inacio-dev/tcc/monografia/2-textuais/3-metodologia.tex

\chapter{Metodologia}
\label{chap:metodologia}

Este trabalho é uma pesquisa aplicada de natureza experimental, com objetivo semelhante ao de \citeonline{shaik2025design}, conforme apresentado na fundamentação teórica. A seleção de tecnologias foi exploratória: diferentes controladores e protocolos de comunicação foram testados até encontrar a combinação com menor latência. Já a caracterização do sistema final é descritiva, com medição de latência, taxa de quadros, consumo de energia e resposta háptica comparados à literatura. O procedimento de desenvolvimento segue a prototipagem evolutiva --- cada subsistema é construído, testado individualmente e integrado antes de avançar ao próximo.

O sistema de \gls{teleoperacao} possui três camadas (\autoref{fig:arquitetura-projeto}): o veículo teleoperado com Raspberry Pi 4 embarcado, o cliente PC que exibe telemetria e encaminha comandos, e o simulador Logitech G923 conectado ao cliente via \gls{USB}. Veículo e cliente se comunicam por \gls{UDP}, seguindo a abordagem de integração de múltiplos sensores de \citeonline{bobrovsky2023development}. O desenvolvimento começou pela montagem do chassi, passou pela integração dos sensores e atuadores com o Raspberry Pi, depois pela comunicação \gls{UDP} com o cliente e integração do G923, até chegar à validação do sistema completo em ambiente controlado e em campo, cujo protocolo é detalhado na \autoref{sec:protocolo-experimental}.

\begin{figure}[!h]
	\captionsetup{width=16cm}
	\Caption{\label{fig:arquitetura-projeto} Arquitetura do sistema de teleoperação com feedback háptico}
	\UFCfig{}{
		
	}{
		\Fonte{elaborado pelo autor.}
	}
\end{figure}

\section{Protocolo de Comunicação UDP}
\label{sec:protocolo-udp}

O \gls{UDP} foi adotado como protocolo de comunicação entre o veículo e o cliente pelas razões discutidas na \autoref{sec:protocolos-comunicacao}: menor \gls{latencia} que o \gls{TCP}, sem estabelecimento de conexão nem retransmissão de pacotes perdidos. Para o controle em tempo real do veículo teleoperado, qualquer atraso entre o comando do operador e a resposta do veículo torna a condução imprecisa, e o \gls{UDP} minimiza esse atraso.

\subsection{Evolução das Decisões de Arquitetura de Comunicação}
\label{subsec:evolucao-decisoes-comunicacao}

O objetivo inicial era controlar múltiplos veículos por meio de um servidor central que redirecionaria mensagens entre clientes e veículos. Na prática, as limitações de latência e a complexidade de transmitir vídeo por rádio levaram a uma arquitetura diferente.

\subsubsection{Testes com Diferentes Controladores e Tecnologias de Comunicação}

A primeira tentativa de comunicação usou um Arduino Mega com módulo ESP8266 no veículo, conectado via WiFi a um Raspberry Pi 4 (servidor) e um notebook (cliente). A latência média ficou em 60ms. O ESP8266 era o gargalo: ele precisa alternar entre modos de leitura e escrita a cada mensagem, e com o Raspberry Pi enviando pacotes a cada 1ms, o módulo simplesmente não acompanhava. O ESP32 DevKit V1 foi testado justamente pelo processador dual-core, que permite dedicar um núcleo à recepção de comandos e outro ao envio de respostas, sem a alternância que travava o ESP8266. A latência caiu para 40ms (melhoria de 33\%), mas ainda longe da meta de 10ms. Com módulos de rádio NRF24L01 com antena externa a latência chegou a 2ms, com alcance de até 800 metros. Para comandos de controle (pacotes de dezenas de bytes) o NRF24L01 funciona bem, mas para vídeo a conta não fecha: frames \gls{MJPEG} de 10 a 50~KB precisariam ser fragmentados em pacotes de 32 bytes a 2~Mbps, e escalar para mais veículos exigiria montar uma rede mesh sobre rádio --- algo que tomaria tempo demais para o cronograma disponível. A \autoref{fig:comparativo-latencia} resume as latências medidas.

\begin{figure}[!ht]
	\captionsetup{width=16cm}
	\Caption{\label{fig:comparativo-latencia} Latência média por configuração de hardware testada}
	\UFCfig{}{
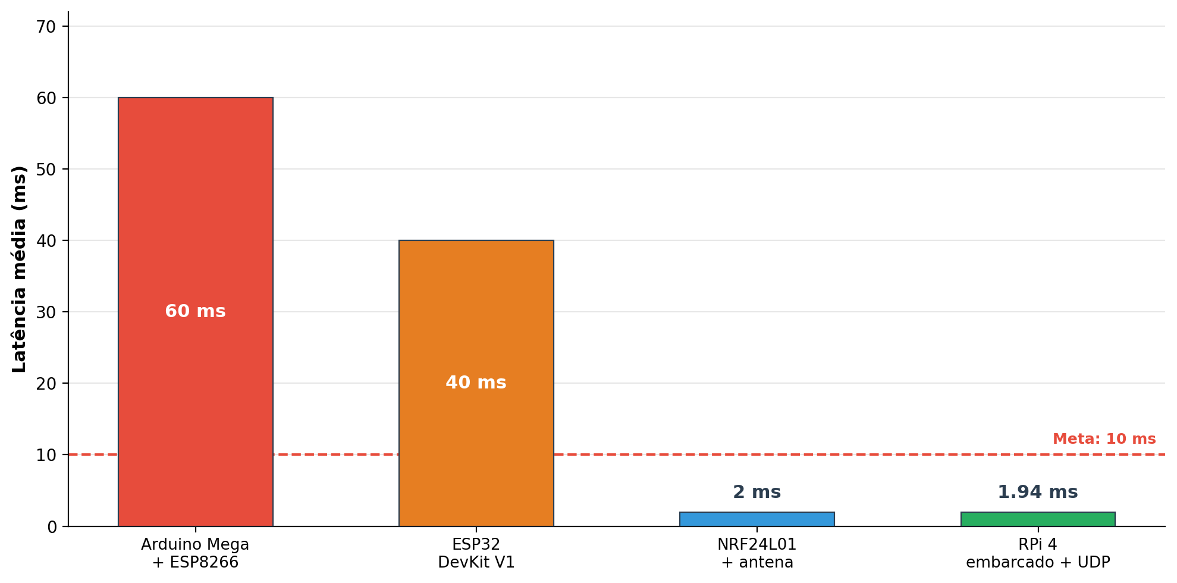
[picture p1: monografia/figuras/comparativo_latencia_comunicacao.png]
		
	}{
		\Fonte{elaborado pelo autor.}
	}
\end{figure}

Nos testes com rede mesh NRF24L01, cada salto entre antenas acrescentava cerca de 2ms e introduzia erros na resposta de status do veículo. Foi tentado usar o payload de \gls{ACK} (a confirmação automática que o NRF24L01 envia ao transmissor) para retornar dados dos sensores, mas o esforço de desenvolvimento necessário era incompatível com o cronograma do projeto. O ESP-NOW, que faz mesh entre ESP32, foi descartado pelo alcance de apenas 50 metros e custo mais alto por unidade.

\subsubsection{Decisão Final: Arquitetura UDP com Raspberry Pi e Logitech G923}

A análise comparativa dos testes (\autoref{tab:comparativo-comunicacao}) definiu a arquitetura final: protocolo \gls{UDP}, Raspberry Pi 4 embarcado no veículo e simulador Logitech G923.

\begin{table}[!h]
\captionsetup{width=16cm}
\Caption{\label{tab:comparativo-comunicacao} Comparativo de latência entre tecnologias de comunicação testadas}
\IBGEtab{}{%
	\begin{tabular}{p{5cm}p{3cm}p{3cm}p{4cm}}
		\toprule
		Configuração & Latência Média & Alcance & Observações \\
		\midrule \midrule
		Arduino Mega + ESP8266 & 60ms & WiFi local & Gargalo no ESP8266 \\
		\midrule
		ESP32 DevKit V1 & 40ms & WiFi local & Melhoria de 33\% \\
		\midrule
		NRF24L01 + antena & 2ms & 800m & Comunicação ponto-a-ponto \\
		\midrule
		NRF24L01 mesh & 2ms + 2ms/salto & Extensível & Complexidade elevada \\
		\midrule
		ESP-NOW (ESP32) & Similar ao WiFi & 50m & Custo elevado, alcance limitado \\
		\midrule
		\textbf{RPi 4 embarcado + UDP} & \textbf{1,94ms} & \textbf{WiFi local} & \textbf{Solução adotada} \\
		\bottomrule
	\end{tabular}%
}{%
\Fonte{elaborado pelo autor.}%
\Nota{Os valores de latência do Arduino Mega + ESP8266, ESP32, NRF24L01 e ESP-NOW foram obtidos em testes experimentais do autor durante a fase de prototipagem. O valor de 1,94ms do Raspberry Pi 4 corresponde à latência média UDP medida durante os testes de validação do sistema final.}%
}
\end{table}

A \autoref{tab:comparativo-latencia-literatura} (ver \autoref{sec:protocolos-comunicacao}) reúne latências \gls{UDP} reportadas na literatura, que vão de 2~ms em simulação a quase 1 segundo em topologias de simulação complexas. O valor de 1,94~ms medido neste projeto é compatível com \gls{UDP} sobre WiFi 802.11ac em rede local sem saltos intermediários.

Com o Raspberry Pi 4 embarcado no próprio veículo, captura de vídeo, codificação \gls{MJPEG} e transmissão \gls{UDP} acontecem no mesmo dispositivo, sem a necessidade de traduzir entre protocolos de rádio e rede \gls{IP} que o NRF24L01 exigiria. O Raspberry Pi acumula as funções de controlador do veículo e servidor \gls{UDP}, processando vídeo da câmera OV5647, dados do sensor BMI160 e comandos de controle. A descoberta de dispositivos na rede local usa o protocolo \gls{mDNS}: o veículo é acessível como \texttt{f1car.local} e o cliente como \texttt{f1client.local}, sem configuração manual de endereços \gls{IP}.

Durante os testes, o vídeo e os sensores cortavam simultaneamente por cerca de 5 segundos a cada 20--60 segundos de operação. A instrumentação de tempo em cada thread do Raspberry Pi revelou que o bloqueio ocorria exclusivamente nas chamadas \texttt{sendto()}, enquanto locks, \gls{I2C} e serialização \gls{JSON} operavam normalmente. A causa era dupla. Originalmente, cada chamada \texttt{sendto()} recebia o \textit{hostname} \texttt{f1client.local} como destino, o que disparava resolução \gls{mDNS} pelo Avahi --- o serviço do sistema operacional que roda em segundo plano (\textit{daemon}) e traduz nomes \texttt{.local} para endereços IP na rede. Com 160 pacotes por segundo (100Hz de sensores e 60Hz de vídeo), qualquer expiração do \textit{cache} \gls{mDNS} bloqueava ambos os \textit{sockets} por exatamente 5 segundos, que é o \textit{timeout} padrão do Avahi. A correção foi resolver o \textit{hostname} uma única vez na inicialização via \texttt{socket.gethostbyname()} e armazenar o \gls{IP} numérico, re-resolvendo apenas quando o veículo envia um comando \texttt{CONNECT} (para atualizar o \gls{IP} caso o \gls{DHCP} tenha atribuído outro endereço). O segundo fator era o gerenciamento de energia WiFi: o \textit{driver} \texttt{brcmfmac} do Raspberry Pi 4 desliga periodicamente a antena WiFi para economizar energia, e enquanto a antena está desligada, qualquer \texttt{sendto()} fica bloqueado esperando a reativação. A desativação permanente via NetworkManager (\texttt{wifi.powersave = 2}) eliminou esses bloqueios. O \autoref{alg:resolucao-mdns} descreve o procedimento de resolução e cache de IP adotado em ambos os lados da comunicação (veículo e cliente).

\begin{algorithm}[h!]
	\SetSpacedAlgorithm
	\caption{\label{alg:resolucao-mdns}Resolução \gls{mDNS} com cache de \gls{IP}}
	\Entrada{hostname\_destino (ex: ``f1client.local'')}
	\Saida{ip\_numerico utilizado em todas as chamadas sendto()}
	\Inicio{
		// Fase 1: Resolução única na inicialização\;
		\Se{hostname\_destino contém ``.local''}{
			ip\_numerico $\leftarrow$ resolver\_dns(hostname\_destino)\;
			\Se{resolução falhou}{
				ip\_numerico $\leftarrow$ hostname\_destino\;
				// Usa hostname direto como fallback\;
			}
		}
		\Senao{
			ip\_numerico $\leftarrow$ hostname\_destino\;
		}
		registrar\_cliente(ip\_numerico, porta)\;
		// Fase 2: Todas as transmissões usam IP numérico\;
		\Para{cada pacote a enviar}{
			sendto(dados, ip\_numerico, porta)\;
			// Sem resolução DNS --- envio direto\;
		}
		// Fase 3: Re-resolução sob demanda (comando CONNECT)\;
		\Se{comando CONNECT é enviado}{
			novo\_ip $\leftarrow$ resolver\_dns(hostname\_destino)\;
			\Se{novo\_ip $\neq$ ip\_numerico}{
				ip\_numerico $\leftarrow$ novo\_ip\;
				atualizar\_cliente(ip\_numerico, porta)\;
			}
		}
	}
\end{algorithm}

A comunicação utiliza três portas \gls{UDP} separadas (\autoref{tab:arquitetura-portas-udp}). A separação existe porque pacotes de vídeo de 50 KB bloqueariam pacotes de sensores de 200 bytes se compartilhassem a mesma porta, e o sistema de \gls{forcefeedback} precisa de taxa consistente de 100Hz com latência inferior a 10ms para que a resposta tátil no volante seja perceptível.

\begin{table}[!h]
\captionsetup{width=16cm}
\Caption{\label{tab:arquitetura-portas-udp} Arquitetura de comunicação UDP com três portas separadas}
\IBGEtab{}{%
	\begin{tabular}{ccp{5cm}ccc}
		\toprule
		Porta & Direção & Conteúdo & Taxa & Pacote & Buffer \\
		\midrule \midrule
		9999 & RPi $\rightarrow$ PC & Vídeo \gls{MJPEG} + energia + temperatura & 60Hz & 10--50 KB & 64 KB \\
		\midrule
		9997 & RPi $\rightarrow$ PC & Sensores BMI160 (aceleração e giroscópio) & 100Hz & 200 B & 32 KB \\
		\midrule
		9998 & Bidirecional & Comandos de controle (direção, acelerador e freio a 100Hz; troca de marcha sob demanda) & 100Hz + on-demand & 50 B & 128 KB \\
		\bottomrule
	\end{tabular}%
}{%
\Fonte{elaborado pelo autor.}%
}
\end{table}

O simulador Logitech G923, detalhado na \autoref{sec:arquitetura-simulador}, conecta-se ao cliente PC via \gls{USB} e é acessado pelo sistema operacional como dispositivo \gls{HID} padrão, sem necessidade de drivers proprietários. A arquitetura final tem dois saltos de comunicação: Veículo $\leftrightarrow$ Cliente $\leftrightarrow$ Simulador.

\subsection{Justificativa para UDP Simples}
\label{subsec:justificativa-udp}

O UDP simples foi escolhido em vez de variantes como UDP-RT \cite{lu2023udprt} ou UDP com ACK \cite{bekele2024performance}, cujos trade-offs foram discutidos na \autoref{sec:protocolos-comunicacao}. Em rede local WiFi 802.11ac, a perda de pacotes já é desprezível, e o custo extra de CPU que o ACK introduz (28 a 33\% segundo \citeonline{bekele2024performance}) não se justifica.

A razão principal para o \gls{UDP} neste projeto é o comportamento diante de perda de pacotes. Com \gls{UDP}, quando um frame de vídeo é perdido, o próximo é exibido normalmente --- o operador percebe no máximo uma queda pontual de \textit{frame rate}. Com TCP, a perda de um pacote trava a entrega de todos os seguintes até a retransmissão ser concluída (\textit{head-of-line blocking}). Em uma transmissão a 60~Hz, essa retransmissão acumula dezenas de frames no buffer: o vídeo congela e depois descarta os frames acumulados de uma vez. Para sensores a 100~Hz, o problema é pior: o \textit{force feedback} depende de dados atualizados, e receber um pacote de sensor com 50~ms de atraso por retransmissão TCP produz uma resposta tátil que não corresponde mais ao estado do veículo. Em operação de tempo real, perder um dado antigo é melhor do que atrasar um dado novo.

Os \textit{buffers} de \textit{socket} foram dimensionados de acordo com cada tipo de tráfego: 64~KB para a porta de vídeo (porta 9999), onde frames de até 50~KB precisam caber inteiros; 32~KB para a porta de sensores (porta 9997), onde o pacote é pequeno mas a latência precisa ser baixa para o \textit{force feedback}; e 128~KB para a recepção de comandos no Raspberry Pi (porta 9998), para absorver picos de comandos simultâneos. \textit{Buffers} maiores absorvem picos de tráfego, mas os dados ficam mais tempo na fila antes de serem consumidos; \textit{buffers} menores descartam pacotes quando o consumidor não acompanha a taxa de produção, mas garantem que o dado lido é sempre recente.

As latências de \texttt{sendto()} medidas no sistema final após essas correções são apresentadas no \autoref{chap:resultados}, juntamente com as demais métricas de validação da comunicação \gls{UDP}.

\subsection{Limitações de Alcance e Considerações de Escala}
\label{subsec:limitacoes-alcance}

O alcance do WiFi limita o tamanho da pista em que o veículo pode operar. Na escala 1:5, circuitos de Fórmula 1 reais teriam entre 600 m (Mônaco, 3,337 km real) e 1.400 m (Spa-Francorchamps, 7,004 km real) de comprimento.

A \autoref{tab:alcance-wifi-pistas} mostra a viabilidade de cobertura WiFi para pistas nessa escala, com soluções de infraestrutura para cada faixa de distância.

\begin{table}[!h]
\captionsetup{width=16cm}
\Caption{\label{tab:alcance-wifi-pistas} Análise de cobertura WiFi para pistas de F1 em escala 1:5}
\IBGEtab{}{%
	\begin{tabular}{p{4cm}p{2.5cm}p{2.5cm}p{5.5cm}}
		\toprule
		Circuito Real & Extensão Real & Escala 1:5 & Solução de Cobertura \\
		\midrule \midrule
		Mônaco & 3,337 km & 667 m & Roteador central + 1 repetidor \\
		\midrule
		Interlagos & 4,309 km & 862 m & 2 access points mesh \\
		\midrule
		Silverstone & 5,891 km & 1.178 m & 3 access points mesh \\
		\midrule
		Spa-Francorchamps & 7,004 km & 1.401 m & 4 access points mesh ou 5G \\
		\bottomrule
	\end{tabular}%
}{%
\Fonte{elaborado pelo autor.}%
}
\end{table}

Para pistas de até 600 m (circuitos compactos como Mônaco), um sistema mesh WiFi como o TP-Link Deco M4 (AC1200, até 350~m² com 2 unidades, potência $<$20~dBm em 2,4~GHz e $<$23~dBm em 5~GHz) com unidades conectadas por cabo Ethernet oferece cobertura adequada em ambiente aberto. Pistas maiores precisam de unidades adicionais do sistema mesh, acrescentando cerca de 2 ms de latência por salto. Redes 5G são outra opção, com cobertura mais ampla e latência menor, mas dependem de operadoras e custam mais.

% ============================================================================
% ARQUITETURA DO VEÍCULO (RASPBERRY PI 4)
% ============================================================================
\section{Arquitetura do Veículo (Raspberry Pi 4)}
\label{sec:arquitetura-veiculo}

O processador embarcado no veículo é um Raspberry Pi 4 Model B com 8GB de \gls{RAM}. O hardware foi escolhido porque consegue codificar vídeo \gls{MJPEG} em tempo real, comunicar via \gls{UDP} nativo e controlar múltiplos periféricos \gls{I2C} simultaneamente, conforme validado nos testes descritos na \autoref{subsec:evolucao-decisoes-comunicacao}. O diagrama elétrico completo está no \autoref{apendice:diagrama-rpi}.

O software embarcado foi escrito em Python 3.11.2 no Visual Studio Code. A \autoref{tab:bibliotecas-rpi} lista as bibliotecas utilizadas e a \autoref{tab:componentes-veiculo} lista os componentes embarcados no veículo.

\begin{table}[!h]
\captionsetup{width=16cm}
\Caption{\label{tab:bibliotecas-rpi} Bibliotecas Python utilizadas no Raspberry Pi}
\IBGEtab{}{
\begin{tabular}{p{4.5cm}p{10cm}}
\toprule
\textbf{Biblioteca} & \textbf{Função} \\
\midrule
picamera2 & Captura de vídeo via interface \gls{CSI} com codificação \gls{MJPEG} por hardware \\
smbus2 & Comunicação \gls{I2C} direta com sensores BMI160 e INA219 \\
pyserial & Comunicação serial \gls{USB} com Arduino Pro Micro para monitoramento de energia \\
adafruit-circuitpython-pca9685 & Controle do driver \gls{PWM} PCA9685 para acionamento de servos \\
adafruit-circuitpython-motor & Controle de servomotores via classe \texttt{Servo} do módulo \texttt{adafruit\_motor} \\
adafruit-blinka & Camada de compatibilidade CircuitPython para Raspberry Pi (módulos \texttt{board} e \texttt{busio}) \\
RPi.GPIO & Controle de pinos \gls{GPIO} para \gls{ponteh} BTS7960 do motor DC \\
numpy & Processamento numérico de dados de sensores e cálculos de telemetria \\
\bottomrule
\end{tabular}
}{
\Fonte{elaborado pelo autor.}
}
\end{table}

\begin{table}[!h]
\captionsetup{width=16cm}
\Caption{\label{tab:componentes-veiculo} Especificações dos componentes do veículo teleoperado}
\IBGEtab{}{%
	\begin{tabular}{p{3.5cm}p{6cm}p{6cm}}
		\toprule
		Componente & Especificação & Função no Sistema \\
		\midrule \midrule
		Raspberry Pi 4 Model B & Broadcom BCM2711, Quad core Cortex-A72 64-bit @ 1.8GHz, 8GB RAM & Núcleo de controle e comunicação do veículo, servidor \gls{UDP}, processamento de vídeo e controle de sensores \\
		\midrule
		Câmera OV5647 & 5MP, 2592×1944 pixels, vídeo até 1080p/30fps, interface CSI & Captura de vídeo em 640×480/60fps para transmissão via \gls{UDP} \\
		\midrule
		Sensor BMI160 \cite{bosch2015bmi160} & \gls{IMU} 6 eixos, ±2g/±250°/s, 16 bits, \gls{I2C}, 100Hz sampling & Detecção de \glspl{forcag}, aceleração e velocidade angular para force feedback \\
		\midrule
		Motor DC 775 & 24V, 12.000 RPM, com transmissão manual de 5 marchas & Propulsão principal do veículo com zonas de eficiência F1 \\
		\midrule
		Ponte H BTS7960 \cite{infineon2013btn7960} & 5.5--27Vdc, corrente contínua 40A, proteção térmica integrada & Controle bidirecional de velocidade do motor de propulsão \\
		\midrule
		Servo MG996R (3x) & 4.8--7.2V, torque 11kg.cm, rotação 180°, velocidade 0.14s/60° & Controle de direção e sistema de freio dianteiro/traseiro \\
		\midrule
		PCA9685 PWM Driver \cite{nxp2015pca9685} & 16 canais, 12 bits, \gls{I2C}, endereço \texttt{0x41} (A0 soldado) & Controle de servos (freio dianteiro, traseiro e direção) \\
		\midrule
		Arduino Pro Micro & ATmega32U4, 16MHz, ADC 10 bits, USB nativo & Leitura de sensores ACS758 e tensão da bateria via USB serial \\
		\midrule
		INA219 \cite{ti2015ina219} & Sensor corrente/tensão, \gls{I2C}, endereço \texttt{0x40} & Monitoramento de energia do Raspberry Pi \\
		\midrule
		Sensor DS18B20 \cite{maxim2019ds18b20} & Digital 1-Wire, $-55$°C a $+125$°C, precisão $\pm0{,}5$°C & Monitoramento de temperatura do motor e eletrônica \\
		\midrule
		ACS758 100A \cite{allegro2018acs758} & Sensor Hall, sensibilidade 20mV/A, largura de banda 120kHz & Medição de corrente do motor DC 775 via Arduino Pro Micro \\
		\midrule
		ACS758 50A \cite{allegro2018acs758} & Sensor Hall, sensibilidade 40mV/A, largura de banda 120kHz & Medição de corrente dos servos via Arduino Pro Micro \\
		\midrule
		Regulador XL4015 \cite{xlsemi2017xl4015} & Step-down 8--36V para 1.25--32V, 5A, eficiência 96\% & Alimentação 5V do Raspberry Pi a partir da bateria \\
		\midrule
		UBEC 15A & 6--12S entrada, 5.25V saída, 15A contínuo, 30A pico & Alimentação dos servos MG996R \\
		\midrule
		Bateria \gls{LiPo} 3S & Turnigy Graphene 6000mAh, 11.1V, 75C descarga & Fonte de energia principal do veículo \\
		\midrule
		Caixa Diferencial HSP 1:10 & Modelo 94111/94123, relação 02051 & Transmissão diferencial para rodas traseiras \\
		\midrule
		Rolamento Unidirecional CSK8PP & $8\times22\times9$mm, uma direção de rotação & Proteção contra torque reverso no eixo do motor de propulsão \\
		\midrule
		Amortecedores RC 1:10 & Compatível Axial SCX10/TRX4, óleo ajustável & Suspensão do veículo com amortecimento ajustável \\
		\midrule
		Chassi FV01 & Escala 1:5 (modificada), impressão 3D em \gls{PLA}, pneus de borracha & Estrutura do veículo com suspensão push rod e aerodinâmica funcional \\
		\bottomrule
	\end{tabular}%
}{%
\Fonte{elaborado pelo autor.}%
}
\end{table}

\subsection{Chassi e Estrutura}
\label{subsec:chassi-estrutura-veiculo}

O veículo utiliza o chassi FV01, um modelo de carro de Fórmula 1 projetado para impressão 3D por \citeonline{velocityprojects2024fv01}. O modelo original possui escala 1:7, porém foi modificado para escala 1:5 neste projeto para acomodar o Raspberry Pi 4, sensores, drivers e demais componentes eletrônicos. O chassi foi impresso em PLA com pneus de borracha para melhor aderência.

A suspensão push rod independente transmite as forças de curva e frenagem ao chassi, onde o sensor BMI160 as detecta como variações de força G. O diferencial gera comportamento diferenciado entre rodas internas e externas em curvas.

As peças foram impressas em uma Creality Ender 3 S1 com fatiamento no Ultimaker Cura 5.11 \cite{ultimaker2024cura}. Os parâmetros de impressão estão no \autoref{apendice:specs-equipamentos}. A \autoref{fig:chassi-fv01} mostra o modelo original do chassi FV01.

\begin{figure}[!ht]
	\captionsetup{width=16cm}
	\Caption{\label{fig:chassi-fv01} Modelo do chassi FV01 projetado para impressão 3D}
	\UFCfig{}{
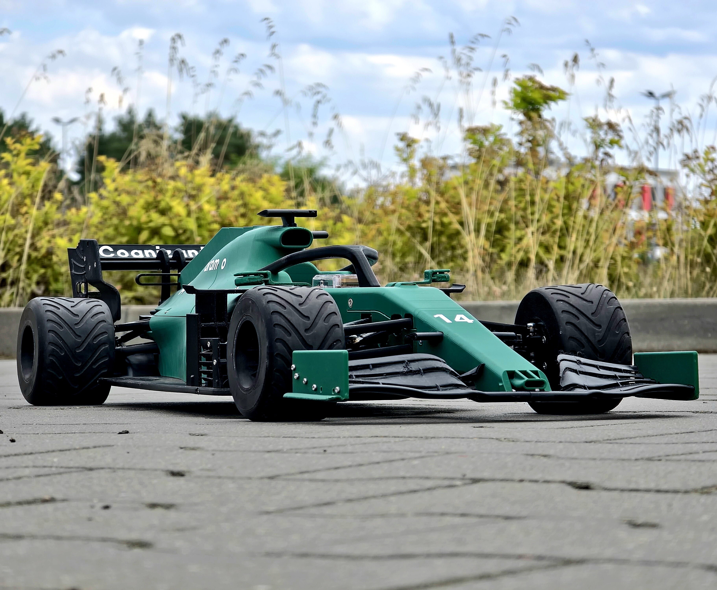
[picture p2: monografia/figuras/FV01-1.jpg]
		
	}{
		\Fonte{\citeonline{velocityprojects2024fv01}.}
	}
\end{figure}

As modificações de escala e a disposição interna dos componentes foram planejadas no Tinkercad \cite{autodesk2024tinkercad}. Na \autoref{fig:tinkercad-layout}, a bateria LiPo 3S (em vermelho) ocupa a região central inferior e o motor DC 775 com a transmissão (em laranja) fica na parte traseira. A simulação confirmou que a escala 1:5 deixa espaço suficiente para os componentes eletrônicos.

\begin{figure}[!ht]
	\captionsetup{width=16cm}
	\Caption{\label{fig:tinkercad-layout} Simulação no Tinkercad da organização interna dos componentes no chassi FV01 modificado}
	\UFCfig{}{
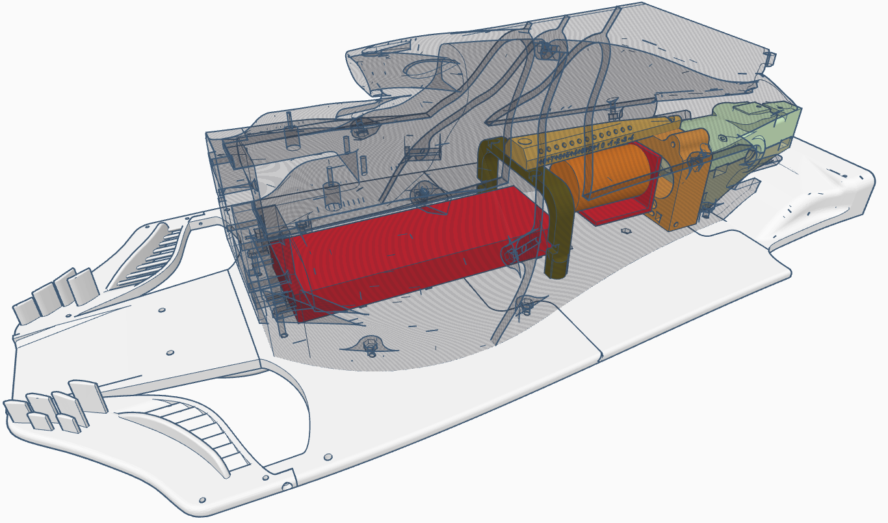
[picture p3: monografia/figuras/thinckercad.png]
		
	}{
		\Fonte{elaborado pelo autor.}
	}
\end{figure}

\subsection{Sistema de Sensoriamento}
\label{subsec:sensoriamento-veiculo}

Os sensores do veículo capturam dados em tempo real e os transmitem ao cliente via \gls{UDP}, onde são processados para telemetria e cálculo de \textit{force feedback}.

\subsubsection{Câmera OV5647}

A câmera OV5647, conectada via interface \gls{CSI}, opera em duas resoluções selecionáveis: 480p (640$\times$480) e 720p (1280$\times$720). A resolução padrão é 480p a 30 \gls{FPS}, por consumir menos banda na transmissão \gls{UDP}. O operador pode alternar entre 480p e 720p pela interface do cliente, que envia o comando ao Raspberry Pi via \gls{UDP}. O stream de vídeo é codificado em \gls{MJPEG} (Motion JPEG), onde cada frame é comprimido independentemente como imagem JPEG. Essa escolha foi motivada pela robustez contra perda de pacotes \gls{UDP}: enquanto codecs como H.264 utilizam P-frames que dependem de frames anteriores (causando distorção em cascata quando há perda de pacotes), o \gls{MJPEG} transmite frames independentes, limitando o impacto de perdas a um único frame. O trade-off é maior uso de banda (aproximadamente 4x mais que H.264), compensado pela qualidade de imagem consistente e simplicidade de decodificação via OpenCV.

\subsubsection{Sensor IMU BMI160}

O sensor inercial BMI160 conectado via barramento \gls{I2C} (endereço \texttt{0x68}) fornece dados de aceleração (3 eixos) e velocidade angular (3 eixos) a 100Hz. A configuração utiliza faixa de $\pm$2g para acelerômetro e $\pm$250°/s para giroscópio, que oferecem maior resolução (61~$\mu$g/LSB e 7,6~m°/s/LSB) para captura de forças G em manobras típicas de veículos RC. Os dados são transmitidos ao cliente em formato \gls{JSON} via \gls{UDP}, onde são processados para cálculo de force feedback e estimativa de velocidade.

O BMI160 é suscetível a \textit{brown-out} elétrico durante picos de corrente do motor DC 775, que causam quedas momentâneas de tensão no barramento 3,3V do Raspberry Pi. Quando isso ocorre, o sensor realiza um \textit{power-on reset} interno e entra em modo \textit{suspend}, onde os registradores de dados retornam zero indefinidamente apesar de o barramento \gls{I2C} continuar funcionando. Para mitigar esse problema, o software implementa um \textit{watchdog} que monitora leituras consecutivas zeradas. Após 3 leituras zeradas consecutivas (30ms a 100Hz), o sistema executa uma rotina de recuperação que reativa a unidade de gerenciamento de energia (PMU) do sensor, reconfigura os parâmetros de faixa e taxa de amostragem, e verifica o sucesso da recuperação. Os tempos de recuperação seguem as especificações do \textit{datasheet} BST-BMI160-DS000-09: 3,8ms para ativação do acelerômetro e 80ms para o giroscópio. Caso a reativação da PMU falhe, o sistema executa um \textit{soft reset} completo do sensor como segunda tentativa de recuperação.

\subsubsection{Monitoramento de Temperatura}

O sensor digital DS18B20 \cite{maxim2019ds18b20} conectado via protocolo 1-Wire (GPIO4) monitora a temperatura do motor e da eletrônica embarcada a 1Hz. O sensor possui faixa de $-55$°C a $+125$°C com precisão de $\pm0{,}5$°C e validação de dados por CRC. O software implementa alertas térmicos em três níveis: aviso a 65°C, crítico a 80°C e desligamento automático a 85°C. Os dados de temperatura são incluídos nos pacotes \gls{UDP} da porta 9999 e exibidos na interface do cliente.

\subsubsection{Monitoramento de Energia}

O sistema de monitoramento de energia utiliza uma arquitetura híbrida com dois subsistemas complementares: um Arduino Pro Micro (ATmega32U4) dedicado à leitura dos sensores de corrente ACS758 e tensão da bateria, e um sensor INA219 (endereço \gls{I2C} \texttt{0x40}) para monitoramento de corrente e tensão do Raspberry Pi.

Inicialmente, o projeto utilizava um ADC externo ADS1115 (16 bits, \gls{I2C}) conectado diretamente ao Raspberry Pi para leitura dos sensores ACS758. Essa abordagem foi abandonada por incompatibilidade de referência de tensão: os ACS758 possuem saída ratiométrica (ponto zero em VCC/2), porém o ADS1115 opera com referência interna própria (PGA configurável), incapaz de acompanhar variações na alimentação dos sensores. Na prática, uma queda de 5,00V para 4,90V no VCC dos ACS758 deslocava o offset zero em 50mV, introduzindo erro de 2,5A no sensor de 100A (sensibilidade de 20mV/A). Além disso, cada ciclo de leitura do ADS1115 (três canais multiplexados) ocupava aproximadamente 25ms do barramento \gls{I2C}, já compartilhado com BMI160 (100Hz), PCA9685 e INA219. O ADS1115 também não dispunha de canal livre para medição da tensão da bateria.

A migração para o Arduino Pro Micro eliminou esses problemas através de medição ratiométrica: como o Pro Micro e os ACS758 compartilham a mesma alimentação de 5V, qualquer variação de tensão afeta o ADC e os sensores igualmente, cancelando automaticamente o erro. O Pro Micro realiza oversampling de 50 amostras por leitura em cada canal analógico, reduzindo o ruído por um fator de $\sqrt{50} \approx 7$. Os dados são transmitidos ao Raspberry Pi via USB serial dedicado a 115200 baud no formato \texttt{PWR:<v\_bat>,<i\_servos>,<i\_motor>} a 10Hz, liberando completamente o barramento \gls{I2C} para os demais sensores. A tensão da bateria LiPo 3S é medida através de um divisor resistivo (20k$\Omega$/10k$\Omega$) no pino A0, com razão de 1:3 que mantém a tensão no ADC dentro da faixa segura de 0--5V. Os valores de calibração (offset zero de cada ACS758) são armazenados na EEPROM do ATmega32U4, persistindo entre reinicializações.

O sensor INA219 permanece no barramento \gls{I2C} para monitoramento do Raspberry Pi, pois opera na faixa de corrente de 0--3,2A com resolução de 0,8mA, muito superior à precisão dos ACS758 nessa faixa. Cada saída dos sensores ACS758 possui um filtro RC de hardware (1k$\Omega$ + 100nF, frequência de corte de 1,6kHz) para remoção de ruído eletromagnético do motor e chaveamento da ponte H antes da amostragem pelo ADC.

\subsection{Controle de Propulsão e Direção}
\label{subsec:propulsao-direcao-veiculo}

O sistema de propulsão utiliza motor DC 775 de 24V controlado por ponte H BTS7960, enquanto direção e freios são acionados por servos MG996R através do driver PWM PCA9685 (endereço \gls{I2C} \texttt{0x41}, com pino A0 soldado para evitar conflito com o INA219 no endereço padrão \texttt{0x40}).

\subsubsection{Motor de Propulsão}

O motor DC 775 opera com transmissão manual de 5 marchas, simulando comportamento de veículo real. O controle de velocidade é realizado via PWM através do driver BTS7960. A dinâmica de aceleração é modelada como um sistema de 1ª ordem conforme descrito por \citeonline{franklin2013sistemas} (ver \autoref{subsec:sistemas-primeira-ordem}), cuja função de transferência no domínio de Laplace é:

\begin{equation}
\label{eq:funcao-transferencia}
G(s) = \frac{Y(s)}{U(s)} = \frac{K}{\tau_{eff} \cdot s + 1}
\end{equation}

\noindent onde $Y(s)$ é o PWM do motor (saída), $U(s)$ é a entrada degrau unitário, $K$ é o ganho estático (igual ao PWM alvo da marcha, ou seja, o limitador) e $\tau_{eff}$ é a constante de tempo efetiva. A equação diferencial ordinária correspondente no domínio do tempo é:

\begin{equation}
\label{eq:ode-motor}
\tau_{eff} \cdot \frac{dy}{dt} + y(t) = K \cdot u(t)
\end{equation}

\noindent cuja solução para entrada degrau é a resposta exponencial:

\begin{equation}
\label{eq:resposta-degrau}
y(t) = K \cdot \left(1 - e^{-t/\tau_{eff}}\right)
\end{equation}

Nessa formulação, conforme as propriedades dos sistemas de primeira ordem \cite{franklin2013sistemas}, o PWM atinge 63,2\% do valor final em $t = \tau_{eff}$ e 95\% em $t = 3\tau_{eff}$, com convergência monotônica e sem \textit{overshoot}. A solução analítica da \autoref{eq:resposta-degrau} assume $\tau$ constante durante toda a resposta, mas neste sistema o $\tau_{eff}$ muda toda vez que o PWM cruza de uma zona de eficiência para outra. Para lidar com essa variação, a implementação utiliza o método de Euler \cite{ruggiero1996calculo}, que recalcula $\tau_{eff}$ a cada iteração.

Isolando a derivada na \autoref{eq:ode-motor}:

\begin{equation}
\label{eq:derivada-isolada}
\frac{dy}{dt} = \frac{K \cdot u(t) - y(t)}{\tau_{eff}}
\end{equation}

\noindent O método de Euler (ver \autoref{eq:metodo-euler}) aproxima a derivada por uma diferença finita, $\frac{dy}{dt} \approx \frac{\Delta y}{\Delta t}$. Substituindo na \autoref{eq:derivada-isolada} e multiplicando ambos os lados por $\Delta t$:

\begin{equation}
\label{eq:euler-motor}
\Delta y = \frac{K - y}{\tau_{eff}} \cdot \Delta t
\end{equation}

\noindent A cada iteração do software embarcado ($\Delta t = 0{,}01$~s, 100~Hz), o incremento $\Delta y$ é calculado e somado ao PWM atual. Quando o PWM está longe do target, o erro $(K - y)$ é grande e o passo é grande; conforme se aproxima, o passo diminui, produzindo a curva exponencial. Como o $\tau_{eff}$ é recalculado a cada iteração, o sistema responde corretamente mesmo quando o PWM cruza de uma zona de eficiência para outra durante a resposta.

A constante de tempo efetiva combina dois fatores --- a marcha e a zona de eficiência:

\begin{equation}
\label{eq:tau-efetivo}
\tau_{eff}(g, zona) = \tau_{base}(g) \times M_{zona}
\end{equation}

\noindent onde $\tau_{base}(g)$ cresce com a marcha (2~s na 1ª até 10~s na 5ª, refletindo maior inércia em marchas altas) e $M_{zona}$ é o multiplicador da zona de eficiência: $M_{IDEAL} = 1{,}0$, $M_{SUB} = 10{,}0$ e $M_{POOR} = 25{,}0$. Esses valores foram ajustados durante a prototipagem evolutiva: cada conjunto era implementado, testado em condução real e corrigido até que a penalização por operar na marcha errada fosse perceptível ao operador sem tornar o veículo inoperável nas zonas desfavoráveis. Na zona IDEAL, o sistema responde com $\tau_{base}$; na zona SUBOPTIMAL, a resposta é 10 vezes mais lenta; na zona POOR, 25 vezes mais lenta. A zona é classificada pelo PWM atual do motor (não pelo target), de modo que a penalização ocorre em tempo real conforme o motor sai da faixa ideal. Isso força o operador a utilizar a marcha adequada para a faixa em que o motor está operando. O efeito reproduz o comportamento de uma transmissão real, onde manter uma marcha alta em baixa rotação resulta em resposta lenta.

A \autoref{tab:gear-params} resume os parâmetros por marcha, calibrados em testes de bancada e em campo. Os limitadores definem o ganho $K$ (PWM máximo quando o acelerador está em 100\%) conforme a faixa de rotação útil do motor DC 775 em cada relação de transmissão. As faixas ideal\_low e ideal\_high delimitam a zona IDEAL e foram ajustadas para que a aceleração fosse progressiva dentro de cada marcha. As zonas ideais de marchas adjacentes se sobrepõem (por exemplo, a 2ª cobre 6--15\% e a 1ª cobre 0--7\%), garantindo que no ponto de troca o PWM já esteja na zona IDEAL da próxima marcha. O teto absoluto de PWM foi fixado em 50\% para proteger o diferencial mecânico, que apresentou falhas nos primeiros testes de bancada com o motor em rotação plena.

\begin{table}[!ht]
	\centering
	\Caption{\label{tab:gear-params} Parâmetros por marcha do sistema de transmissão}
	\UFCtab{}{
		\begin{tabular}{ccccccc}
			\toprule
			Marcha & $K$ (limitador) & Zona IDEAL & $\tau_{base}$ & $\tau_{IDEAL}$ & $\tau_{SUB}$ & $\tau_{POOR}$ \\
			\midrule
			1ª & 10\% & 0--7\% & 2,0~s & 2~s & 20~s & 50~s \\
			2ª & 20\% & 6--15\% & 4,0~s & 4~s & 40~s & 100~s \\
			3ª & 30\% & 12--25\% & 6,0~s & 6~s & 60~s & 150~s \\
			4ª & 40\% & 22--35\% & 8,0~s & 8~s & 80~s & 200~s \\
			5ª & 50\% & 32--48\% & 10,0~s & 10~s & 100~s & 250~s \\
			\bottomrule
		\end{tabular}
	}{
		\Fonte{elaborado pelo autor.}
	}
\end{table}

A \autoref{fig:zonas-eficiencia-marchas} ilustra as zonas de eficiência por marcha. Na zona IDEAL (verde), $\tau_{eff} = \tau_{base}$; na SUBOPTIMAL (laranja), $\tau_{eff} = 10 \times \tau_{base}$; na POOR (vermelho), $\tau_{eff} = 25 \times \tau_{base}$. A margem da zona SUBOPTIMAL corresponde a 25\% da largura da zona IDEAL em cada borda, com mínimo de 2\%. A 1ª marcha inicia em 0\% de PWM, de modo que a modelagem cobre continuamente a faixa operacional limitada (0--50\%) sem descontinuidades.

\begin{figure}[!ht]
	\captionsetup{width=16cm}
	\Caption{\label{fig:zonas-eficiencia-marchas} Zonas de eficiência por marcha com constantes de tempo $\tau_{base}$}
	\UFCfig{}{
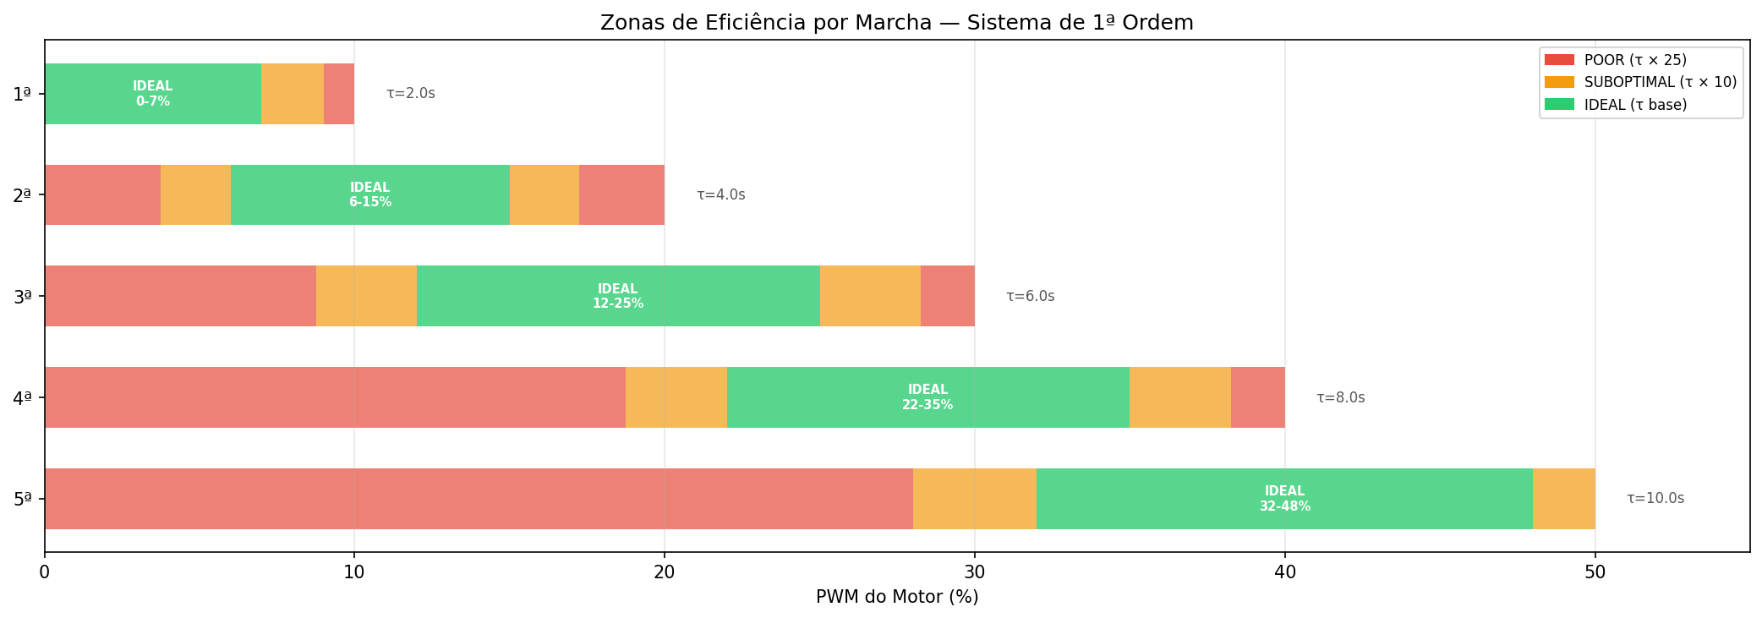
[picture p4: monografia/figuras/zonas_eficiencia_marchas.png]
		
	}{
		\Fonte{elaborado pelo autor.}
	}
\end{figure}

A \autoref{fig:tau-detalhado} detalha o cálculo de $\tau_{eff}$ para cada marcha, mostrando como a constante de tempo varia em função do PWM e da zona de eficiência. Os degraus entre zonas refletem os multiplicadores discretos $M_{zona}$, e o painel resumo apresenta a função de transferência, a resposta ao degrau e a tabela completa de $\tau_{eff}$.

\begin{figure}[!ht]
	\captionsetup{width=16cm}
	\Caption{\label{fig:tau-detalhado} Constante de tempo $\tau_{eff}$ por marcha --- detalhamento dos cálculos com $G(s) = K/(\tau s + 1)$}
	\UFCfig{}{
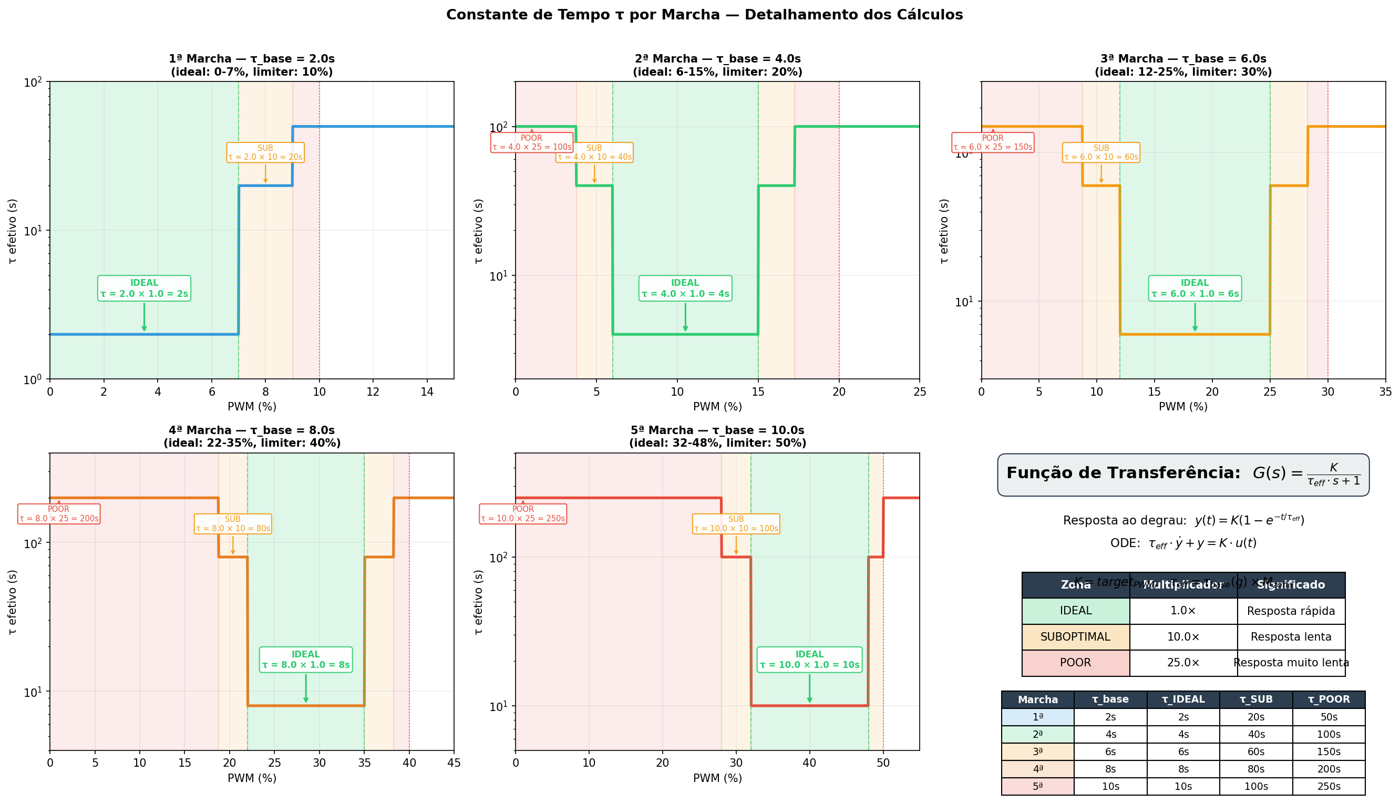
[picture p5: monografia/figuras/tau_detalhado_calculos.png]
		
	}{
		\Fonte{elaborado pelo autor.}
	}
\end{figure}

A \autoref{fig:resposta-degrau} apresenta a resposta ao degrau $y(t) = K(1 - e^{-t/\tau_{eff}})$ para cada marcha com acelerador em 100\%. Na zona IDEAL (verde), o PWM sobe rapidamente até o limitador. Ao ultrapassar a zona IDEAL e entrar na zona SUBOPTIMAL (laranja) ou POOR (vermelho), $\tau_{eff}$ aumenta e a curva desacelera, evidenciando a penalização por operar na marcha errada.

\begin{figure}[!ht]
	\captionsetup{width=16cm}
	\Caption{\label{fig:resposta-degrau} Resposta ao degrau por marcha --- $y(t) = K(1 - e^{-t/\tau_{eff}})$}
	\UFCfig{}{
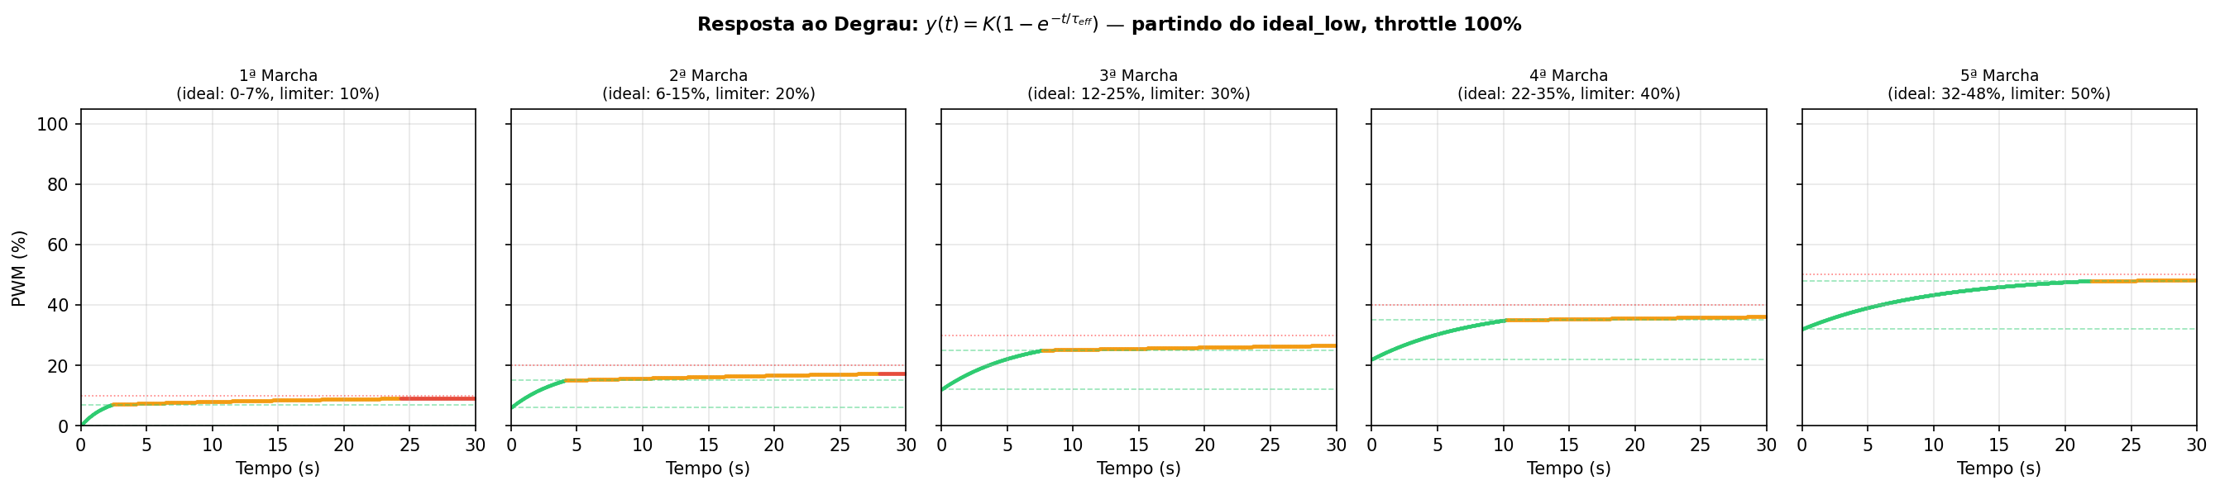
[picture p6: monografia/figuras/resposta_degrau_marchas.png]
		
	}{
		\Fonte{elaborado pelo autor.}
	}
\end{figure}

A \autoref{fig:ode-decomposicao} decompõe a equação diferencial durante uma simulação de aceleração da 1ª à 5ª marcha. O painel superior mostra o PWM $y(t)$ perseguindo o alvo $K$; o segundo mostra o erro $e(t) = K - y(t)$; o terceiro mostra $\tau_{eff}$, que salta a cada troca de marcha e entre zonas; o inferior mostra a taxa de variação $\dot{y} = (K - y)/\tau_{eff}$.

\begin{figure}[!ht]
	\captionsetup{width=16cm}
	\Caption{\label{fig:ode-decomposicao} Decomposição da equação diferencial durante aceleração completa 1ª--5ª marcha}
	\UFCfig{}{
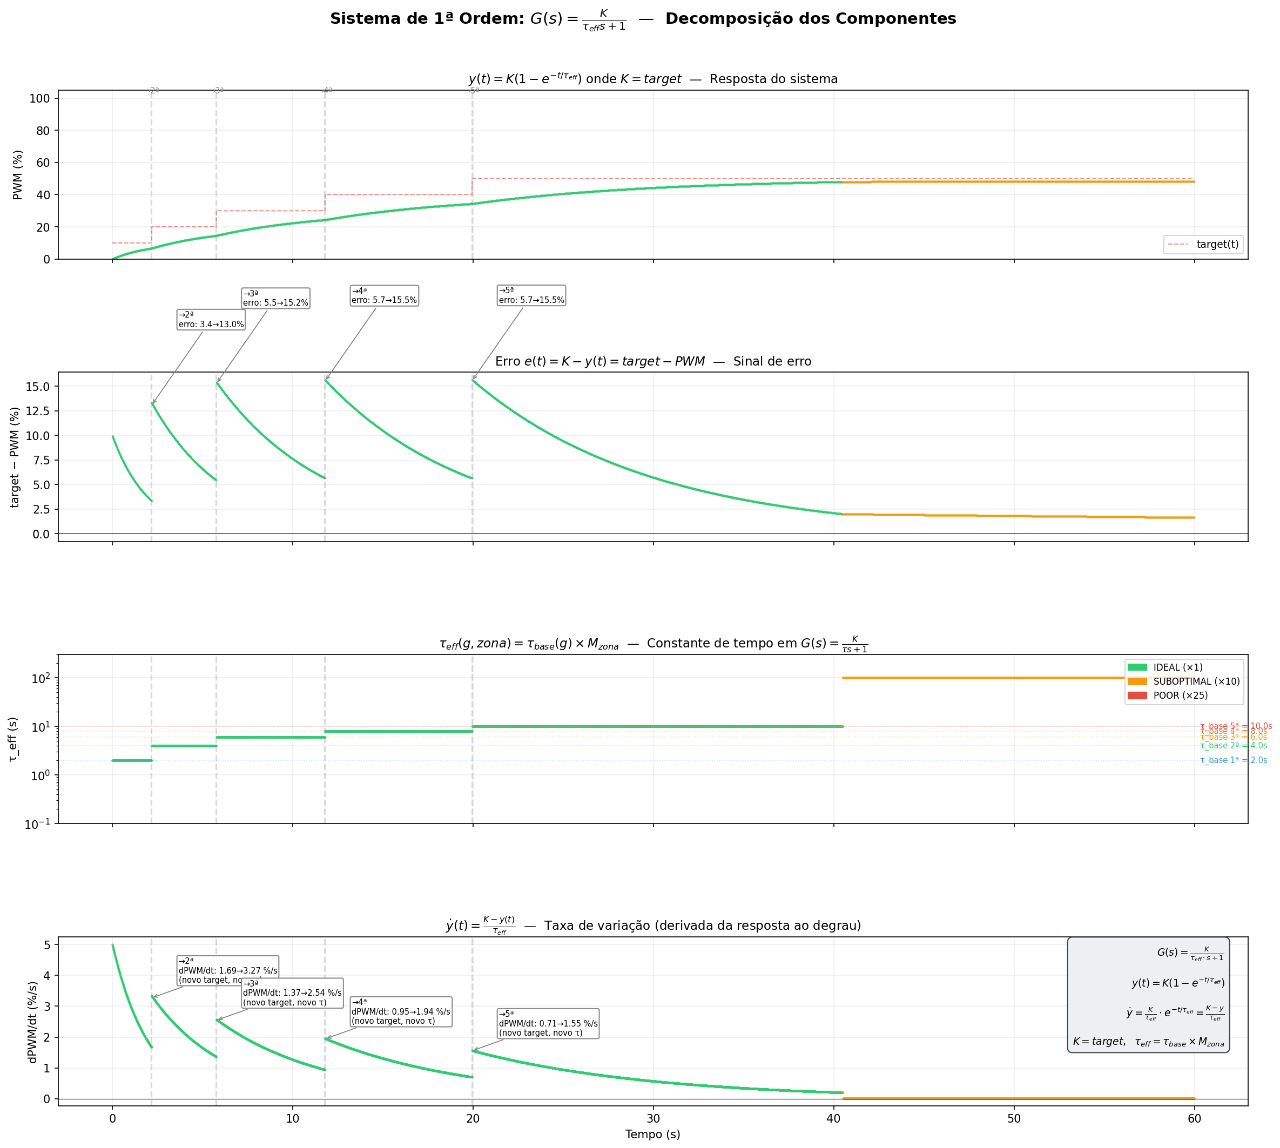
[picture p7: monografia/figuras/ode_equacao_diferencial.png]
		
	}{
		\Fonte{elaborado pelo autor.}
	}
\end{figure}

O \autoref{apendice:exemplo-transmissao} apresenta um exemplo numérico completo com todos os cálculos para a 1ª marcha com acelerador a 60\%, incluindo a integração de Euler iteração por iteração e a comparação entre zonas IDEAL e POOR\@.

Para a desaceleração, o sistema utiliza a mesma formulação de 1ª ordem com $\tau$ reduzido: $\tau_{decel} = \tau_{eff} / 3$, tornando a resposta 3 vezes mais rápida ao soltar o acelerador. Quando o freio é acionado, um fator multiplicativo adicional é aplicado: $\tau_{decel} = \tau_{eff} / (3 \times boost_{freio})$, onde $boost_{freio} = 1 + 9 \times (freio/100)$, resultando em desaceleração até 30 vezes mais rápida com frenagem máxima.

Quando as rodas giram livremente com o motor desligado, o motor atua como gerador e produz uma tensão conhecida como \gls{backemf}. O driver BTS7960 possui proteções integradas contra esse fenômeno: conforme o datasheet do fabricante \citeonline{infineon2013btn7960}, o BTN7960 incorpora \textit{active freewheeling} com frequência PWM de até 25 kHz, sobrecorrente, sobretemperatura e curto-circuito. No eixo de transmissão, um rolamento unidirecional permite que as rodas girem sem transmitir rotação reversa ao motor. Com essas proteções, não foi necessário adicionar diodos flyback ou capacitores de supressão externos.

\subsubsection{Sistema de Direção e Freios}

A direção usa um servo MG996R no canal 0 do PCA9685. O servo gira de 0° a 180° com centro mecânico em 90°, e o software mapeia a entrada do operador ($-100\%$ a $+100\%$) linearmente para essa faixa: $-100\%$ vai para 0° (esquerda máxima), $0\%$ para 90° (centro) e $+100\%$ para 180° (direita máxima). Os pulsos \gls{PWM} vão de 1,0ms a 2,0ms a 50Hz.

O freio usa dois servos MG996R separados: um para o freio dianteiro (canal 3) e outro para o traseiro (canal 7). O balanceamento padrão é 40\% dianteiro e 60\% traseiro (\texttt{brake\_balance = 60}, onde o valor é a porcentagem traseira). O operador pode ajustar esse balanceamento pelo cliente.

\subsection{Arquitetura Multi-Thread}
\label{subsec:multithread-veiculo}

O software embarcado no Raspberry Pi foi refatorado de uma arquitetura sequencial para multi-thread. Na versão sequencial, o loop principal executava captura de frame, leitura de sensores e transmissão em sequência, e o componente mais lento travava todos os outros. Com threads separadas, cada subsistema opera na sua própria taxa de amostragem.

São sete threads no total. Do lado da aquisição, quatro threads coletam dados em paralelo: câmera a 60Hz (frames da OV5647), sensores a 100Hz (BMI160), energia a 10Hz (Arduino Pro Micro via \gls{USB} serial e INA219 via \gls{I2C}) e temperatura a 1Hz (DS18B20 e métricas do sistema operacional). Do lado da transmissão, duas threads enviam dados ao cliente: vídeo a 60Hz pela porta \gls{UDP} 9999 (frame \gls{MJPEG} consolidado com dados de energia e temperatura) e sensores a 100Hz pela porta \gls{UDP} 9997. A sétima thread recebe comandos do cliente pela porta \gls{UDP} 9998.

Na versão sequencial, a leitura de sensores esperava a captura de vídeo terminar (até 16ms a 60Hz). Com a separação em threads, a latência de sensores caiu para aproximadamente 10ms. Para diagnóstico, cada pacote \gls{UDP} inclui campos de tempo (\texttt{timing\_bmi160\_read}, \texttt{timing\_lock}, \texttt{timing\_total\_pre\_send}) que medem cada etapa do pipeline.

As threads se comunicam por filas \gls{threadsafe} (\texttt{Queue}) e locks para proteger variáveis compartilhadas. Cada gerenciador de componente tem seu próprio lock interno. Antes de cada envio, a thread de transmissão coleta os dados mais recentes de todas as threads de aquisição.

Erros são isolados por thread: uma exceção na leitura do BMI160, por exemplo, não derruba a transmissão de vídeo. Cada thread faz logging do erro e continua executando. No shutdown, uma flag de parada é ativada, cada thread tem 2 segundos para finalizar, e os recursos (\gls{GPIO}, \gls{I2C}, sockets) são liberados na ordem inversa de dependência.

\subsection{Gerenciamento do Barramento \gls{I2C}}
\label{subsec:gerenciamento-i2c}

Três dispositivos compartilham o barramento \gls{I2C}-1 do Raspberry Pi 4: o PCA9685, que recebe comandos de direção e freio a até 100Hz; o BMI160, lido a 100Hz pela thread de sensores; e o INA219, lido a 10Hz. Quando duas threads tentam acessar o barramento ao mesmo tempo, o resultado são colisões que geram \texttt{errno 5} (erro de entrada/saída do kernel Linux) e corrompem as leituras do BMI160.

A solução foi um \textit{lock} com prioridades ponderadas (\textit{weighted fair queuing}). Direção e freios têm prioridade alta (peso 3, por serem críticos para segurança), o BMI160 tem prioridade média (peso 2, alimenta telemetria e \textit{force feedback}) e o INA219 tem prioridade baixa (peso 1, monitoramento de energia tolera mais latência). Sob carga máxima, a direção executa 3 transações seguidas e depois cede para o BMI160 fazer 2. Nenhum dispositivo fica bloqueado indefinidamente.

A versão anterior usava prioridade estrita, e o resultado era previsível: durante aceleração contínua, a thread de direção monopolizava o barramento com comandos ao PCA9685, e o BMI160 ficava sem leitura. O \textit{watchdog} interpretava as leituras zeradas como \textit{brown-out} e disparava recuperações desnecessárias. O \textit{fair queuing} ponderado resolveu o problema. Além disso, cada gerenciador faz deduplicação de escritas ao PCA9685: o último ângulo enviado fica em cache, e a escrita \gls{I2C} só acontece quando a diferença é maior que 0,1°. Quando o volante está parado, isso elimina transações desnecessárias.

O barramento opera a 400kHz (\textit{Fast mode}) em vez dos 100kHz padrão, o que reduz o tempo de cada transação por 4. BMI160, PCA9685 e INA219 suportam essa velocidade. A utilização medida é de 27,5 kbps dos 400 kbps disponíveis (6,9\%), então largura de banda não é o problema. O problema é temporal: duas threads querendo o barramento no mesmo instante.

% ============================================================================
% ARQUITETURA DO SIMULADOR (LOGITECH G923)
% ============================================================================
\section{Arquitetura do Simulador (Logitech G923)}
\label{sec:arquitetura-simulador}

O simulador utiliza o volante Logitech G923 (\autoref{fig:g923-volante}), que combina volante de 900°, pedais de acelerador e freio, paddle shifters e motor de force feedback em um único periférico USB. O G923 foi escolhido por ter sensores internos de maior precisão, \textit{force feedback} nativo sem necessidade de ponte H externa, e por não exigir \textit{firmware} customizado nem calibração manual. O Linux reconhece o G923 como dispositivo de entrada padrão, acessível pela interface evdev do kernel.

\begin{figure}[!ht]
	\captionsetup{width=16cm}
	\Caption{\label{fig:g923-volante} Volante de corrida Logitech G923 TRUEFORCE com pedais progressivos}
	\UFCfig{}{
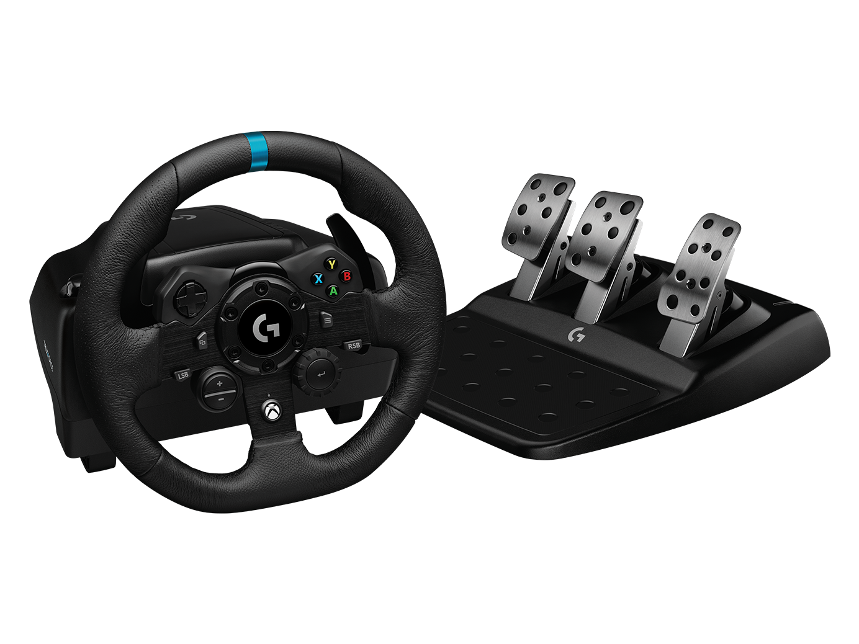
[picture p8: monografia/figuras/g923.png]
		
	}{
		\Fonte{\citeonline{logitech2024g923}.}
	}
\end{figure}

O software de interface foi desenvolvido em Python com a biblioteca evdev, que fornece acesso direto aos eventos de entrada do kernel Linux (leitura de eixos, botões e upload de efeitos de force feedback) sem necessidade de drivers proprietários.

\subsection{Especificações do Simulador}
\label{subsec:componentes-simulador}

A \autoref{tab:componentes-simulador} apresenta as especificações do simulador Logitech G923 e seus periféricos.

\begin{table}[!h]
\captionsetup{width=16cm}
\Caption{\label{tab:componentes-simulador} Especificações do simulador Logitech G923}
\IBGEtab{}{%
	\begin{tabular}{p{3.5cm}p{6cm}p{6cm}}
		\toprule
		Componente & Especificação & Função no Sistema \\
		\midrule \midrule
		Logitech G923 & Volante 900°, TRUEFORCE, USB \gls{HID}, pedais progressivos & Captura de comandos do operador e geração de force feedback \\
		\midrule
		Volante & Rotação 900° (lock-to-lock), sensor Hall de posição & Controle de direção com resolução de 16 bits \\
		\midrule
		Pedal Acelerador & Sensor potenciométrico progressivo, 0--255 & Controle de aceleração do veículo \\
		\midrule
		Pedal Freio & Sensor potenciométrico progressivo, 0--255 & Controle de frenagem do veículo \\
		\midrule
		Paddle Shifters & 2 alavancas metálicas atrás do volante & Troca de marchas (subir/descer) \\
		\midrule
		Motor Force Feedback & Motor DC integrado com sistema TRUEFORCE & Geração de force feedback via efeitos \texttt{FF\_CONSTANT} \\
		\bottomrule
	\end{tabular}%
}{%
\Fonte{elaborado pelo autor.}%
}
\end{table}

\subsection{Leitura de Eixos e Botões via evdev}
\label{subsec:leitura-g923}

A leitura dos dados do G923 é realizada através da interface evdev do kernel Linux. O dispositivo é detectado automaticamente pela busca em \texttt{/dev/input/event*} por dispositivos cujo nome contém ``G923'' e que possuem as capabilities \texttt{EV\_ABS} (eixos analógicos) e \texttt{EV\_FF} (force feedback). A \autoref{tab:mapeamento-eixos-g923} apresenta o mapeamento dos eixos do G923 para os comandos de controle do veículo.

\begin{table}[!h]
\captionsetup{width=16cm}
\Caption{\label{tab:mapeamento-eixos-g923} Mapeamento de eixos e botões do G923 para comandos de controle}
\IBGEtab{}{%
	\begin{tabular}{p{3.5cm}p{3cm}p{3.5cm}p{5cm}}
		\toprule
		Evento evdev & Faixa Bruta & Comando & Normalização \\
		\midrule \midrule
		\texttt{ABS\_X} & 0 a 65535 & STEERING & $-100\%$ a $+100\%$ (linear) \\
		\midrule
		\texttt{ABS\_Y} & 0 a 255 & THROTTLE & $0\%$ a $100\%$ (invertido) \\
		\midrule
		\texttt{ABS\_Z} & 0 a 255 & BRAKE & $0\%$ a $100\%$ (invertido) \\
		\midrule
		\texttt{BTN\_TOP2} (292) & 0 ou 1 & GEAR\_UP & Paddle direito, evento na transição 0$\rightarrow$1 \\
		\midrule
		\texttt{BTN\_PINKIE} (293) & 0 ou 1 & GEAR\_DOWN & Paddle esquerdo, evento na transição 0$\rightarrow$1 \\
		\bottomrule
	\end{tabular}%
}{%
\Fonte{elaborado pelo autor.}%
}
\end{table}

Os valores dos eixos são normalizados para a faixa padrão do sistema: $-100\%$ a $+100\%$ para direção e $0\%$ a $100\%$ para acelerador e freio. Os pedais utilizam normalização invertida porque o valor bruto 0 corresponde ao pedal totalmente pressionado no G923. A leitura opera em thread dedicada com loop assíncrono, processando eventos do kernel em tempo real e invocando callbacks para atualização dos controles do veículo.

\subsection{Sistema de Force Feedback via evdev}
\label{subsec:ff-simulador}

O sistema de \textit{force feedback} explora a capacidade do G923 de executar 15 tipos de efeitos com até 63 \textit{slots} simultâneos, utilizando 8 efeitos ativos simultaneamente organizados em três categorias. A \autoref{tab:efeitos-ff-g923} apresenta os efeitos utilizados e suas fontes de dados.

\begin{table}[!h]
\captionsetup{width=16cm}
\Caption{\label{tab:efeitos-ff-g923} Efeitos de force feedback simultâneos no G923}
\IBGEtab{}{%
	\begin{tabular}{p{2.5cm}p{2.5cm}p{3cm}p{6.5cm}}
		\toprule
		Efeito & Categoria & Controle & Função \\
		\midrule \midrule
		FF\_SPRING & Condicional & Slider sensibilidade & Centralização proporcional à posição do volante (mín. 5\%) \\
		\midrule
		FF\_DAMPER & Condicional & Slider \textit{damping} & Resistência proporcional à velocidade angular do volante \\
		\midrule
		FF\_FRICTION & Condicional & Slider fricção & Resistência constante ao movimento, simulando grip do pneu (mín. 3\%) \\
		\midrule
		FF\_INERTIA & Condicional & Automático & Peso do volante proporcional à velocidade do veículo (5\% a 80\%) \\
		\midrule
		FF\_CONSTANT & Força & Dados BMI160 & Puxão lateral em curvas (G lateral + \textit{yaw}) \\
		\midrule
		FF\_CONSTANT & Força & Posição volante & Batente virtual nos limites calibrados (\textit{endstop}) \\
		\midrule
		FF\_RUMBLE & Vibração & Dados BMI160 & Vibração de impactos e textura da pista (motor forte + fraco) \\
		\midrule
		FF\_PERIODIC & Vibração & Acelerador & Vibração senoidal simulando RPM do motor (5 a 12,5Hz) \\
		\bottomrule
	\end{tabular}%
}{%
\Fonte{elaborado pelo autor.}%
}
\end{table}

Os efeitos condicionais (FF\_SPRING, FF\_DAMPER, FF\_FRICTION, FF\_INERTIA) são executados pelo \textit{firmware} do volante a aproximadamente 1kHz, o que resulta em resposta mais suave do que o cálculo equivalente em \textit{software} a 60Hz. Os efeitos de força e vibração são atualizados pelo \textit{software} a cada pacote recebido do BMI160. O ganho global (\texttt{FF\_GAIN}) limita todos os 8 efeitos simultaneamente, com valor padrão de 15\%. Nos testes, valores acima de 25\% travavam o mecanismo do volante, e 15\% foi o ponto em que a força era perceptível sem comprometer o dispositivo.

A \autoref{fig:ff-pipeline} apresenta o pipeline completo do sistema de force feedback, desde a aquisição dos dados do BMI160 no veículo até a aplicação dos efeitos nos motores do volante G923 via \textit{evdev ioctl}. O pipeline opera em duas camadas: efeitos condicionais processados pelo kernel a aproximadamente 1~kHz e controlados pelos sliders da interface, e efeitos de força e vibração calculados pelo software a 60~Hz com base nos dados sensoriais.

\begin{figure}[!ht]
	\captionsetup{width=16cm}
	\Caption{\label{fig:ff-pipeline} Pipeline de force feedback --- fluxo dos dados do BMI160 até os efeitos no volante G923}
	\UFCfig{}{
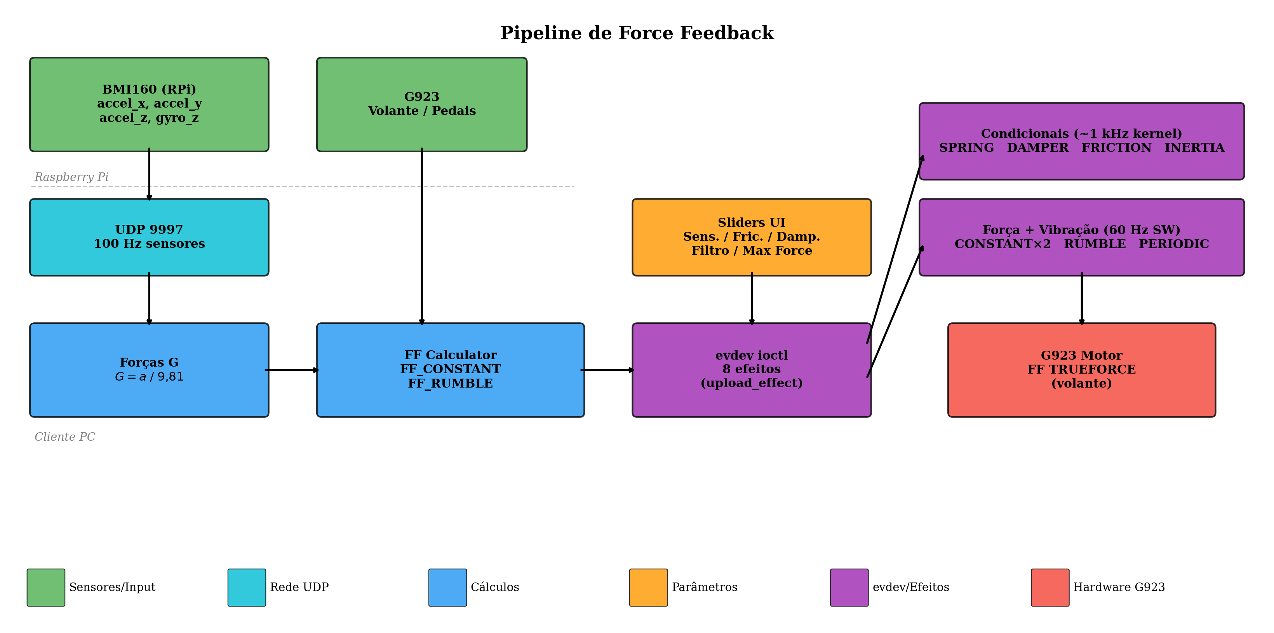
[picture p9: monografia/figuras/ff_charts/ff_pipeline.png]
		
	}{
		\Fonte{elaborado pelo autor.}
	}
\end{figure}

Para minimizar a latência do \textit{force feedback}, cada efeito mantém um \textit{cache} do último valor enviado ao dispositivo e só realiza a chamada de sistema (\texttt{ioctl}) quando o valor efetivamente muda. Os valores de saída dos filtros \gls{EMA} são arredondados para inteiro antes da comparação com o \textit{cache}, evitando atualizações por variações decimais insignificantes. Os efeitos também são atualizados \textit{in-place} com uma única chamada \texttt{upload\_effect}, ao invés de recriados a cada atualização (que exigiria 4 chamadas: parar, apagar, criar e iniciar). Com essas otimizações, o bloqueio da \textit{thread} de sensores caiu de 12--60ms por pacote para 0--15ms.

\subsection{Calibração de Eixos}
\label{subsec:calibracao-simulador}

Embora o G923 possua calibração de fábrica, o software do cliente implementa uma calibração adicional para ajustar os limites de cada eixo. O processo de calibração registra os valores mínimo e máximo observados durante movimentação completa de cada controle, armazenando os resultados em arquivo \gls{JSON} persistente (\texttt{g923\_calibration.json}). Os valores calibrados são aplicados automaticamente na inicialização seguinte, ajustando as faixas de normalização para compensar eventuais variações do dispositivo.

% ============================================================================
% ARQUITETURA DO CLIENTE (PC)
% ============================================================================
\section{Arquitetura do Cliente (PC)}
\label{sec:arquitetura-cliente}

O cliente PC recebe dados do veículo via \gls{UDP}, processa telemetria, calcula force feedback e transmite comandos ao veículo e ao simulador. O software foi desenvolvido em Python 3.11.2 com interface gráfica Tkinter. As especificações do computador utilizado estão no \autoref{apendice:specs-equipamentos}. A \autoref{tab:bibliotecas-cliente} apresenta as bibliotecas utilizadas.

\begin{table}[!h]
\captionsetup{width=16cm}
\Caption{\label{tab:bibliotecas-cliente} Bibliotecas Python utilizadas no cliente PC}
\IBGEtab{}{
\begin{tabular}{p{3.5cm}p{11cm}}
\toprule
\textbf{Biblioteca} & \textbf{Função} \\
\midrule
tkinter & Interface gráfica nativa com suporte a widgets e canvas para vídeo \\
opencv-python & Decodificação de frames \gls{MJPEG} e aplicação de filtros de imagem \\
numpy & Processamento numérico de dados de telemetria e operações matriciais \\
cupy & Aceleração GPU para filtros PDI via \gls{CUDA} (opcional) \\
Pillow & Conversão de imagens OpenCV para formato compatível com Tkinter \\
evdev & Interface com o simulador Logitech G923 via dispositivos de entrada Linux \\
socket & Comunicação \gls{UDP} com Raspberry Pi para recepção de telemetria e vídeo \\
matplotlib & Renderização de gráficos de telemetria em tempo real \\
\bottomrule
\end{tabular}
}{
\Fonte{elaborado pelo autor.}
}
\end{table}

\subsection{Interface Gráfica}
\label{subsec:interface-cliente}

A interface gráfica utiliza Tkinter com tema escuro e scroll vertical por canvas, conforme ilustrado na \autoref{fig:interface-geral}. O layout é dividido em três áreas: vídeo e filtros no topo (largura total), dados de telemetria na coluna esquerda e controles na coluna direita.

\begin{figure}[!ht]
	\captionsetup{width=16cm}
	\Caption{\label{fig:interface-geral} Interface gráfica do console de controle}
	\UFCfig{}{
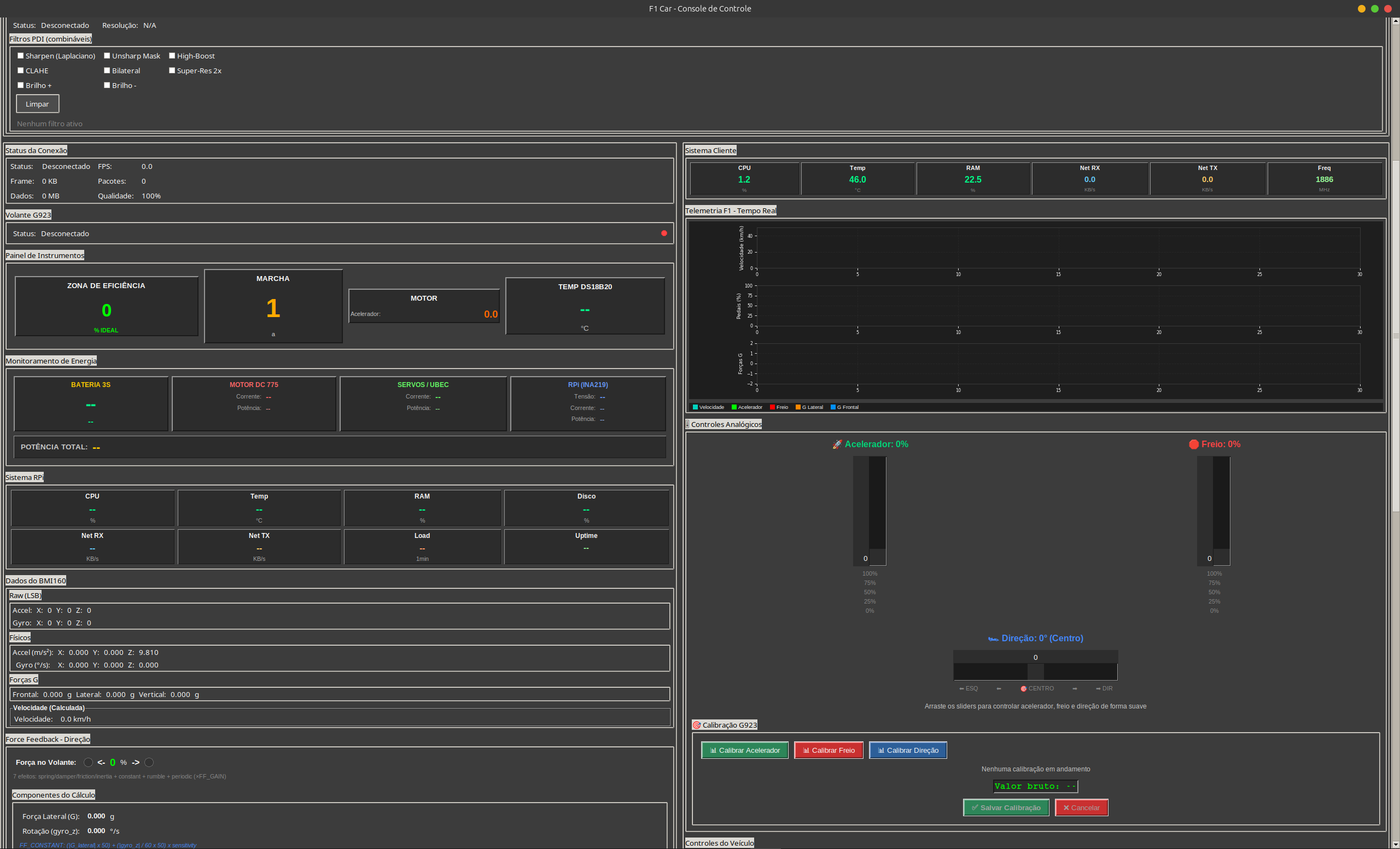
[picture p10: monografia/figuras/interface-geral.png]
		
	}{
		\Fonte{elaborado pelo autor.}
	}
\end{figure}

O topo exibe o vídeo da câmera em tempo real com controles de filtros de imagem. A decodificação \gls{MJPEG} é feita por OpenCV e a renderização no canvas Tkinter por Pillow.

A coluna esquerda empilha verticalmente: status da conexão \gls{UDP} (FPS, tamanho de frame, pacotes), status do G923, painel de instrumentos (zona de eficiência, marcha e velocidade), monitoramento de energia (tensão da bateria, corrente e potência do motor, servos e Raspberry Pi), métricas de sistema do cliente PC e do Raspberry Pi (CPU, temperatura, memória, disco e rede), dados brutos e físicos do BMI160, componentes do force feedback e console de log.

A coluna direita contém os gráficos de telemetria F1 em tempo real, sliders de controle do veículo (acelerador, freio e direção), ajuste de balanceamento de freio e indicadores de controle por teclado. Os gráficos são renderizados pela biblioteca Matplotlib integrada ao Tkinter, em três subplots: velocidade, pedais (acelerador e freio sobrepostos) e forças G (lateral e frontal). Os dados recebidos do veículo são acumulados em buffers circulares de até 500 pontos, e os gráficos exibem uma janela deslizante dos últimos 30 segundos.

\subsection{Filtros de Processamento Digital de Imagens}
\label{subsec:filtros-pdi}

O cliente implementa filtros de \gls{PDI} combináveis. Em operação de campo, o vídeo transmitido sofre com mudanças de iluminação (sombras, reflexos solares, transições claro-escuro), baixo contraste em superfícies uniformes e artefatos da compressão \gls{MJPEG}, o que prejudica a percepção do operador. O \gls{CLAHE} corrige iluminação desigual, enquanto Sharpen e Unsharp Mask recuperam nitidez perdida na compressão JPEG. O operador pode ativar múltiplos filtros simultaneamente via checkboxes na interface, adaptando o processamento às condições do momento. Cada filtro adiciona latência ao pipeline de vídeo, e ao ativar combinações mais pesadas é possível observar a queda de FPS diretamente na interface, o que também permite identificar até onde o processamento pode ir sem prejudicar a teleoperação.

A \autoref{tab:filtros-pdi} apresenta os filtros disponíveis no sistema, baseados em técnicas clássicas de processamento de imagens conforme \citeonline{gonzalez2010processamento}.

\begin{table}[!h]
\captionsetup{width=16cm}
\Caption{\label{tab:filtros-pdi} Filtros de processamento digital de imagens disponíveis no cliente}
\IBGEtab{}{
\begin{tabular}{p{2.5cm}p{3.5cm}p{6.5cm}c}
\toprule
\textbf{Filtro} & \textbf{Técnica} & \textbf{Descrição} & \textbf{GPU} \\
\midrule
Sharpen & Máscara \gls{laplaciano} 3×3 & Aguça bordas usando operador de segunda derivada & Sim \\
Unsharp Mask & Subtração gaussiana & Realça detalhes subtraindo versão borrada da imagem & Sim \\
High-Boost & Laplaciano ponderado & Aguçamento com preservação de baixas frequências & Sim \\
CLAHE & Equalização adaptativa & Melhora contraste local com limite de amplificação & Não \\
Bilateral & Filtragem bilateral & Suaviza ruído preservando bordas & Não \\
Super-Res 2x & Supersampling & Anti-aliasing via upscale/downscale Lanczos & Sim \\
Brilho +/- & Ajuste HSV & Modifica canal V para ambientes claros/escuros & Sim \\
\bottomrule
\end{tabular}
}{
\Fonte{elaborado pelo autor.}
}
\end{table}

O sistema suporta aceleração por \gls{GPU} NVIDIA via biblioteca CuPy quando disponível, executando operações de \gls{convolucao} e transformações diretamente na placa de vídeo. Os filtros \gls{CLAHE} e Bilateral executam exclusivamente em \gls{CPU} devido à complexidade algorítmica que dificulta paralelização eficiente. O fallback automático para CPU garante funcionamento em sistemas sem GPU dedicada.

\subsection{Arquitetura Multi-Thread e Recepção de Dados}
\label{subsec:recepcao-cliente}

Sem separação em threads, a operação mais lenta (decodificação de vídeo, leitura de rede ou cálculo de force feedback) bloquearia todas as outras, congelando a interface durante o processamento. Por isso o cliente separa operações de I/O (rede e evdev) da interface gráfica através de threads especializadas. A thread principal executa exclusivamente o loop de eventos do Tkinter, e qualquer trabalho pesado ocorre em threads secundárias. A thread de rede recebe pacotes \gls{UDP} do veículo na porta 9999 (frames \gls{MJPEG} a 60Hz). A thread de sensores recebe dados do BMI160 na porta \gls{UDP} 9997 a 100Hz. A thread do G923 lê eixos e botões do volante via evdev. Uma thread de envio transmite comandos ao veículo a 100Hz.

A comunicação entre threads usa filas \gls{threadsafe} (\texttt{queue.Queue}) separadas para logs, status, sensores e vídeo. A thread principal consome essas filas via callbacks do Tkinter (\texttt{root.after()}), que é o mecanismo exigido pelo toolkit para atualizações de interface. Pacotes são filtrados por \gls{IP} para ignorar tráfego não relacionado ao veículo.

\subsection{Algoritmos de Cálculo de Force Feedback}
\label{subsec:algoritmos-ff-cliente}

Os algoritmos de force feedback são executados no cliente, utilizando dados do sensor BMI160 recebidos do veículo para calcular intensidade e direção da força a ser aplicada no volante.

A arquitetura do pipeline foi apresentada na \autoref{fig:ff-pipeline}. As subseções a seguir detalham os algoritmos de cada efeito.

\subsubsection{Cálculo das Forças G}

O algoritmo para cálculo das forças G considera os valores de aceleração linear e velocidade angular obtidos do sensor BMI160:

\begin{equation}
\label{eq:forca-g-frontal-cliente}
G_{frontal} = \frac{acelera\text{ç}\tilde{a}o_{linear\_X}}{9.81}
\end{equation}

\begin{equation}
\label{eq:forca-g-lateral-cliente}
G_{lateral} = \frac{acelera\text{ç}\tilde{a}o_{linear\_Y}}{9.81}
\end{equation}

\subsubsection{Algoritmos de Controle de Force Feedback}
\label{subsubsec:algoritmos-force-feedback}

O \autoref{alg:calcular-forcas-g} apresenta o cálculo de forças G a partir dos dados do BMI160. A \autoref{fig:ff-forcas-g} ilustra a relação entre aceleração e força G calculada.

\begin{figure}[h!]
	\centering
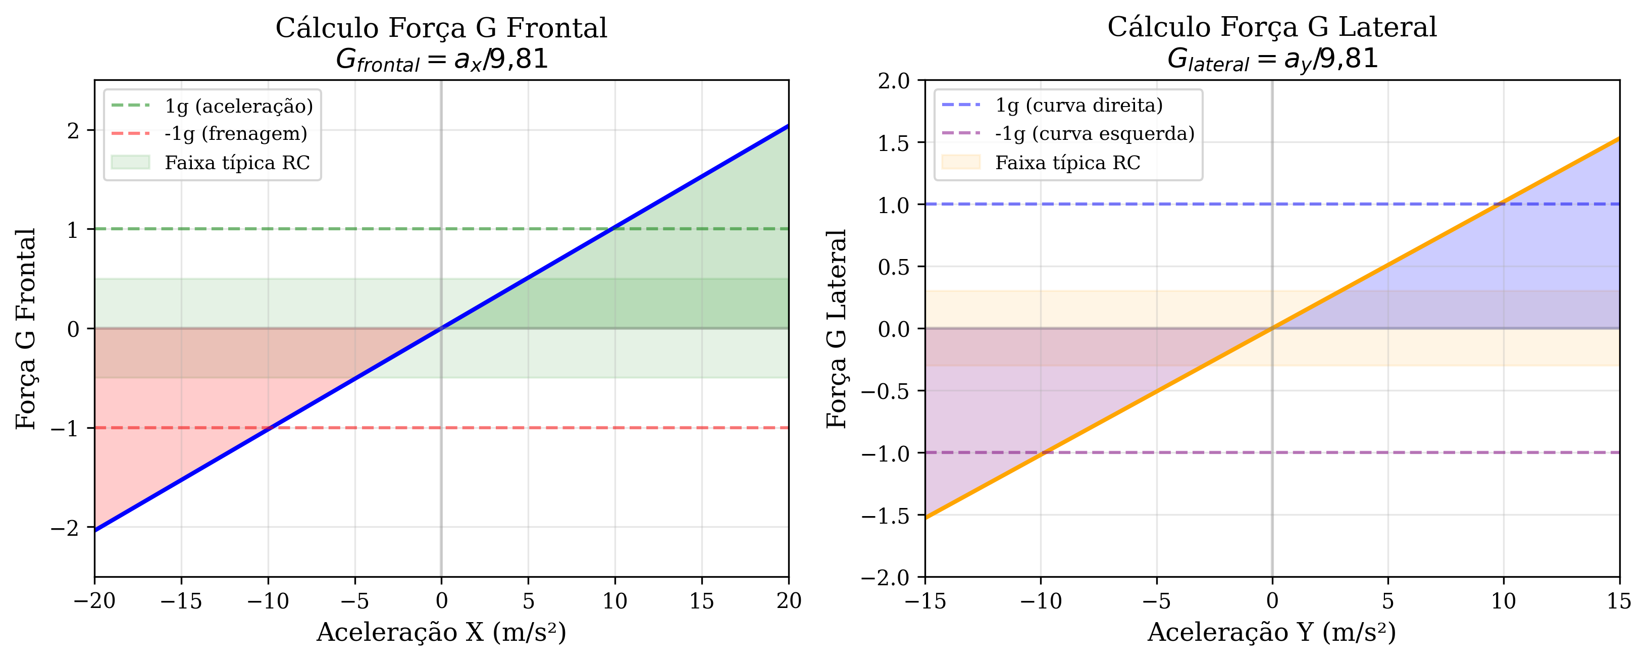
[picture p11: monografia/figuras/ff_charts/ff_forcas_g.png]
	
	\Caption{\label{fig:ff-forcas-g} Cálculo das forças G frontal e lateral a partir dos dados do acelerômetro}
\end{figure}

\begin{algorithm}[h!]
	\SetSpacedAlgorithm
	\caption{\label{alg:calcular-forcas-g}Cálculo das forças G}
	\Entrada{accel\_x, accel\_y, accel\_z (valores do BMI160 em m/s²)}
	\Saida{g\_frontal, g\_lateral, g\_vertical}
	\Inicio{
		g\_frontal $\leftarrow$ accel\_x / 9.81\;
		g\_lateral $\leftarrow$ accel\_y / 9.81\;
		g\_vertical $\leftarrow$ (accel\_z - 9.81) / 9.81\;
	}
\end{algorithm}

\subsubsection{Componentes do Efeito FF\_CONSTANT}

O efeito \texttt{FF\_CONSTANT} aplica um puxão direcional no volante proporcional às forças laterais experimentadas pelo veículo. Sua intensidade é calculada a partir de dois componentes, conforme ilustrado na \autoref{fig:ff-componentes}: força G lateral (curvas) e rotação yaw (giroscópio). A centralização do volante é tratada separadamente pelo efeito condicional \texttt{FF\_SPRING}, executado pelo \textit{firmware} do G923 a aproximadamente 1kHz. A força base do \texttt{FF\_CONSTANT} é a soma dos dois componentes, limitada a 100\%.

\begin{figure}[h!]
	\centering
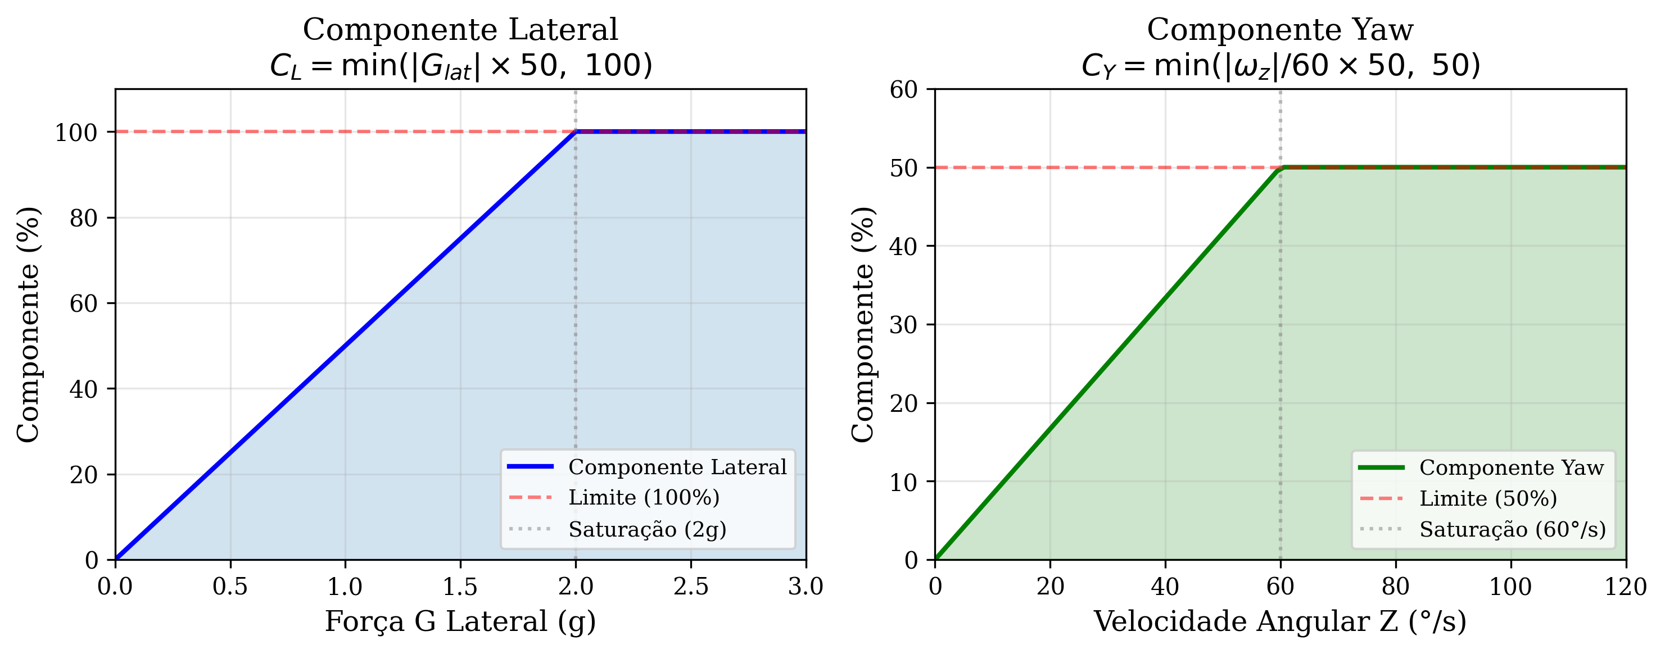
[picture p12: monografia/figuras/ff_charts/ff_componentes.png]
	
	\Caption{\label{fig:ff-componentes} Componentes do efeito FF\_CONSTANT: lateral e yaw}
\end{figure}

O componente lateral é proporcional à força G lateral, saturando em 100\% quando a aceleração lateral atinge 2g. O componente yaw captura a rotação do veículo em torno do eixo vertical, saturando em 50\% a 60°/s. Após a soma dos componentes, a sensibilidade (padrão 75\%) é aplicada como multiplicador, e um filtro EMA suaviza variações bruscas. A \autoref{fig:ff-cenarios} apresenta a contribuição de cada componente em cenários típicos de condução.

\begin{figure}[h!]
	\centering
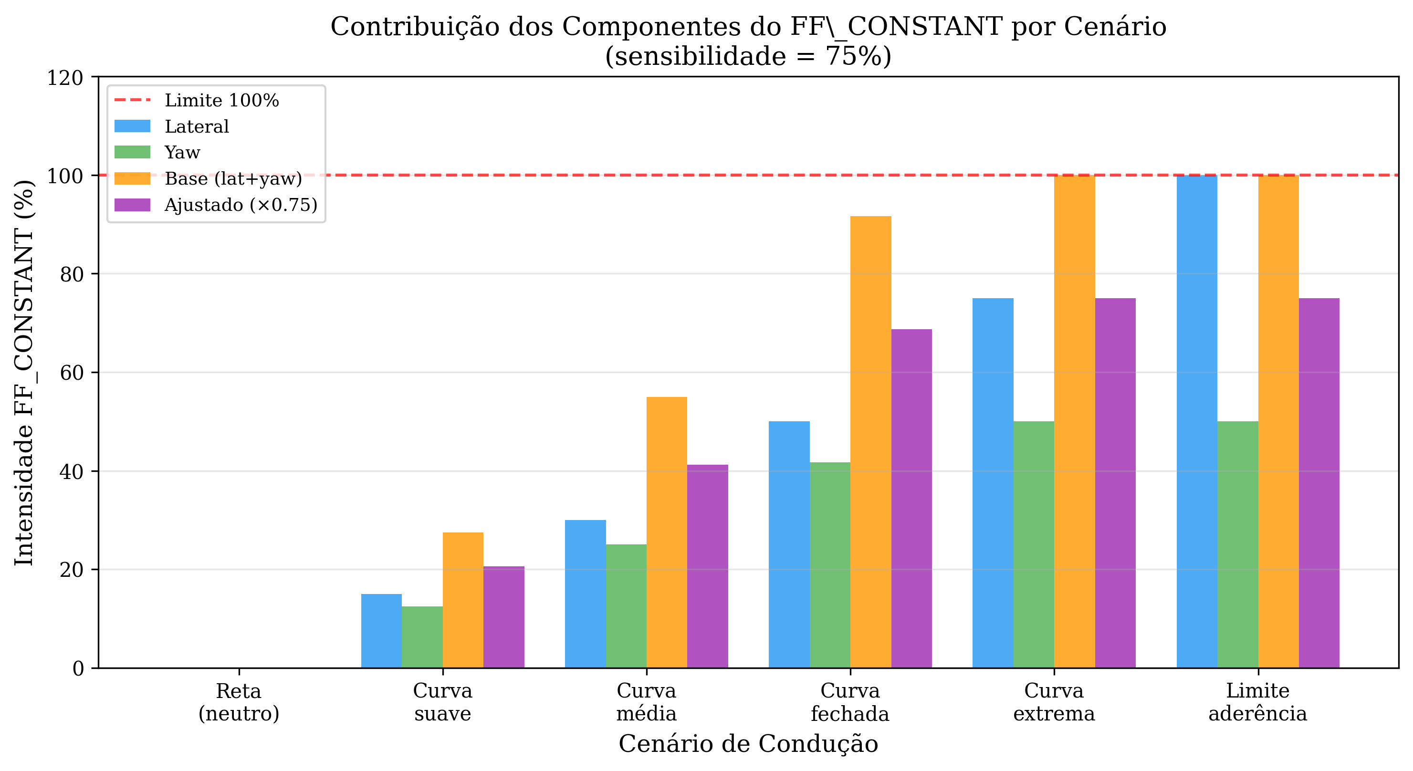
[picture p13: monografia/figuras/ff_charts/ff_cenarios.png]
	
	\Caption{\label{fig:ff-cenarios} Contribuição dos componentes do FF\_CONSTANT por cenário de condução}
\end{figure}

O \autoref{alg:ff-direcao} apresenta o algoritmo executado no cliente PC para cada pacote recebido do BMI160, enviando o resultado ao motor integrado do G923 via efeito \texttt{FF\_CONSTANT} do evdev:

\begin{algorithm}[h!]
	\SetSpacedAlgorithm
	\caption{\label{alg:ff-direcao}Cálculo do efeito FF\_CONSTANT}
	\Entrada{g\_lateral, gyro\_z, sensibilidade, filtro}
	\Saida{intensidade\_ff, direcao\_ff}
	\Inicio{
		// Componente 1: Força lateral (curvas) - máximo 100\%\;
		componente\_lateral $\leftarrow$ minimo(abs(g\_lateral) $\times$ 50, 100)\;
		// Componente 2: Rotação yaw - máximo 50\%\;
		componente\_yaw $\leftarrow$ minimo(abs(gyro\_z) / 60.0 $\times$ 50, 50)\;
		// Força base combinada (0-100\%)\;
		ff\_base $\leftarrow$ minimo(componente\_lateral + componente\_yaw, 100)\;
		// Aplica sensibilidade (padrão 75\%)\;
		ff\_ajustado $\leftarrow$ ff\_base $\times$ sensibilidade\;
		// Aplica filtro EMA (suavização exponencial, padrão 40\%)\;
		ff\_ajustado $\leftarrow$ ff\_ajustado $\times$ (1.0 - filtro) + ff\_filtrado\_anterior $\times$ filtro\;
		intensidade\_ff $\leftarrow$ limitar(ff\_ajustado, 0, 100)\;
		// Determina direção do puxão lateral\;
		valor\_direcao $\leftarrow$ (g\_lateral $\times$ 10) + gyro\_z\;
		\Se{valor\_direcao > 1.5}{direcao\_ff $\leftarrow$ "DIREITA"\;}
		\SenaoSe{valor\_direcao < -1.5}{direcao\_ff $\leftarrow$ "ESQUERDA"\;}
		\Senao{direcao\_ff $\leftarrow$ "NEUTRO"\;}
		// Rejeição de ruído: intensidade < 2\% força neutro\;
		\Se{intensidade\_ff < 2.0}{direcao\_ff $\leftarrow$ "NEUTRO"\;}
	}
\end{algorithm}

\subsubsection{Direção e Mapeamento do Force Feedback}

A direção do \texttt{FF\_CONSTANT} é calculada combinando dois componentes direcionais: força G lateral (multiplicada por 10 para ajustar a escala) e velocidade angular yaw. O valor resultante determina se a força será aplicada para esquerda (\texttt{0x4000}), direita (\texttt{0xC000}) ou neutro, com limiar de $\pm$1,5 e rejeição de ruído abaixo de 2\% de intensidade, conforme ilustrado na \autoref{fig:ff-direcao}.

\begin{figure}[h!]
	\centering
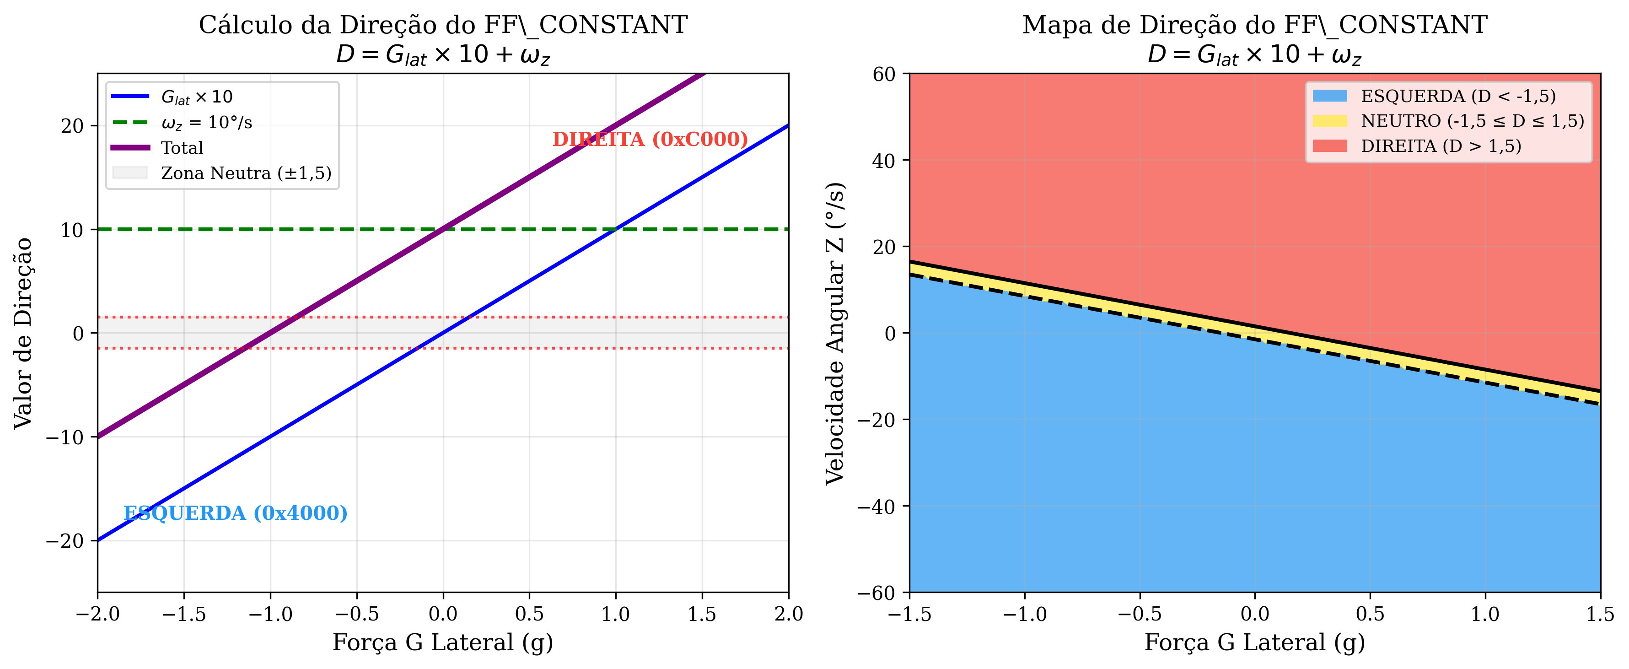
[picture p14: monografia/figuras/ff_charts/ff_direcao.png]
	
	\Caption{\label{fig:ff-direcao} Cálculo da direção do FF\_CONSTANT e mapa de zonas}
\end{figure}

O comando de intensidade calculado (0--100\%) é convertido para a faixa de 16 bits do evdev (0 a 32.767) conforme a \autoref{eq:ff-level}, e aplicado diretamente ao motor integrado do G923.

\begin{equation}
\label{eq:ff-level}
level = \frac{intensidade \times 32767}{100}
\end{equation}

\subsubsection{Efeitos Condicionais e Parâmetros Ajustáveis}

Os quatro efeitos condicionais são executados pelo \textit{firmware} do G923 a aproximadamente 1kHz, e controlados por \textit{sliders} na interface do operador. Cada \textit{slider} é convertido para um coeficiente de 16 bits ($0$ a $32.767$) via $coeff = slider \times 32767 / 100$. A \autoref{fig:ff-parametros} ilustra o mapeamento de cada parâmetro para o coeficiente correspondente.

Os valores padrão de cada \textit{slider} foram ajustados durante a prototipagem, testando diferentes combinações em condução real até que a resposta tátil correspondesse às manobras do veículo. A sensibilidade (padrão 75\%) controla o coeficiente do efeito \texttt{FF\_SPRING}, que centraliza o volante proporcionalmente à sua posição, com mínimo de 5\% para manter a sensação de coluna de direção. A fricção (padrão 30\%) ajusta o \texttt{FF\_FRICTION}, que aplica resistência constante ao movimento simulando o \textit{grip} do pneu, com mínimo de 3\%. O \textit{damping} (padrão 50\%) configura o \texttt{FF\_DAMPER}, que aplica resistência proporcional à velocidade angular do volante. A força máxima (padrão 15\%) controla o \texttt{FF\_GAIN} global do evdev, que escala todos os 8 efeitos simultaneamente. O filtro (padrão 40\%) é aplicado exclusivamente ao \texttt{FF\_CONSTANT} em \textit{software}: valores mais baixos tornam o \textit{feedback} mais responsivo porém ruidoso, e 40\% foi o ponto em que a suavização eliminou oscilações perceptíveis sem introduzir atraso notável, conforme ilustrado na \autoref{fig:ff-filtro-ema}.

\begin{figure}[h!]
	\centering
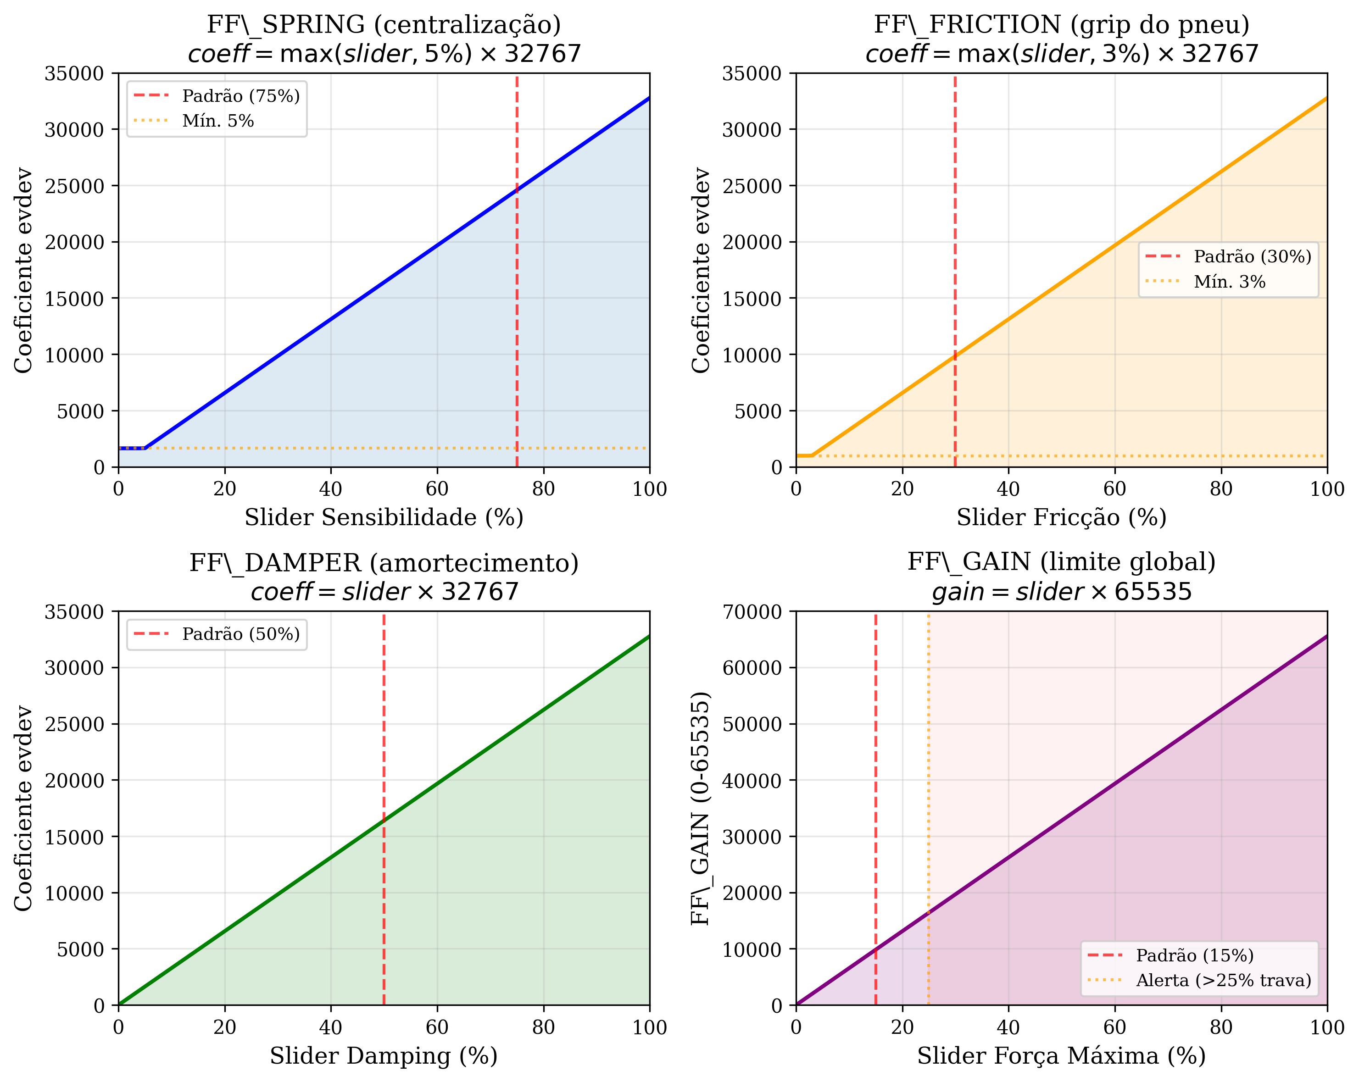
[picture p15: monografia/figuras/ff_charts/ff_parametros.png]
	
	\Caption{\label{fig:ff-parametros} Mapeamento dos \textit{sliders} para coeficientes evdev dos efeitos condicionais e ganho global}
\end{figure}

\begin{figure}[h!]
	\centering
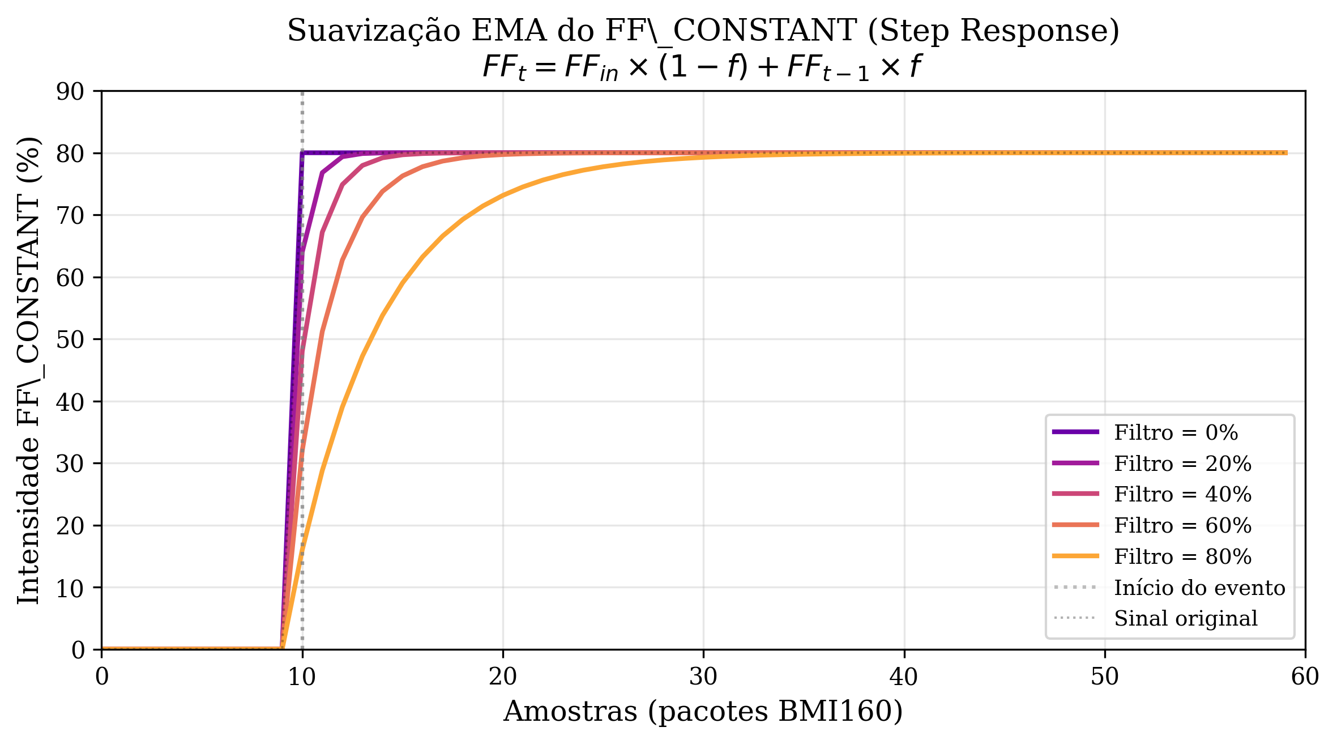
[picture p16: monografia/figuras/ff_charts/ff_filtro_ema.png]
	
	\Caption{\label{fig:ff-filtro-ema} Resposta ao degrau do filtro EMA aplicado ao FF\_CONSTANT}
\end{figure}

\subsubsection{Efeitos Dinâmicos de Vibração}

Antes de calcular os efeitos dinâmicos, o sistema mantém um buffer circular de 20 amostras ($\approx$333ms a 60Hz) com os valores de aceleração, giroscópio e controles do operador. Esse buffer alimenta dois cálculos auxiliares usados pelo \texttt{FF\_RUMBLE}:

O \textit{jerk} é a derivada temporal de um sensor, calculada como a diferença entre a amostra mais recente e a mais antiga dividida pelo intervalo de tempo:

\begin{equation}
\label{eq:jerk}
jerk = \frac{amostra_{atual} - amostra_{n-5}}{t_{atual} - t_{n-5}}
\end{equation}

\noindent O jerk é calculado para cinco sinais: aceleração frontal (partida/frenagem brusca), aceleração vertical (\textit{bumps}), acelerador, freio e direção. Valores altos indicam eventos bruscos.

A rugosidade da pista é estimada pelo desvio padrão das últimas 10 amostras do acelerômetro vertical ($a_z$):

\begin{equation}
\label{eq:rugosidade}
\sigma_{pista} = \sqrt{\frac{1}{N}\sum_{i=1}^{N}(a_{z_i} - \bar{a}_z)^2}
\end{equation}

\noindent Pista lisa produz $\sigma \approx 0{,}1$~m/s², pista irregular produz $\sigma > 1{,}0$~m/s².

O sistema também detecta o contexto de condução para condicionar os efeitos: o veículo é considerado ativo quando há acelerador acima de 2\%, freio acima de 2\%, força G lateral acima de 0,12g, força G frontal acima de 0,12g ou velocidade angular acima de 2,5°/s. Quando nenhuma dessas condições é atendida, os efeitos dinâmicos decaem rapidamente para evitar \textit{feedback} residual.

O efeito \texttt{FF\_RUMBLE} distribui oito componentes sensoriais entre os dois motores de vibração do G923, conforme ilustrado na \autoref{fig:ff-rumble}. O motor forte (\textit{strong}) reproduz impactos bruscos e o motor fraco (\textit{weak}) reproduz textura contínua. A \autoref{tab:rumble-componentes} detalha cada componente com seu cálculo e peso na soma ponderada de cada motor.

\begin{table}[!h]
\captionsetup{width=16cm}
\Caption{\label{tab:rumble-componentes} Componentes do FF\_RUMBLE com cálculos e pesos por motor}
\IBGEtab{}{%
	\begin{tabular}{p{3cm}p{5cm}cc}
		\toprule
		Componente & Cálculo & Peso strong & Peso weak \\
		\midrule
		Motor & $throttle / 100 \times 60$ & 0,5 & 0,7 \\
		\midrule
		Bumps & $\min(|a_z - 9{,}81| / 9{,}81 \times 400,\; 100)$ & 0,3 & 0,3 \\
		\midrule
		Impacto frontal & $\min(|G_{frontal}| \times 200,\; 100)$ & 0,3 & --- \\
		\midrule
		Jerk BMI160 & $\min(|jerk| \times 8,\; 80)$ & 0,2 & --- \\
		\midrule
		Jerk controles & throttle/brake/steering burst & 1,0 & --- \\
		\midrule
		Rugosidade & $\min(\sigma_{pista} \times 80,\; 70)$ & --- & 1,0 \\
		\midrule
		Stress lateral & $\min(|G_{lateral}| \times 150,\; 80)$ & 0,3 & 0,4 \\
		\midrule
		Frenagem & $\min(brake / 100 \times 70,\; 70)$ & 0,5 & 0,3 \\
		\bottomrule
	\end{tabular}%
}{%
\Fonte{elaborado pelo autor.}%
}
\end{table}

\noindent A saída de cada motor é limitada a 100\% e suavizada por filtro EMA com 60\% de peso para o valor novo.

\begin{figure}[h!]
	\centering
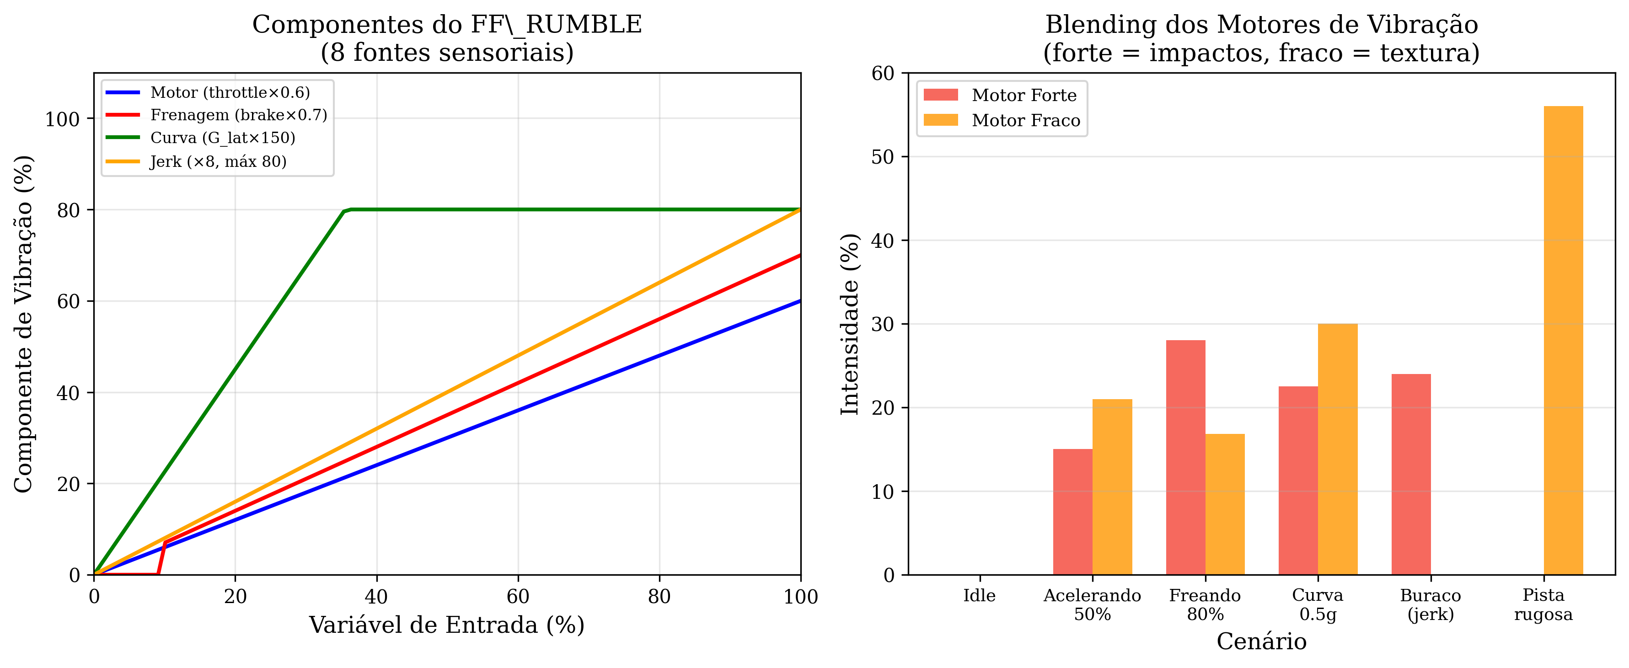
[picture p17: monografia/figuras/ff_charts/ff_rumble.png]
	
	\Caption{\label{fig:ff-rumble} Componentes do FF\_RUMBLE e distribuição entre os motores forte e fraco}
\end{figure}

O efeito \texttt{FF\_PERIODIC} gera uma onda senoidal cuja frequência é proporcional à posição do acelerador, simulando a vibração do motor em diferentes rotações. A frequência varia de 5Hz em marcha lenta a 12,5Hz em aceleração total, com magnitude variando de 15\% (\textit{idle}) até 90\% (aceleração máxima). O efeito \texttt{FF\_INERTIA} simula o peso do volante, com coeficiente variando de 5\% (veículo parado) até 80\% (alta velocidade), calculado automaticamente a partir da velocidade estimada e posição do acelerador, suavizado por filtro EMA com 30\% de peso para o valor novo. A \autoref{fig:ff-periodic-inertia} apresenta o comportamento desses dois efeitos.

\begin{figure}[h!]
	\centering
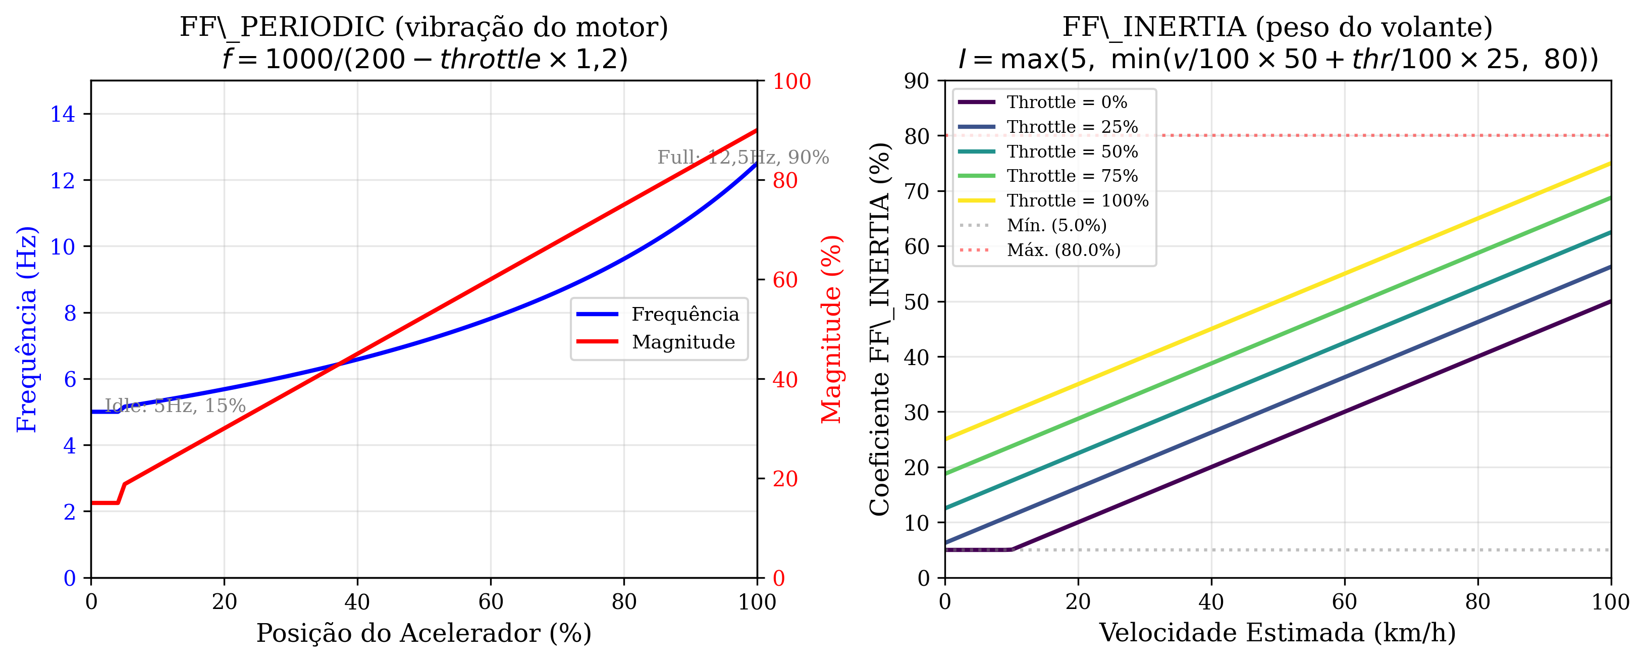
[picture p18: monografia/figuras/ff_charts/ff_periodic_inertia.png]
	
	\Caption{\label{fig:ff-periodic-inertia} FF\_PERIODIC (frequência e magnitude vs. acelerador) e FF\_INERTIA (peso do volante vs. velocidade)}
\end{figure}

Quando o veículo é detectado como parado (conforme os limiares descritos acima), o \texttt{FF\_CONSTANT} e \texttt{FF\_RUMBLE} decaem rapidamente, o \texttt{FF\_PERIODIC} vai para 0\% e o \texttt{FF\_INERTIA} retorna ao mínimo de 5\%.

\subsubsection{Cálculo de Velocidade por Integração}

O veículo não possui sensor de velocidade dedicado (encoder nas rodas ou GPS). A velocidade é estimada a partir dos dados de aceleração do BMI160, que já está no barramento \gls{I2C} para o sistema de force feedback.

A relação entre aceleração e velocidade é dada pela definição cinemática $a = dv/dt$. Isolando $dv$:

\begin{equation}
\label{eq:cinematica-base}
dv = a \cdot dt
\end{equation}

\noindent Integrando ambos os lados para obter a velocidade:

\begin{equation}
\label{eq:velocidade-integral}
v(t) = v(0) + \int_0^t a(\tau) \, d\tau
\end{equation}

\noindent Como o acelerômetro fornece amostras discretas a cada $\Delta t$, a integral é aproximada pelo método de Euler (ver \autoref{eq:metodo-euler}), substituindo $\int a \, d\tau$ por $a \cdot \Delta t$:

\begin{equation}
\label{eq:velocidade-euler}
v(t) = v(t-1) + a \cdot \Delta t
\end{equation}

\noindent Essa é a mesma discretização usada no modelo do motor (\autoref{eq:euler-motor}), aplicada à relação cinemática em vez da equação diferencial do sistema de 1ª ordem. A diferença é que no motor o Euler resolve $\dot{y} = (K - y)/\tau$ (convergência a um alvo), enquanto aqui resolve $\dot{v} = a$ (acumulação livre).

Essa abordagem introduz deriva ao longo do tempo, pois erros pequenos do acelerômetro se acumulam a cada integração. Para mitigar isso, três mecanismos são aplicados: um limiar de ruído que zera acelerações abaixo de 0,3~m/s² (evitando acúmulo de ruído em repouso), um fator de decaimento de 0,98 por iteração que simula atrito e puxa a velocidade para zero quando não há aceleração, e um limiar mínimo que zera velocidades abaixo de 0,1~m/s. A precisão não é comparável a um encoder, mas é suficiente para os gráficos de telemetria e o cálculo de inércia do force feedback. A \autoref{fig:ff-velocidade} ilustra o processo. O decaimento é aplicado após a integração:

\begin{equation}
\label{eq:velocidade-decaimento}
v_{final} = v(t) \times fator_{decaimento}
\end{equation}

\begin{figure}[h!]
	\centering
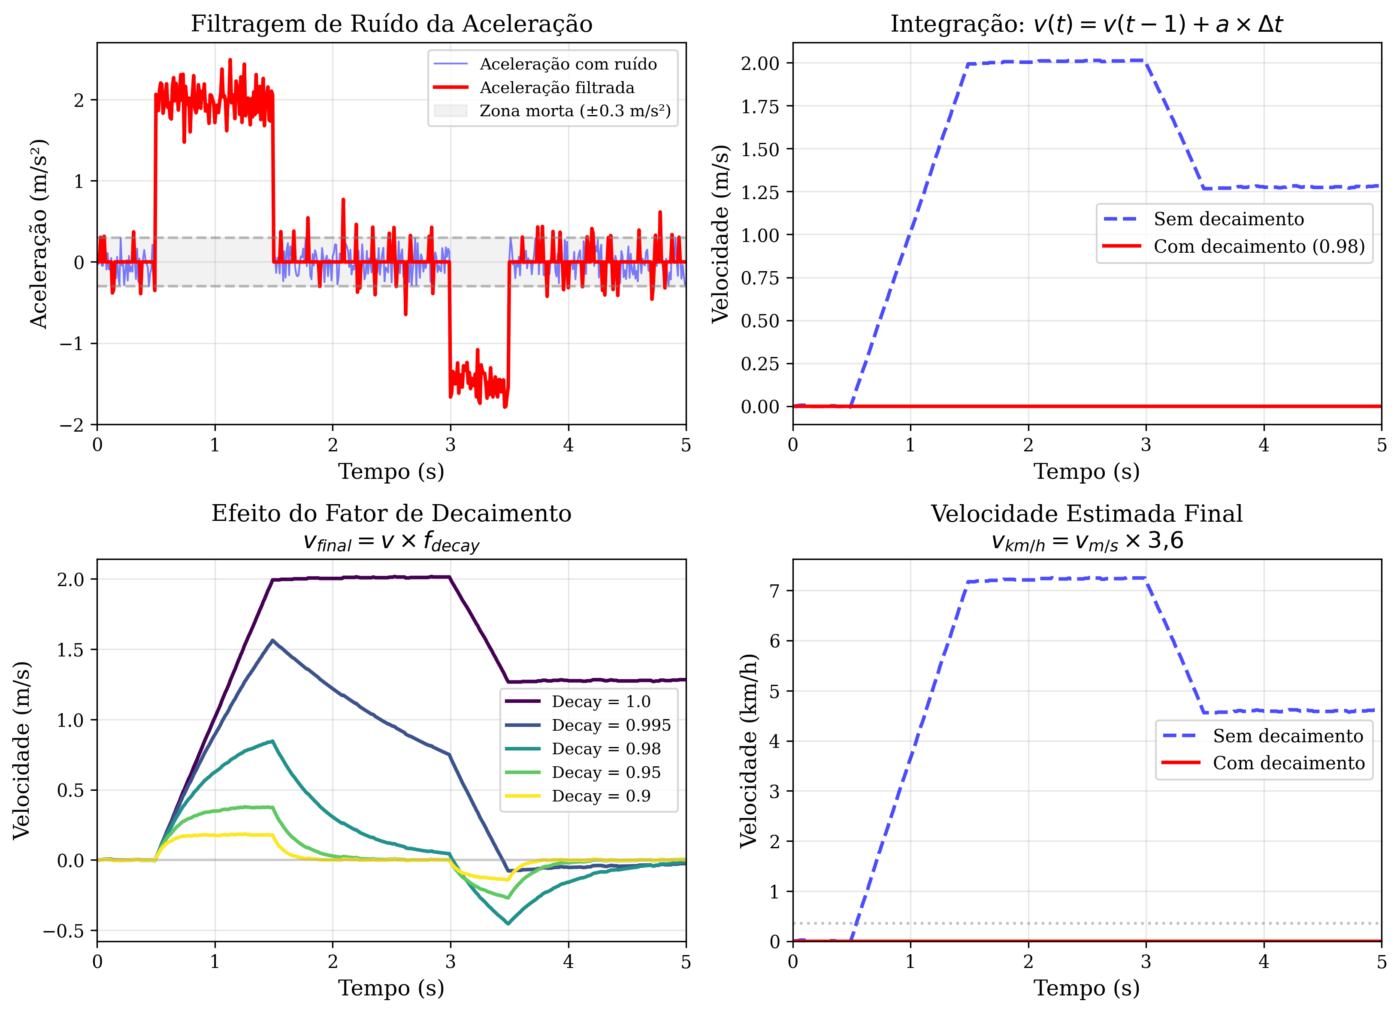
[picture p19: monografia/figuras/ff_charts/ff_velocidade.png]
	
	\Caption{\label{fig:ff-velocidade} Processo de integração de aceleração para estimativa de velocidade}
\end{figure}

\begin{algorithm}[h!]
	\SetSpacedAlgorithm
	\caption{\label{alg:calcular-velocidade}Cálculo de velocidade por integração}
	\Entrada{accel\_x, accel\_y, tempo\_atual}
	\Saida{velocidade\_total\_kmh}
	\Inicio{
		LIMIAR\_ACCEL $\leftarrow$ 0.3\;
		FATOR\_DECAIMENTO $\leftarrow$ 0.98\;
		LIMIAR\_VELOCIDADE $\leftarrow$ 0.1\;
		// Calcula delta time\;
		dt $\leftarrow$ tempo\_atual - tempo\_anterior\;
		tempo\_anterior $\leftarrow$ tempo\_atual\;
		// Filtra ruído da aceleração\;
		\Se{abs(accel\_x) < LIMIAR\_ACCEL}{accel\_x $\leftarrow$ 0\;}
		\Se{abs(accel\_y) < LIMIAR\_ACCEL}{accel\_y $\leftarrow$ 0\;}
		// Integração: v = v0 + a $\times$ dt\;
		velocidade\_x $\leftarrow$ velocidade\_x + accel\_x $\times$ dt\;
		velocidade\_y $\leftarrow$ velocidade\_y + accel\_y $\times$ dt\;
		// Aplica decaimento (simula atrito)\;
		velocidade\_x $\leftarrow$ velocidade\_x $\times$ FATOR\_DECAIMENTO\;
		velocidade\_y $\leftarrow$ velocidade\_y $\times$ FATOR\_DECAIMENTO\;
		// Zera velocidades muito pequenas\;
		\Se{abs(velocidade\_x) < LIMIAR\_VELOCIDADE}{velocidade\_x $\leftarrow$ 0\;}
		\Se{abs(velocidade\_y) < LIMIAR\_VELOCIDADE}{velocidade\_y $\leftarrow$ 0\;}
		// Calcula magnitude e converte para km/h\;
		velocidade\_ms $\leftarrow$ raiz(velocidade\_x$^2$ + velocidade\_y$^2$)\;
		velocidade\_total\_kmh $\leftarrow$ velocidade\_ms $\times$ 3.6\;
	}
\end{algorithm}

\subsection{Sistema de Telemetria em Tempo Real}
\label{subsec:telemetria-cliente}

O sistema de telemetria exibe gráficos em tempo real com visual inspirado nas interfaces de engenharia de equipes de Fórmula 1, utilizando a biblioteca Matplotlib integrada ao framework gráfico Tkinter. Os dados de sensores são armazenados em \glspl{buffercircular} implementados com estruturas \textit{deque} do Python, com capacidade máxima de 500 pontos. Essa capacidade representa aproximadamente 50 segundos de histórico considerando a taxa de atualização de 10Hz, permitindo ao operador visualizar tendências recentes sem consumo excessivo de memória. O \autoref{alg:atualizar-telemetria} (ver \autoref{apendice:algoritmos-auxiliares}) detalha o processo de atualização dos gráficos.

\section{Armazenamento de Logs e Validação}
\label{sec:logs-validacao}

O sistema implementa salvamento automático periódico dos dados coletados durante as sessões de operação. A cada 20 segundos, o sistema verifica se há dados novos suficientes e exporta logs, dados de sensores e telemetria para arquivos no diretório \texttt{exports/auto/}. O formato Pickle (binário nativo do Python) foi escolhido por oferecer performance 5 a 10 vezes superior ao CSV para \gls{serializacao} de estruturas de dados complexas. Após cada salvamento, os buffers são limpos para evitar duplicação. O \autoref{alg:auto-save} (ver \autoref{apendice:algoritmos-auxiliares}) detalha a lógica de verificação e salvamento.

\subsection{Formatos de Armazenamento}
\label{subsec:formatos-armazenamento}

A \autoref{tab:formatos-armazenamento} apresenta os formatos utilizados para cada tipo de dado.

\begin{table}[!h]
\captionsetup{width=16cm}
\Caption{\label{tab:formatos-armazenamento} Formatos de armazenamento utilizados no sistema de auto-save}
\IBGEtab{}{%
	\begin{tabular}{p{3cm}p{2.5cm}p{9cm}}
		\toprule
		Tipo de Dado & Formato & Justificativa \\
		\midrule \midrule
		Logs do console & Texto (.txt) & Legibilidade humana para inspeção durante depuração \\
		\midrule
		Sensores brutos & Pickle (.pkl) & Serialização binária eficiente de dicionários com listas numéricas \\
		\midrule
		Telemetria & Pickle (.pkl) & Preservação de estruturas Python com metadados de sessão \\
		\bottomrule
	\end{tabular}%
}{%
\Fonte{elaborado pelo autor.}%
}
\end{table}

Os arquivos de log mantêm formato texto para permitir inspeção manual durante depuração.

\subsection{Estrutura dos Dados Armazenados}
\label{subsec:estrutura-dados-armazenados}

Os arquivos de sensores contêm dicionários Python com listas de valores para cada canal do sensor BMI160 e do sistema de monitoramento de energia. Cada lista contém valores correspondentes ao mesmo índice temporal, permitindo correlação entre diferentes grandezas. A \autoref{tab:chaves-sensores} lista as chaves disponíveis.

\begin{table}[!h]
\captionsetup{width=16cm}
\Caption{\label{tab:chaves-sensores} Chaves dos dicionários nos arquivos de sensores e telemetria}
\IBGEtab{}{%
	\begin{tabular}{p{3.5cm}p{11.5cm}}
		\toprule
		Arquivo & Chaves \\
		\midrule
		\texttt{sensors\_*.pkl} & \texttt{timestamp}, \texttt{bmi160\_accel\_\{x,y,z\}}, \texttt{bmi160\_gyro\_\{x,y,z\}}, \texttt{g\_force\_lateral}, \texttt{g\_force\_frontal}, \texttt{current\_motor}, \texttt{current\_servos}, \texttt{current\_rpi}, \texttt{power\_total}, \texttt{voltage\_rpi} \\
		\midrule
		\texttt{telemetry\_*.pkl} & \texttt{time}, \texttt{speed}, \texttt{throttle}, \texttt{brake}, \texttt{g\_lateral}, \texttt{g\_frontal}, \texttt{start\_time}, \texttt{points\_count}, \texttt{export\_time} \\
		\bottomrule
	\end{tabular}%
}{%
\Fonte{elaborado pelo autor.}%
}
\end{table}

\noindent Os arquivos de telemetria contêm valores já filtrados e normalizados, prontos para visualização nos gráficos da interface.

\subsection{Métricas de Validação Extraídas}
\label{subsec:metricas-validacao}

Os dados armazenados pelo sistema de auto-save permitem a extração de métricas específicas para validação do desempenho do sistema. A \autoref{tab:metricas-validacao} apresenta as métricas extraídas de cada categoria de dados, organizadas por subsistema avaliado.

\begin{table}[!h]
\captionsetup{width=16cm}
\Caption{\label{tab:metricas-validacao} Métricas de validação extraídas dos dados armazenados}
\IBGEtab{}{%
	\begin{tabular}{p{3cm}p{4cm}p{4cm}p{4cm}}
		\toprule
		Subsistema & Métrica & Fonte de Dados & Cálculo \\
		\midrule \midrule
		\multirow{3}{*}{Comunicação} & Latência média & \texttt{timestamp} & Diferença entre envio e recepção \\
		& \Gls{jitter} & \texttt{timestamp} & Desvio padrão dos intervalos \\
		& Packet loss & \texttt{logs\_*.txt} & Contagem de erros de recepção \\
		\midrule
		\multirow{3}{*}{Vídeo} & FPS efetivo & \texttt{telemetry\_*.pkl} & Frames por segundo médio \\
		& Estabilidade & \texttt{telemetry\_*.pkl} & Variância do intervalo entre frames \\
		& Throughput & \texttt{sensors\_*.pkl} & Bytes por segundo \\
		\midrule
		\multirow{3}{*}{Sensores} & Taxa de amostragem & \texttt{sensors\_*.pkl} & Amostras por segundo \\
		& \Gls{drifttermico} & \texttt{temperature} & Variação ao longo do tempo \\
		& Ruído & \texttt{bmi160\_accel\_*} & Desvio padrão em repouso \\
		\midrule
		\multirow{3}{*}{Force Feedback} & Tempo de resposta & \texttt{timestamp} & Latência comando-atuação \\
		& Precisão & \texttt{g\_force\_*} & Correlação sensor-feedback \\
		& Estabilidade & \texttt{gyro\_z} & Variância em regime permanente \\
		\midrule
		\multirow{2}{*}{Energia} & Consumo médio & \texttt{power\_total} & Média de potência \\
		& Pico de corrente & \texttt{current\_motor} & Valor máximo registrado \\
		\bottomrule
	\end{tabular}%
}{%
\Fonte{elaborado pelo autor.}%
}
\end{table}

Os dados armazenados podem ser processados por scripts personalizados para extrair estatísticas, identificar padrões de comportamento e comparar sessões. Por exemplo, o intervalo entre timestamps consecutivos permite estimar a latência efetiva, o desvio padrão desses intervalos caracteriza o jitter, e a análise de logs identifica eventos de erro para cálculo da taxa de perda de pacotes.

Com taxa de amostragem de 100Hz para sensores e sessões de 25 minutos (duração adotada para os testes internos e externos), cada sessão gera aproximadamente 150.000 pontos de telemetria.

\subsection{Reprodutibilidade e Código Fonte}
\label{subsec:reprodutibilidade-codigo}

Para permitir a replicação dos experimentos conforme as diretrizes de \citeonline{graf2024monitoring}, o código fonte está disponível no GitHub sob licença MIT em \url{https://github.com/inacio-dev/tcc}. A \autoref{tab:estrutura-repositorio} apresenta a organização do repositório.

\begin{table}[!h]
\captionsetup{width=16cm}
\Caption{\label{tab:estrutura-repositorio} Estrutura do repositório de código fonte}
\IBGEtab{}{%
	\begin{tabular}{p{3.5cm}p{11cm}}
		\toprule
		Diretório & Conteúdo \\
		\midrule \midrule
		\texttt{raspberry/} & Scripts Python para controle do Raspberry Pi 4: captura de vídeo, leitura de sensores BMI160, controle de motor e servos, comunicação \gls{UDP} \\
		\midrule
		\texttt{client/} & Interface gráfica em Python/Tkinter, recepção \gls{UDP}, integração com G923 via evdev, processamento de telemetria e sistema de auto-save \\
		\midrule
		\texttt{pro\_micro/} & Firmware Arduino para Pro Micro: leitura de sensores ACS758, tensão da bateria e comunicação serial USB \\
		\midrule
		\texttt{exports/auto/} & Datasets de telemetria em formato Pickle (.pkl) e logs de sessões (.txt) \\
		\midrule
		\texttt{scripts/} & Rotinas de análise estatística e geração de gráficos \\
		\midrule
		\texttt{docs/} & Documentação técnica das decisões de projeto \\
		\midrule
		\texttt{monografia/} & Código fonte \LaTeX\ deste documento \\
		\bottomrule
	\end{tabular}%
}{%
\Fonte{elaborado pelo autor.}%
}
\end{table}

Os datasets coletados durante as sessões experimentais estão no diretório \texttt{exports/auto/} em formato Pickle, e o diretório \texttt{scripts/} contém rotinas de análise para processamento desses dados. As especificações de hardware do veículo estão na \autoref{tab:componentes-veiculo} e as da estação cliente no \autoref{apendice:specs-equipamentos}. O Raspberry Pi 4 executa Raspberry Pi OS Bullseye 64-bit (kernel 5.15.84-v8+), e a rede wireless opera em 5~GHz via roteador TP-Link Deco M4 V4 (Wi-Fi 5 AC1200).

% ============================================================================
% PROTOCOLO EXPERIMENTAL
% ============================================================================
\section{Protocolo Experimental}
\label{sec:protocolo-experimental}

Os resultados obtidos a partir deste protocolo são apresentados no \autoref{chap:resultados}.

\subsection{Ambientes de Teste}
\label{subsec:ambientes-teste}

Os testes foram realizados em dois ambientes. O ambiente interno é uma sala de 5m $\times$ 8m a 27$\pm$2°C, com o veículo estacionário sobre superfície plana --- sem vibração mecânica, o que permite isolar a validação de comunicação \gls{UDP}, telemetria, leitura de sensores e calibração do \textit{force feedback}. O ambiente externo é uma área aberta de aproximadamente 700~m², onde o veículo opera em movimento para validar direção, frenagem, troca de marchas e resposta do \textit{force feedback} a manobras reais.

\subsection{Variáveis e Métricas}
\label{subsec:variaveis-metricas}

A \autoref{tab:variaveis-experimentais} organiza as variáveis experimentais por subsistema, distinguindo variáveis independentes (controladas pelo experimentador), dependentes (medidas pelo sistema) e controladas (mantidas constantes durante cada sessão).

\begin{table}[!h]
\captionsetup{width=16cm}
\Caption{\label{tab:variaveis-experimentais} Variáveis experimentais por subsistema}
\IBGEtab{}{%
	\begin{tabular}{p{2.5cm}p{4cm}p{4cm}p{4cm}}
		\toprule
		Subsistema & Independentes & Dependentes & Controladas \\
		\midrule \midrule
		Comunicação & Ambiente (interno/ externo), distância ao roteador & Latência \gls{UDP}, \gls{jitter}, perda de pacotes, \textit{throughput} & Roteador (TP-Link Deco M4, 5~GHz), configuração de \textit{buffers} \\
		\midrule
		Vídeo & Resolução (480p/720p), filtros \gls{PDI} ativos & \gls{FPS} efetivo, tamanho de frame, latência de codificação & Codec (\gls{MJPEG}), iluminação do ambiente \\
		\midrule
		Sensores & Regime de operação (repouso/ movimento) & Taxa de amostragem, ruído, \gls{drifttermico}, recuperação de \textit{brown-out} & Configuração BMI160 ($\pm$2g, $\pm$250°/s, 100Hz), temperatura ambiente \\
		\midrule
		Force feedback & Cenário de condução (reta/ curva/ frenagem), parâmetros dos \textit{sliders} & Intensidade e direção do \texttt{FF\_CONSTANT}, componentes do \texttt{FF\_RUMBLE}, percepção do operador & Ganho global (15\%), filtro \gls{EMA} (40\%) \\
		\midrule
		Energia & Regime de operação (idle/ aceleração/ frenagem) & Corrente do motor, corrente dos servos, tensão da bateria, potência total & Bateria \gls{LiPo} 3S carregada ($>$11,4V) \\
		\bottomrule
	\end{tabular}%
}{%
\Fonte{elaborado pelo autor.}%
}
\end{table}

\subsection{Procedimento de Coleta de Dados}
\label{subsec:procedimento-coleta}

Cada sessão segue um procedimento fixo: (1) verificar carga da bateria ($>$11,4V) e conexão WiFi em 5~GHz; (2) inicializar o sistema embarcado e o cliente PC; (3) calibrar o G923 com movimentação completa de volante e pedais; (4) aguardar 60 segundos de estabilização dos sensores; e (5) coletar dados durante 25 minutos com auto-save a cada 20 segundos. Os 25 minutos geram aproximadamente 150.000 pontos de telemetria a 100Hz e permitem observar efeitos térmicos no Raspberry Pi e na bateria.

No ambiente interno, as sessões avaliam comunicação \gls{UDP} (latência, \gls{jitter}, perda de pacotes), taxa de quadros de vídeo, leitura de sensores em repouso (ruído, \textit{offset}, estabilidade) e calibração do \textit{force feedback}. No ambiente externo, avaliam o sistema em operação: resposta da direção e freios, troca de marchas, \textit{force feedback} durante manobras, consumo de energia sob carga e estabilidade térmica.

\subsection{Critérios de Aceitação}
\label{subsec:criterios-aceitacao}

A \autoref{tab:criterios-aceitacao} lista os critérios mínimos de aceitação por subsistema.

\begin{table}[!h]
\captionsetup{width=16cm}
\Caption{\label{tab:criterios-aceitacao} Critérios de aceitação por subsistema}
\IBGEtab{}{%
	\begin{tabular}{p{3cm}p{4.5cm}p{3.5cm}p{4cm}}
		\toprule
		Subsistema & Métrica & Critério & Referência \\
		\midrule \midrule
		Comunicação & Latência \gls{UDP} fim a fim & $<$5~ms & \citeonline{ito2025teleoperation} \\
		\midrule
		Comunicação & Perda de pacotes & $<$1\% & Operação em rede local \\
		\midrule
		Vídeo & \gls{FPS} em 480p & $\geq$25~fps & Fluidez perceptual mínima \\
		\midrule
		Sensores & Taxa de amostragem BMI160 & $\geq$95Hz & 95\% da taxa nominal \\
		\midrule
		Sensores & Recuperação de \textit{brown-out} & $<$500~ms & Requisito de segurança \\
		\midrule
		Force feedback & Latência sensor-atuação & $<$50~ms & Percepção tátil humana \\
		\midrule
		Force feedback & Coerência direcional & Direção correta $>$90\% & Correspondência com manobra \\
		\midrule
		Energia & Autonomia da bateria & $\geq$15~min & Duração mínima de sessão \\
		\midrule
		Térmico & Temperatura do RPi & $<$80°C & Limite de \textit{throttling} \\
		\bottomrule
	\end{tabular}%
}{%
\Fonte{elaborado pelo autor.}%
}
\end{table}

\subsection{Métodos de Análise}
\label{subsec:metodos-analise}

Os dados coletados são processados por scripts Python disponíveis no diretório \texttt{scripts/} do repositório. Para comunicação \gls{UDP}, os \textit{timestamps} de cada pacote permitem calcular latência média, percentis (P50, P95, P99), \gls{jitter} (desvio padrão dos intervalos entre pacotes) e taxa de perda. Para vídeo, são extraídos \gls{FPS} efetivo, distribuição de tamanho de frames e estabilidade temporal. Os dados do BMI160 em repouso fornecem o ruído (desvio padrão) e a taxa de amostragem efetiva; os logs identificam eventos de \textit{brown-out} e o tempo de recuperação. O \textit{force feedback} é avaliado pela correlação entre as forças G medidas e a intensidade aplicada ao volante --- a coerência direcional (se a força puxa para o lado correto) e o tempo de resposta entre sensor e atuação. O consumo de energia é analisado por componente (motor, servos, Raspberry Pi), com cálculo de autonomia da bateria. Os resultados são apresentados com estatísticas descritivas (média, desvio padrão, percentis), gráficos temporais e histogramas.
