inacio-dev/tcc/monografia/1-pre-textuais/lista-de-abreviaturas-e-siglas.tex

% ============================================================================
% PROTOCOLOS DE COMUNICAÇÃO
% ============================================================================
\newacronym{UDP}{UDP}{\textit{User Datagram Protocol}}
\newacronym{TCP}{TCP}{\textit{Transmission Control Protocol}}
\newacronym{I2C}{I2C}{\textit{Inter-Integrated Circuit}}
\newacronym{SPI}{SPI}{\textit{Serial Peripheral Interface}}
\newacronym{USB}{USB}{\textit{Universal Serial Bus}}
\newacronym{HID}{HID}{\textit{Human Interface Device}}
\newacronym{mDNS}{mDNS}{\textit{Multicast Domain Name System}}
\newacronym{DNS}{DNS}{\textit{Domain Name System}}
\newacronym{IP}{IP}{\textit{Internet Protocol}}
\newacronym{DHCP}{DHCP}{\textit{Dynamic Host Configuration Protocol}}
\newacronym{JSON}{JSON}{\textit{JavaScript Object Notation}}
\newacronym{ACK}{ACK}{\textit{Acknowledgment}}

% ============================================================================
% HARDWARE E ELETRÔNICA
% ============================================================================
\newacronym{GPIO}{GPIO}{\textit{General Purpose Input/Output}}
\newacronym{PWM}{PWM}{\textit{Pulse Width Modulation}}
\newacronym{CSI}{CSI}{\textit{Camera Serial Interface}}
\newacronym{ADC}{ADC}{\textit{Analog-to-Digital Converter}}
\newacronym{RAM}{RAM}{\textit{Random Access Memory}}
\newacronym{EEPROM}{EEPROM}{\textit{Electrically Erasable Programmable Read-Only Memory}}
\newacronym{UBEC}{UBEC}{\textit{Universal Battery Eliminator Circuit}}
\newacronym{LiPo}{LiPo}{\textit{Lithium Polymer}}
\newacronym{RSSI}{RSSI}{\textit{Received Signal Strength Indicator}}

% ============================================================================
% SENSORES E MEDIÇÃO
% ============================================================================
\newacronym{IMU}{IMU}{\textit{Inertial Measurement Unit}}
\newacronym{PPR}{PPR}{\textit{Pulses Per Revolution}}
\newacronym{FPS}{FPS}{\textit{Frames Per Second}}

% ============================================================================
% FORMATOS E CODIFICAÇÃO
% ============================================================================
\newacronym{MJPEG}{MJPEG}{\textit{Motion JPEG}}
\newacronym{JPEG}{JPEG}{\textit{Joint Photographic Experts Group}}
\newacronym{PDF}{PDF}{\textit{Portable Document Format}}

% ============================================================================
% PROCESSAMENTO DE IMAGEM
% ============================================================================
\newacronym{PDI}{PDI}{Processamento Digital de Imagens}
\newacronym{CLAHE}{CLAHE}{\textit{Contrast Limited Adaptive Histogram Equalization}}
\newacronym{GPU}{GPU}{\textit{Graphics Processing Unit}}
\newacronym{CPU}{CPU}{\textit{Central Processing Unit}}
\newacronym{CUDA}{CUDA}{\textit{Compute Unified Device Architecture}}

% ============================================================================
% PROCESSAMENTO DE SINAIS
% ============================================================================
\newacronym{EMA}{EMA}{\textit{Exponential Moving Average}}

% ============================================================================
% IMPRESSÃO 3D E MATERIAIS
% ============================================================================
\newacronym{PLA}{PLA}{\textit{Polylactic Acid}}

% ============================================================================
% NORMAS E INSTITUIÇÕES
% ============================================================================
\newacronym{ABNT}{ABNT}{Associação Brasileira de Normas Técnicas}
