inacio-dev/tcc/monografia/2-textuais/5-discussao.tex

\chapter{Discussão}
\label{chap:discussao}

Este capítulo analisa as expectativas de resultados à luz da fundamentação teórica apresentada, discutindo as implicações práticas e científicas esperadas. Com base nos testes preliminares de desenvolvimento e na literatura analisada, espera-se que a abordagem simplificada para sistemas de teleoperação com feedback háptico demonstre viabilidade e performance adequada para as aplicações propostas.

\textbf{Nota:} As análises apresentadas neste capítulo são baseadas em expectativas teóricas e testes de desenvolvimento. A validação formal será realizada em etapa posterior com coleta sistemática de dados.

\section{Interpretação Esperada no Contexto Teórico}
\label{sec:interpretacao-teorica}

Espera-se que a latência média do sistema fique abaixo de 3ms, o que representaria não apenas uma melhoria quantitativa, mas um marco teórico que questiona o paradigma vigente de que protocolos complexos são necessários para aplicações críticas em tempo real. Conforme demonstrado por \citeonline{lu2023udprt}, o UDP-RT deveria teoricamente superar UDP simples em aplicações críticas, porém nossa hipótese é que os resultados possam contradizer essa expectativa. A latência superior ao target teórico de 5ms pode ser explicada pela Lei de Amdahl aplicada a sistemas embarcados: o overhead de processamento de protocolos complexos supera seus benefícios quando os recursos computacionais são limitados.

Esta hipótese alinha-se com a teoria de trade-offs em sistemas embarcados, onde a otimização local de componentes pode degradar a performance global do sistema. O overhead adicional do UDP-RT, que inclui tempo de codificação e decodificação de aproximadamente 22,64ms conforme \citeonline{lu2023udprt}, pode tornar-se significativo no contexto do Raspberry Pi 4 quando comparado à latência end-to-end de 1,33ms do próprio protocolo, fundamentando nossa escolha por simplicidade eficaz sobre complexidade teórica.

A expectativa é que os algoritmos diretos de force feedback apresentem performance adequada em comparação com abordagens meta-heurísticas. Teoricamente, isso pode ser explicado pelo Princípio da Parcimônia aplicado a sistemas de controle: em ambientes com restrições temporais severas (<5ms), a simplicidade computacional pode superar a otimalidade teórica. Espera-se que a precisão dos algoritmos lineares simples seja suficiente para a aplicação, considerando que a complexidade adicional dos algoritmos LHHO e TLBO, conforme \citeonline{ayinla2024optimal}, pode introduzir latências que degradam a experiência háptica.

Esta expectativa contribui para a teoria emergente de "minimalismo inteligente" em sistemas distribuídos, onde a eficácia prática pode superar métricas acadêmicas de otimalidade. A hipótese é que, em sistemas de recursos limitados, a responsividade temporal seja mais crítica que a precisão matemática absoluta.

\section{Implicações Práticas e Teóricas Esperadas}
\label{sec:implicacoes-achados}

Os resultados esperados têm implicações diretas para a prática de engenharia em sistemas de teleoperação. A hipótese de que UDP simples pode superar protocolos avançados em cenários específicos sugere uma revisão necessária nos critérios de seleção tecnológica. Para desenvolvedores de sistemas embarcados, isso implica que a análise de trade-offs deve priorizar métricas de latência fim-a-fim sobre robustez teórica quando recursos são limitados.

O custo total estimado de R\$ 1.225 versus soluções comerciais que excedem R\$ 50.000 representa potencial democratização do acesso a tecnologias de teleoperação, podendo transformar setores como educação técnica e pesquisa acadêmica. Esta redução de custo de aproximadamente 97\% tornaria viável a implementação em escala educacional, criando oportunidades para formação prática em instituições com recursos limitados.

Teoricamente, este trabalho pretende contribuir para o paradigma emergente de simplicidade eficaz em sistemas distribuídos. Espera-se que os resultados sugiram que a Teoria da Complexidade aplicada a sistemas embarcados necessita revisão: complexidade algorítmica nem sempre se traduz em melhor performance quando consideradas restrições práticas. Para a teoria de interfaces hápticas, a eficácia esperada de algoritmos lineares simples pode desafiar modelos que priorizam sofisticação matemática sobre responsividade temporal.

O sucesso esperado da abordagem simplificada indica uma tendência futura em direção ao "minimalismo inteligente" no design de sistemas embarcados. Antecipa-se que pesquisas futuras explorem sistematicamente os limites inferiores de complexidade necessária para diferentes classes de aplicações. A escalabilidade esperada do Raspberry Pi 4 sugere que gerações futuras de SBCs permitirão implementações ainda mais sofisticadas mantendo a filosofia de simplicidade eficaz.

\section{Confronto Esperado com a Literatura Existente}
\label{sec:confronto-literatura}

Espera-se que o sistema alcance melhoria significativa em FPS comparado a \citeonline{shendge2023development}, atribuída a três fatores principais: otimização do pipeline de processamento de vídeo com codificação MJPEG (frames independentes), uso de mDNS para descoberta de serviços e eliminação de camadas desnecessárias de abstração. Enquanto Shendge et al. implementaram streaming genérico com foco em múltiplas aplicações, nossa abordagem especializada para teleoperação visa eliminar overhead computacional. A resolução de 640×480 versus 320×240 pode demonstrar que especificação focada supera generalização quando recursos são limitados.

Esta hipótese contradiz a tendência de desenvolvimento de soluções generalistas e reforça a validade de design orientado a aplicação específica. A otimização sistema-específica pode resultar em eficiência significativamente superior, validando a hipótese de que especialização supera generalização em sistemas de recursos limitados.

Espera-se que a latência do sistema supere implementações práticas como \citeonline{ito2025multipath} com 5ms, e possivelmente se aproxime dos limites demonstrados pelo UDP-RT (latência end-to-end de aproximadamente 1,33ms em rede não congestionada, segundo \citeonline{lu2023udprt}). Isso pode ser explicado pela diferença entre latência de protocolo e latência fim-a-fim: enquanto UDP-RT otimiza a camada de transporte com mecanismos de correção de erros, nossa implementação visa otimizar o sistema completo com abordagem simplificada.

No entanto, deve-se considerar que essas comparações envolvem diferentes configurações de hardware e cenários de teste, limitando a generalização direta dos resultados. A validade externa dos resultados necessitará validação através de estudos comparativos diretos com hardware idêntico.

A literatura atual sobre force feedback, conforme \citeonline{ayinla2024optimal} e \citeonline{manuel2023control}, demonstra superioridade de algoritmos meta-heurísticos em cenários controlados com recursos ilimitados. Porém, esses estudos falham em considerar restrições práticas de sistemas embarcados de baixo custo. Nossa abordagem visa demonstrar que o contexto de aplicação é fundamental: algoritmos "subótimos" matematicamente podem ser "ótimos" praticamente quando restrições temporais e computacionais são consideradas.

A expectativa é que a precisão dos algoritmos lineares seja suficiente para a aplicação, representando um trade-off aceitável considerando a redução drástica em complexidade e custo de implementação. Esta hipótese contribui para a teoria de otimalidade contextual, onde a definição de "ótimo" deve incluir restrições práticas além de métricas puramente matemáticas.

\section{Generalização e Aplicabilidade Esperada}
\label{sec:generalizacao-aplicabilidade}

A generalização dos resultados deverá considerar o contexto específico de aplicação: sistemas de teleoperação de baixo custo com restrições de latência <5ms. Os achados esperados são potencialmente aplicáveis a cenários com características similares: recursos computacionais limitados, orçamento restrito, e priorização de responsividade sobre robustez máxima. Limitações de generalização incluem: escala do veículo (1:10), ambiente controlado de testes, e foco em aplicações não-críticas para segurança.

Para aplicações industriais críticas ou veículos em escala real, a validade externa dos resultados necessitará validação adicional através de estudos específicos. A transferência direta dos resultados para sistemas críticos de segurança requereria análise rigorosa de modos de falha e implementação de redundâncias apropriadas.

Os princípios propostos são potencialmente aplicáveis a domínios além da teleoperação veicular, incluindo robótica médica de baixo custo, controle remoto industrial em ambientes não-críticos, e sistemas educacionais de engenharia. Para robótica médica, adaptações incluiriam sensores de maior precisão e protocolos de segurança adicionais, mantendo a filosofia de simplicidade eficaz. Na educação técnica, a viabilidade econômica estimada (R\$ 1.225) permitiria implementação em escala, democratizando acesso a tecnologias avançadas.

A transferência para IoT industrial requereria adaptações para ambientes agressivos, mas os princípios fundamentais de otimização sistema-específica permanecem válidos. A aplicabilidade em sistemas de monitoramento remoto, agricultura de precisão e automação residencial demonstra o potencial de scaling para múltiplos domínios.

Espera-se que os resultados contribuam para estabelecimento de benchmarks práticos para sistemas de teleoperação de baixo custo. As metas de métricas (latência <3ms, FPS >29, precisão >95\%) podem servir como referência para avaliação de sistemas similares. A metodologia de validação proposta oferece framework replicável para comparações futuras, potencialmente influenciando padrões da indústria para aplicações não-críticas.

\section{Análise Crítica das Limitações Metodológicas}
\label{sec:limitacoes-metodologicas}

O design experimental apresenta limitações que deverão ser consideradas na interpretação dos resultados. Os testes serão realizados em ambiente controlado com interferência WiFi limitada, podendo superestimar a performance em condições reais de operação. A validação inicial pode ter amostra limitada de usuários, limitando a generalização para diferentes perfis de operadores, especialmente considerando variabilidade em experiência e preferências hápticas.

As limitações de instrumentação afetam a precisão das medições e, consequentemente, a validade dos resultados. O sensor BMI160, embora adequado para aplicação de baixo custo, apresenta ruído intrínseco que será mitigado através de calibração automática. A câmera OV5647 em resolução 640×480 representa trade-off consciente entre qualidade visual e performance computacional, mas limita aplicabilidade a cenários que exigem maior resolução.

A ausência de sensores de força nos pneus impede validação direta da correlação entre dados do IMU e forças reais experimentadas pelo veículo. Esta limitação poderá reduzir a confiabilidade das métricas de force feedback, especialmente para validação quantitativa da precisão dos algoritmos implementados.

A análise estatística planejada deverá incluir testes de significância formal (ANOVA, t-tests) para garantir confiança nas comparações com o estado da arte. O tamanho da amostra deverá ser suficientemente grande para permitir análise de variabilidade temporal. A análise de poder estatístico a priori será considerada para evitar conclusões baseadas em diferenças estatisticamente insignificantes.

\section{Síntese das Contribuições Científicas Esperadas}
\label{sec:contribuicoes-cientificas}

Este trabalho pretende contribuir teoricamente para o paradigma emergente de simplicidade eficaz em sistemas distribuídos, buscando demonstrar que complexidade algorítmica nem sempre se traduz em melhor performance quando consideradas restrições práticas. A validação empírica de que algoritmos simples podem apresentar desempenho adequado em contextos específicos pode desafiar pressupostos da literatura atual sobre otimização de sistemas embarcados.

A hipótese de que UDP simples pode apresentar performance competitiva com UDP-RT em aplicações específicas pode contribuir para a teoria de protocolos de comunicação, mostrando que otimização sistêmica pode superar otimização de camada individual. Esta descoberta teria implicações para design de sistemas distribuídos, sugerindo que a arquitetura holística é mais crítica que a sofisticação de componentes individuais.

Praticamente, o trabalho visa demonstrar viabilidade de sistemas de teleoperação avançados com orçamento reduzido (R\$ 1.225 estimado vs R\$ 50.000+ comerciais), representando potencial democratização de 97\% no acesso à tecnologia. A implementação de referência com código aberto e documentação completa facilitará reprodução e extensão pela comunidade científica, potencialmente acelerando desenvolvimento de soluções similares.

O framework de validação proposto oferece métricas padronizadas para benchmarking de sistemas similares, preenchendo lacuna metodológica na literatura. As métricas de latência fim-a-fim, precisão de force feedback e eficiência energética estabelecerão baseline para comparações futuras na área.

Os resultados esperados indicam direções promissoras para pesquisas futuras, incluindo: exploração sistemática dos limites inferiores de complexidade necessária para diferentes classes de aplicações; desenvolvimento de teorias formais para trade-offs entre simplicidade e performance em sistemas embarcados; e investigação de scaling das soluções para aplicações industriais críticas.

O trabalho visa estabelecer fundamentos para linha de pesquisa em "minimalismo inteligente" para sistemas embarcados, com potencial para influenciar práticas de desenvolvimento e ensino na área. A demonstração de que soluções simples e eficazes podem apresentar desempenho adequado teria implicações pedagógicas importantes para formação de engenheiros, enfatizando a importância de análise contextual sobre aplicação direta de teorias abstratas.
