inacio-dev/tcc/monografia/1-pre-textuais/epigrafe.tex

"Nenhuma quantidade de dinheiro pode comprar um segundo de tempo."

\autordaepigrafe{Tony Stark, Vingadores: Ultimato (2019)}

% Deixe o espaço entre a epigrafe e o autor.
