inacio-dev/tcc/monografia/figuras/contagiros_marchas.png

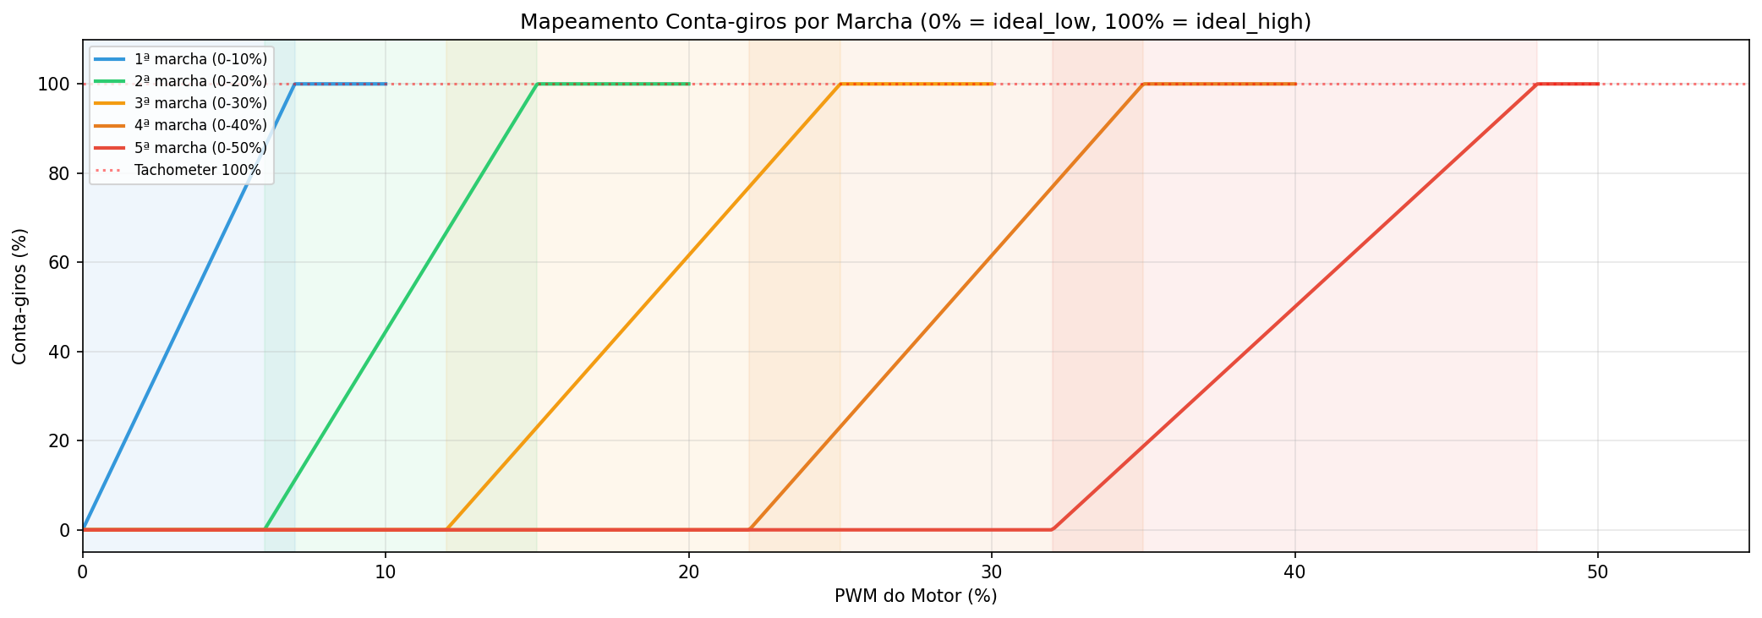
monografia/figuras/contagiros_marchas.png
