inacio-dev/tcc/monografia/figuras/ode_campo_direcoes.png

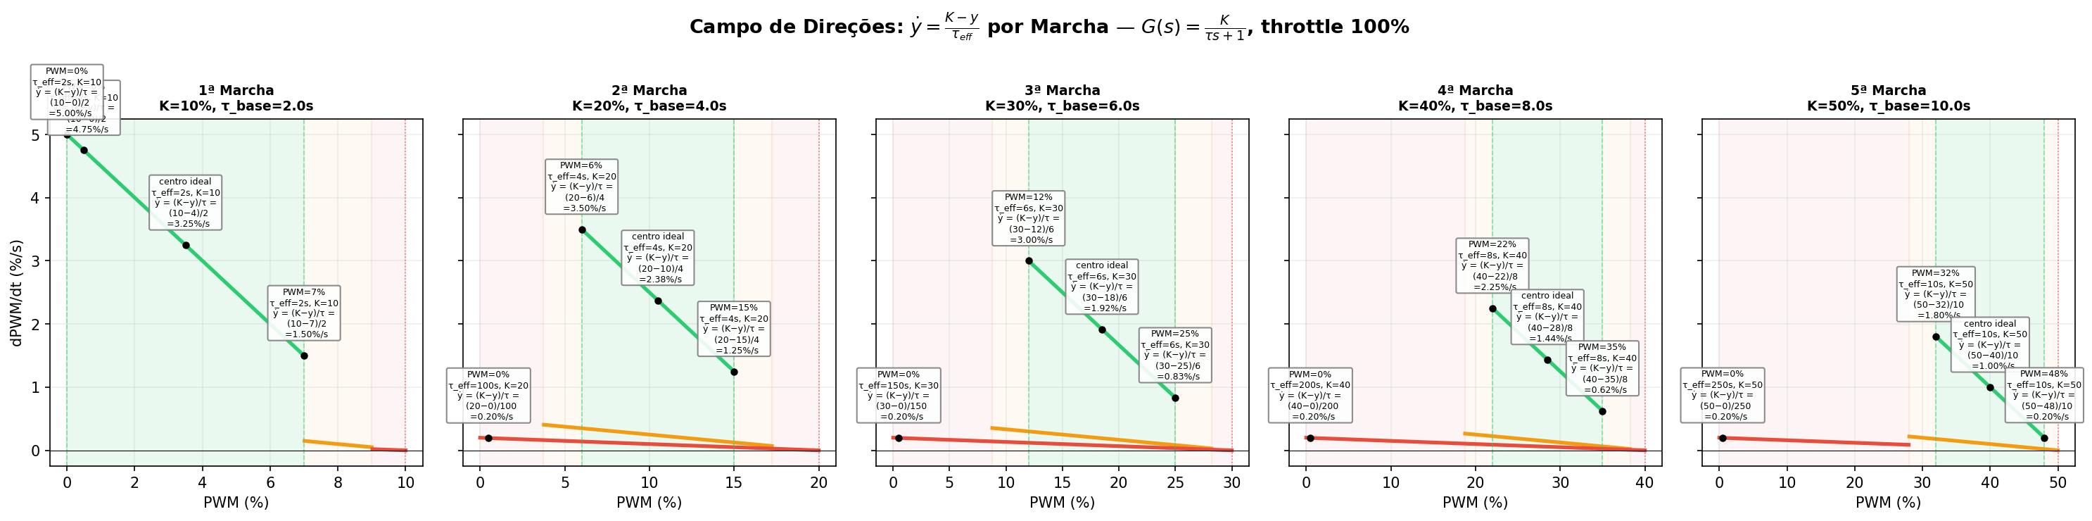
monografia/figuras/ode_campo_direcoes.png
