inacio-dev/tcc/monografia/figuras/simulacao_completa_marchas.png

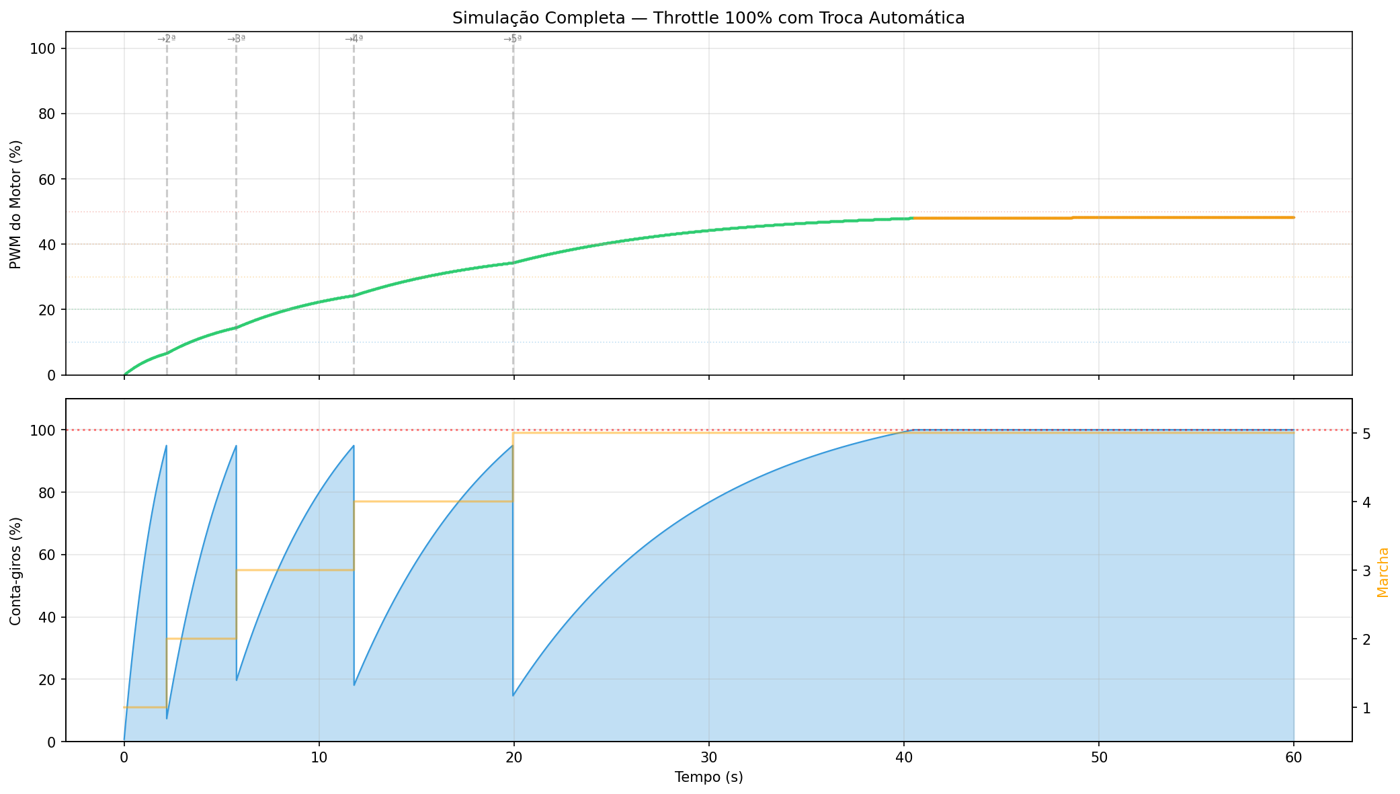
monografia/figuras/simulacao_completa_marchas.png
