inacio-dev/tcc/monografia/figuras/tau_efetivo_marchas.png

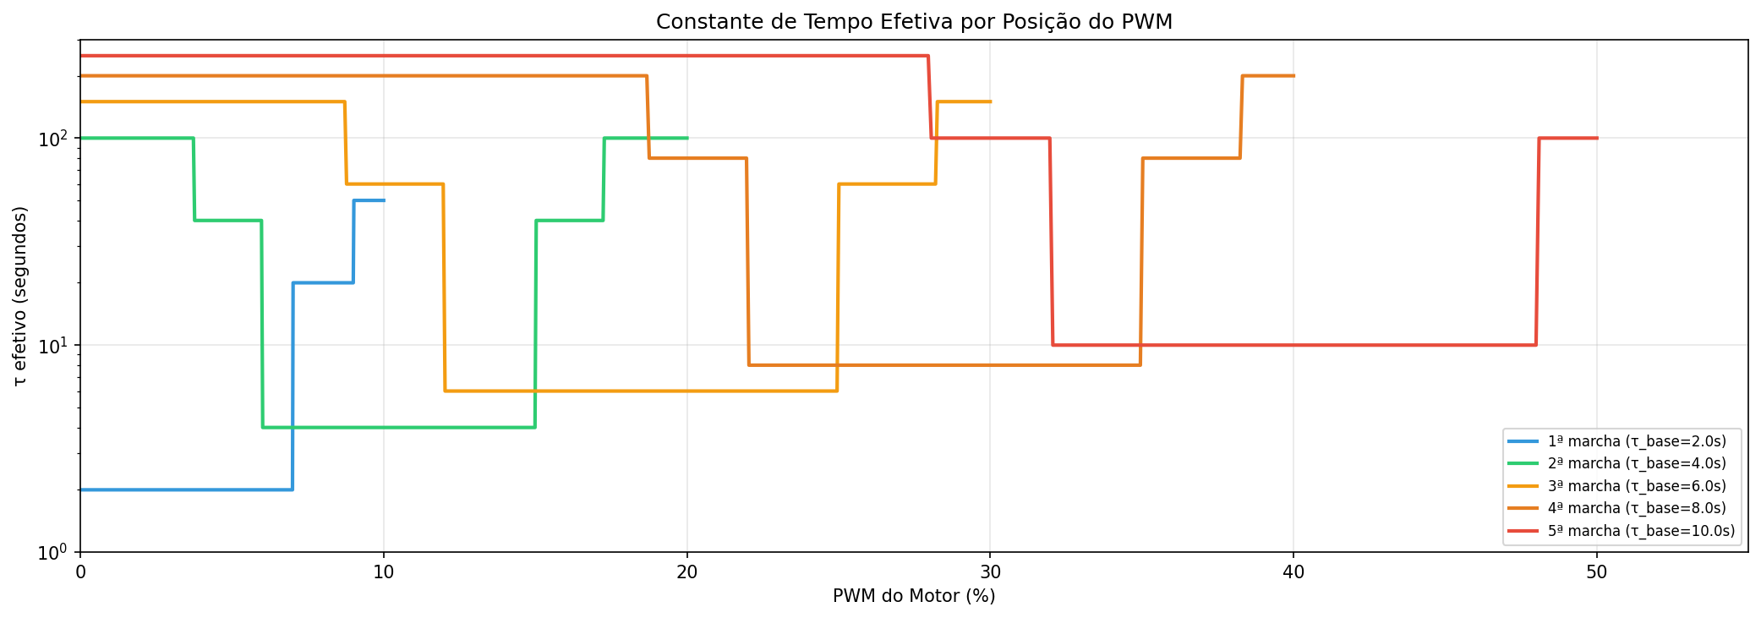
monografia/figuras/tau_efetivo_marchas.png
