inacio-dev/tcc/monografia/figuras/tau_evolucao_simulacao.png

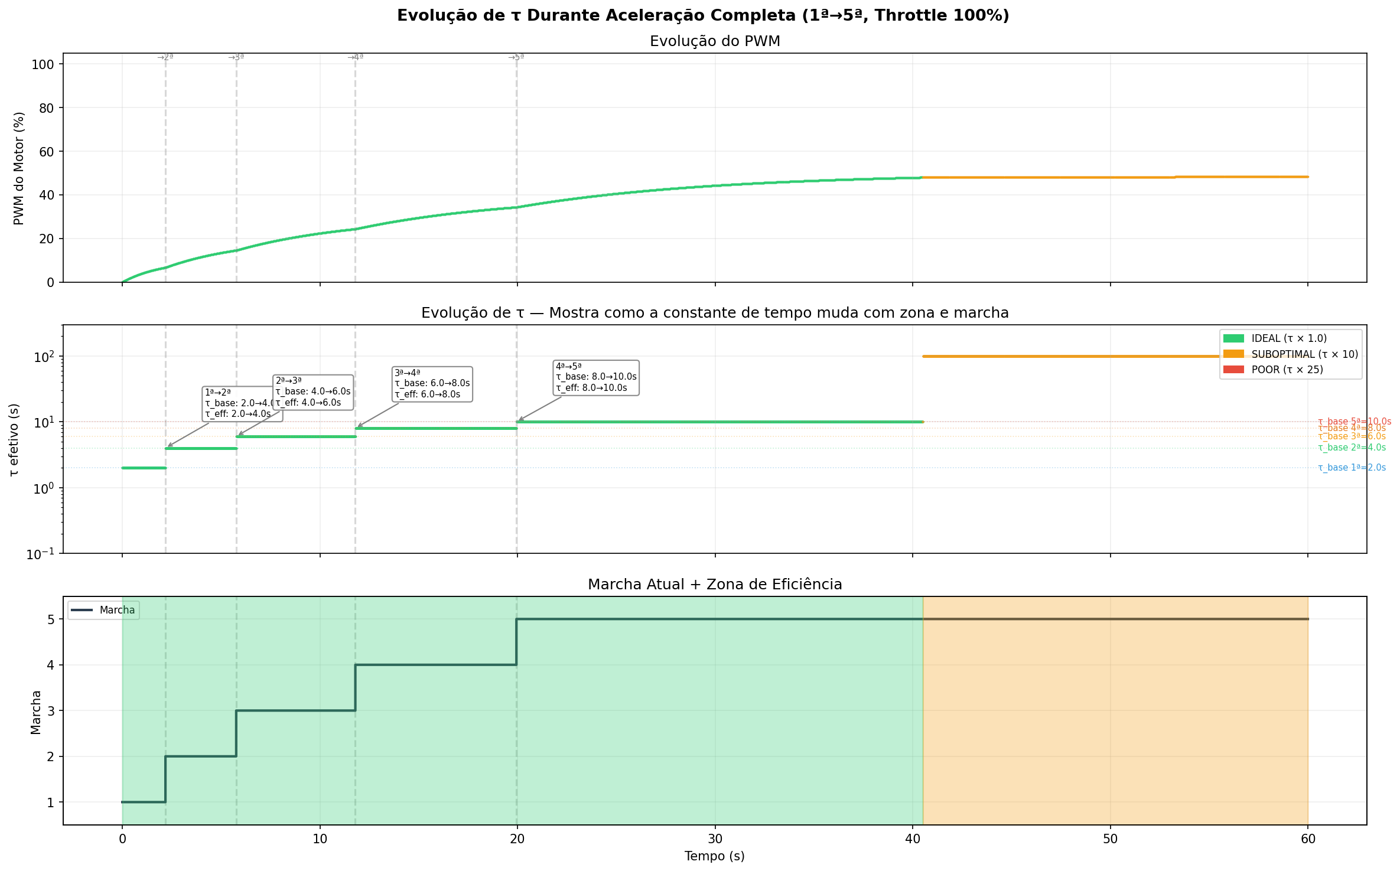
monografia/figuras/tau_evolucao_simulacao.png
