inacio-dev/tcc/raspberry/managers/camera.py

#!/usr/bin/env python3
"""
camera_manager.py - Gerenciamento da Câmera OV5647 com MJPEG Encoder

Usa encoder MJPEG para máxima fidelidade de imagem.
Cada frame é uma imagem JPEG independente (sem dependência entre frames).

PINOUT CÂMERA OV5647:
===================
Camera Module -> Raspberry Pi 4
- Conectar no slot CSI (Camera Serial Interface)
- Cabo flat de 15 pinos conectado na entrada "Camera" do RPi4
- Certifique-se que o cabo está com os contatos virados para baixo
- Execute 'sudo raspi-config' -> Interface Options -> Camera -> Enable

CONFIGURAÇÃO NECESSÁRIA:
=======================
1. sudo raspi-config
2. Interface Options -> Camera -> Enable
3. Reboot
4. Teste: libcamera-hello (comando de teste)

FORMATO DE SAÍDA:
================
- MJPEG (Motion JPEG)
- Cada frame é JPEG independente
- Qualidade: 85 (ajustável)
- Sem dependência entre frames (perda de 1 frame não afeta os outros)
"""

import io
import threading
import time
import traceback
from collections import deque

from managers.logger import debug, error, info, warn
from picamera2 import Picamera2
from picamera2.encoders import MJPEGEncoder
from picamera2.outputs import FileOutput


class CircularBuffer(io.BufferedIOBase):
    """Buffer circular para streaming MJPEG"""

    def __init__(self, max_frames=10):
        self.frames = deque(maxlen=max_frames)
        self.current_frame = io.BytesIO()
        self.lock = threading.Lock()
        self.frame_count = 0  # Contagem na janela de 1s (para FPS)
        self.total_bytes = 0
        self.total_frames_ever = 0
        self._fps_start_time = time.time()

    def write(self, data):
        """Recebe dados do encoder MJPEG"""
        with self.lock:
            # JPEG começa com SOI (Start of Image): 0xFFD8
            # JPEG termina com EOI (End of Image): 0xFFD9
            if len(data) >= 2 and data[:2] == b"\xff\xd8":
                # Novo frame JPEG iniciando - salva o anterior se existir
                if self.current_frame.tell() > 0:
                    frame_data = self.current_frame.getvalue()
                    if self._is_valid_jpeg(frame_data):
                        self.frames.append(
                            {
                                "data": frame_data,
                                "timestamp": time.time(),
                                "size": len(frame_data),
                                "keyframe": True,  # MJPEG: todo frame é independente
                            }
                        )
                        self.frame_count += 1
                        self.total_frames_ever += 1
                        self.total_bytes += len(frame_data)

                # Inicia novo frame
                self.current_frame = io.BytesIO()

            self.current_frame.write(data)
            return len(data)

    def _is_valid_jpeg(self, data):
        """Verifica se é um JPEG válido (tem SOI e EOI)"""
        if len(data) < 4:
            return False
        # Verifica SOI no início e EOI no final
        has_soi = data[:2] == b"\xff\xd8"
        has_eoi = data[-2:] == b"\xff\xd9"
        return has_soi and has_eoi

    def get_frame(self):
        """Obtém o frame mais recente"""
        with self.lock:
            if self.frames:
                return self.frames[-1]
            return None

    def flush(self):
        """Flush do buffer"""
        pass

    def readable(self):
        return False

    def writable(self):
        return True

    def seekable(self):
        return False


class CameraManager:
    """Gerencia a captura de vídeo da câmera OV5647 com MJPEG encoding"""

    # Presets de resolução
    RESOLUTION_PRESETS = {
        "480p": (640, 480),      # VGA - leve
        "720p": (1280, 720),     # HD - balanceado
        "1080p": (1920, 1080),   # Full HD - alta qualidade
    }

    def __init__(
        self,
        resolution=(640, 480),
        frame_rate=30,
        quality=85,
        sharpness=1.0,
        contrast=1.0,
        saturation=1.0,
        brightness=0.0,
        exposure_mode="auto",
    ):
        """
        Inicializa o gerenciador da câmera

        Args:
            resolution (tuple): Resolução do vídeo (largura, altura)
            frame_rate (int): Taxa de frames por segundo
            quality (int): Qualidade MJPEG 1-100 (padrão: 85)
            sharpness (float): Nitidez 0.0-2.0 (padrão: 1.0)
            contrast (float): Contraste 0.0-2.0 (padrão: 1.0)
            saturation (float): Saturação 0.0-2.0 (padrão: 1.0)
            brightness (float): Brilho -1.0 a 1.0 (padrão: 0.0)
            exposure_mode (str): Modo de exposição (auto, short, long)
        """
        self.resolution = resolution
        self.frame_rate = frame_rate
        self.quality = quality
        self.sharpness = sharpness
        self.contrast = contrast
        self.saturation = saturation
        self.brightness = brightness
        self.exposure_mode = exposure_mode

        self.camera = None
        self.encoder = None
        self.buffer = None
        self.output = None
        self.is_initialized = False
        self.is_recording = False

        # Estatísticas
        self.frames_captured = 0
        self.last_capture_time = time.time()
        self.last_frame_size = 0
        self.start_time = None

    def initialize(self):
        """
        Inicializa a câmera OV5647 com encoder MJPEG

        Returns:
            bool: True se inicializada com sucesso, False caso contrário
        """
        try:
            info("Inicializando câmera OV5647 com MJPEG encoder...", "CAMERA")

            # Verifica câmeras disponíveis ANTES de criar instância
            try:
                camera_info = Picamera2.global_camera_info()
                if camera_info:
                    for i, cam in enumerate(camera_info):
                        debug(f"  [{i}] {cam.get('Model', 'Desconhecida')}", "CAMERA")
                else:
                    error("Nenhuma câmera detectada! Execute: libcamera-hello --list-cameras", "CAMERA")
                    return False
            except Exception as e:
                warn(f"Erro ao listar câmeras: {e}", "CAMERA")

            # Cria instância da PiCamera2 com índice explícito
            self.camera = Picamera2(camera_num=0)

            # Configuração para encoding de vídeo MJPEG
            config = self.camera.create_video_configuration(
                main={"size": self.resolution, "format": "XBGR8888"},
                encode="main",  # IMPORTANTE: indica qual stream usar para o encoder
                buffer_count=4,
            )

            # Aplica configuração
            self.camera.configure(config)

            # Configura frame rate e controles de imagem
            try:
                frame_duration = 1000000 // self.frame_rate  # microssegundos
                controls = {
                    "FrameDurationLimits": (frame_duration, frame_duration),
                }

                # Controles de imagem (valores em escala libcamera)
                # Sharpness: 0.0 = sem nitidez, 1.0 = normal, 2.0+ = mais nítido
                if self.sharpness != 1.0:
                    controls["Sharpness"] = self.sharpness

                # Contrast: 0.0 = sem contraste, 1.0 = normal, 2.0 = alto contraste
                if self.contrast != 1.0:
                    controls["Contrast"] = self.contrast

                # Saturation: 0.0 = preto e branco, 1.0 = normal, 2.0 = cores vivas
                if self.saturation != 1.0:
                    controls["Saturation"] = self.saturation

                # Brightness: -1.0 a 1.0 (0.0 = normal)
                if self.brightness != 0.0:
                    controls["Brightness"] = self.brightness

                self.camera.set_controls(controls)
            except Exception as e:
                warn(f"Alguns controles não configurados: {e}", "CAMERA")

            # Cria encoder MJPEG (usa hardware do Raspberry Pi)
            # Qualidade controlada via parâmetro quality (1-100)
            # Nota: algumas versões usam 'q', outras 'quality'
            try:
                self.encoder = MJPEGEncoder(quality=self.quality)
            except TypeError:
                # Fallback para versões mais antigas
                self.encoder = MJPEGEncoder()

            # Cria buffer circular
            self.buffer = CircularBuffer(max_frames=10)

            # Cria output que escreve no buffer
            self.output = FileOutput(self.buffer)

            # Inicia câmera
            self.camera.start()
            time.sleep(0.5)

            # Inicia gravação com encoder MJPEG
            self.camera.start_encoder(self.encoder, self.output)
            self.is_recording = True
            self.start_time = time.time()

            self.is_initialized = True
            info(f"Câmera inicializada | {self.resolution[0]}x{self.resolution[1]} | MJPEG Q={self.quality} | {self.frame_rate}fps", "CAMERA")

            return True

        except IndexError as e:
            error(f"Erro ao detectar câmera: {e} | Verifique cabo e raspi-config -> Camera", "CAMERA")

            self.is_initialized = False
            return False

        except Exception as e:
            error(f"Erro ao inicializar câmera: {e}", "CAMERA")
            traceback.print_exc()

            self.is_initialized = False
            return False

    def capture_frame(self):
        """
        Obtém o frame JPEG mais recente do buffer

        Returns:
            bytes: Frame JPEG codificado, ou None se não disponível
        """
        if not self.is_initialized or self.buffer is None:
            return None

        try:
            frame_info = self.buffer.get_frame()

            if frame_info:
                self.frames_captured += 1
                self.last_capture_time = time.time()
                self.last_frame_size = frame_info["size"]
                return frame_info["data"]

            return None

        except Exception as e:
            warn(f"Erro ao obter frame: {e}", "CAMERA")
            return None

    def get_frame_with_metadata(self):
        """
        Obtém frame JPEG com metadados

        Returns:
            dict: {'data': bytes, 'keyframe': bool, 'timestamp': float, 'size': int}
        """
        if not self.is_initialized or self.buffer is None:
            return None

        try:
            frame_info = self.buffer.get_frame()

            if frame_info:
                self.frames_captured += 1
                self.last_capture_time = time.time()
                self.last_frame_size = frame_info["size"]
                return frame_info

            return None

        except Exception as e:
            warn(f"Erro ao obter frame: {e}", "CAMERA")
            return None

    def get_frame_size_info(self, frame_data):
        """
        Obtém informações sobre o tamanho do frame

        Args:
            frame_data (bytes): Dados do frame codificado

        Returns:
            dict: Informações do frame
        """
        if frame_data is None:
            return {"size_bytes": 0, "size_kb": 0.0}

        size_bytes = len(frame_data)
        size_kb = size_bytes / 1024.0

        return {"size_bytes": size_bytes, "size_kb": round(size_kb, 2)}


    def set_controls(self, sharpness=None, contrast=None, saturation=None, brightness=None):
        """
        Ajusta controles de imagem em tempo real

        Args:
            sharpness (float): Nitidez 0.0-2.0
            contrast (float): Contraste 0.0-2.0
            saturation (float): Saturação 0.0-2.0
            brightness (float): Brilho -1.0 a 1.0
        """
        if not self.is_initialized or self.camera is None:
            return False

        try:
            controls = {}

            if sharpness is not None:
                controls["Sharpness"] = sharpness
                self.sharpness = sharpness

            if contrast is not None:
                controls["Contrast"] = contrast
                self.contrast = contrast

            if saturation is not None:
                controls["Saturation"] = saturation
                self.saturation = saturation

            if brightness is not None:
                controls["Brightness"] = brightness
                self.brightness = brightness

            if controls:
                self.camera.set_controls(controls)
                return True

            return False

        except Exception as e:
            warn(f"Erro ao ajustar controles: {e}", "CAMERA")
            return False

    def set_resolution(self, resolution_name: str) -> bool:
        """
        Muda a resolução da câmera em tempo real.

        Reconfigura o pipeline picamera2 completo (stream + encoder + buffer).
        A câmera precisa ser parada e reconfigurada — não há mudança on-the-fly
        de resolução no picamera2.

        Args:
            resolution_name (str): "480p", "720p" ou "1080p"

        Returns:
            bool: True se mudança aplicada com sucesso
        """
        if resolution_name not in self.RESOLUTION_PRESETS:
            warn(f"Resolução desconhecida: {resolution_name}", "CAMERA")
            return False

        new_res = self.RESOLUTION_PRESETS[resolution_name]
        if new_res == self.resolution:
            info(f"Resolução já está em {resolution_name}", "CAMERA")
            return True

        if self.camera is None:
            warn("Câmera não inicializada — não é possível mudar resolução", "CAMERA")
            return False

        try:
            info(
                f"Mudando resolução: {self.resolution[0]}x{self.resolution[1]} → "
                f"{new_res[0]}x{new_res[1]}",
                "CAMERA",
            )

            # Bloqueia capture_frame() durante reconfiguração
            self.is_initialized = False

            # Para encoder e câmera
            if self.is_recording:
                self.camera.stop_encoder()
                self.is_recording = False
            self.camera.stop()

            # Reconfigura com nova resolução
            self.resolution = new_res
            config = self.camera.create_video_configuration(
                main={"size": self.resolution, "format": "XBGR8888"},
                encode="main",
                buffer_count=4,
            )
            self.camera.configure(config)

            # Reaplica frame rate e controles de imagem
            try:
                frame_duration = 1000000 // self.frame_rate
                controls = {
                    "FrameDurationLimits": (frame_duration, frame_duration),
                }
                if self.sharpness != 1.0:
                    controls["Sharpness"] = self.sharpness
                if self.contrast != 1.0:
                    controls["Contrast"] = self.contrast
                if self.saturation != 1.0:
                    controls["Saturation"] = self.saturation
                if self.brightness != 0.0:
                    controls["Brightness"] = self.brightness
                self.camera.set_controls(controls)
            except Exception as e:
                warn(f"Alguns controles não reaplicados após resize: {e}", "CAMERA")

            # Recria encoder (picamera2 exige encoder novo após stop)
            try:
                self.encoder = MJPEGEncoder(quality=self.quality)
            except TypeError:
                self.encoder = MJPEGEncoder()

            # Recria buffer circular e output
            self.buffer = CircularBuffer(max_frames=10)
            self.output = FileOutput(self.buffer)

            # Reinicia câmera e encoder
            self.camera.start()
            time.sleep(0.2)
            self.camera.start_encoder(self.encoder, self.output)
            self.is_recording = True

            self.is_initialized = True
            info(
                f"Resolução alterada: {resolution_name} "
                f"({new_res[0]}x{new_res[1]}) | MJPEG Q={self.quality} | {self.frame_rate}fps",
                "CAMERA",
            )
            return True

        except Exception as e:
            error(f"Erro ao mudar resolução: {e}", "CAMERA")
            self.is_initialized = False
            return False

    def cleanup(self):
        """Libera recursos da câmera e encoder"""
        try:
            if self.is_recording and self.camera:
                self.camera.stop_encoder()
                self.is_recording = False

            if self.camera is not None:
                self.camera.close()
                info("Câmera finalizada", "CAMERA")

            self.is_initialized = False
            self.camera = None
            self.encoder = None
            self.buffer = None
            self.output = None

        except Exception as e:
            warn(f"Erro ao finalizar câmera: {e}", "CAMERA")

    def __del__(self):
        """Destrutor - garante limpeza dos recursos"""
        self.cleanup()
