inacio-dev/tcc/raspberry/managers/network.py

#!/usr/bin/env python3
"""
network_manager.py - Gerenciamento de Comunicação UDP - VERSÃO CORRIGIDA
Responsável por transmitir vídeo + dados de sensores via UDP
CORREÇÃO: Agora suporta tipos numpy (bool_, float64, etc.)
CORREÇÃO: Suporta fragmentação automática para frames grandes (720p+)

CONFIGURAÇÃO DE REDE:
====================
1. Raspberry Pi e PC devem estar na mesma rede WiFi
2. Configurar IP estático no RPi (recomendado)
3. Abrir porta no firewall se necessário

ESTRUTURA DO PACOTE UDP (normal):
================================
| 4 bytes    | 4 bytes     | N bytes    | M bytes      |
| frame_size | sensor_size | frame_data | sensor_data  |

ESTRUTURA DO PACOTE UDP (fragmentado):
=====================================
| 4 bytes | 4 bytes  | 2 bytes     | 2 bytes      | N bytes    |
| 0xFRAG  | frame_id | chunk_index | total_chunks | chunk_data |

PORTAS UTILIZADAS:
=================
- 9999: Transmissão de vídeo + sensores (RPi -> PC)
- 9998: Comandos de controle (PC -> RPi) [futuro]
"""

import json
import socket
import struct
import threading
import time
from typing import Any, Dict, Optional

import subprocess

import numpy as np

from managers.logger import debug, error, info, warn


class NetworkManager:
    """Gerencia comunicação UDP bidirecional para transmissão de dados"""

    # Constantes de fragmentação
    FRAG_MAGIC = 0x46524147  # "FRAG" em ASCII hex
    MAX_PACKET_SIZE = 60000  # Tamanho máximo seguro para UDP (< 65507)
    FRAG_HEADER_SIZE = 12    # 4 (magic) + 4 (frame_id) + 2 (chunk_idx) + 2 (total_chunks)

    def __init__(
        self,
        video_port: int = 9999,  # Porta para enviar vídeo (RPi -> Cliente)
        sensor_port: int = 9997,  # Porta para enviar sensores (RPi -> Cliente)
        command_port: int = 9998,  # Porta para receber comandos (Cliente -> RPi)
        buffer_size: int = 131072,
    ):
        """
        Inicializa o gerenciador de rede bidirecional

        Args:
            video_port (int): Porta para envio de vídeo aos clientes
            sensor_port (int): Porta para envio de sensores aos clientes
            command_port (int): Porta para escutar comandos dos clientes
            buffer_size (int): Tamanho do buffer UDP em bytes
        """
        self.video_port = video_port
        self.sensor_port = sensor_port
        self.data_port = video_port  # Compatibilidade (usado em send_packet)
        self.command_port = command_port
        self.buffer_size = buffer_size

        # Sockets UDP
        self.send_socket = None  # Para enviar vídeo
        self.sensor_socket = None  # Para enviar sensores
        self.receive_socket = None  # Para receber comandos
        self.is_initialized = False

        # Clientes conectados (descoberta automática)
        self.connected_clients = {}  # {ip: {'port': port, 'last_seen': timestamp}}
        self.clients_lock = threading.Lock()

        # Estatísticas de transmissão
        self.packets_sent = 0
        self.bytes_sent = 0
        self.commands_received = 0
        self.last_send_time = time.time()
        self.start_time = time.time()

        # Controle de erro
        self.send_errors = 0
        self.last_error_time = 0
        self.last_error_log = 0

        # Contador de frames para fragmentação
        self.frame_id_counter = 0

        # Threading para recepção de comandos
        self.command_thread = None
        self.should_stop = False

        # Callback para processar comandos recebidos
        self.command_callback = None

    def initialize(self) -> bool:
        """
        Inicializa a comunicação UDP bidirecional

        Returns:
            bool: True se inicializado com sucesso
        """
        try:
            info("Inicializando comunicação UDP bidirecional...", "NET")
            debug(
                f"Portas: vídeo={self.video_port}, sensores={self.sensor_port}, comandos={self.command_port}",
                "NET",
            )

            # Socket para envio de vídeo (porta 9999)
            self.send_socket = socket.socket(socket.AF_INET, socket.SOCK_DGRAM)
            self.send_socket.setsockopt(socket.SOL_SOCKET, socket.SO_SNDBUF, 65536)
            self.send_socket.setsockopt(socket.SOL_SOCKET, socket.SO_REUSEADDR, 1)
            try:
                self.send_socket.setsockopt(
                    socket.IPPROTO_IP, socket.IP_TOS, 0x10
                )  # IPTOS_LOWDELAY
            except (AttributeError, OSError):
                pass

            # Socket para envio de sensores (porta 9997)
            self.sensor_socket = socket.socket(socket.AF_INET, socket.SOCK_DGRAM)
            self.sensor_socket.setsockopt(socket.SOL_SOCKET, socket.SO_SNDBUF, 32768)
            self.sensor_socket.setsockopt(socket.SOL_SOCKET, socket.SO_REUSEADDR, 1)

            # Cria socket para receber comandos
            self.receive_socket = socket.socket(socket.AF_INET, socket.SOCK_DGRAM)
            try:
                self.receive_socket.setsockopt(
                    socket.SOL_SOCKET, socket.SO_RCVBUF, self.buffer_size
                )
                self.receive_socket.bind(("", self.command_port))
                self.receive_socket.settimeout(1.0)
            except Exception:
                self.receive_socket.close()
                self.receive_socket = None
                raise

            debug("Sockets criados com sucesso (dados + comandos)", "NET")

            # Inicia thread para escutar comandos
            self._start_command_listener()

            self.is_initialized = True
            info("Comunicação UDP inicializada - Aguardando clientes...", "NET")

            return True

        except Exception as e:
            error(f"Erro ao inicializar UDP: {e}", "NET")
            error("Verifique rede WiFi e firewall", "NET")

            self.is_initialized = False
            return False

    def _start_command_listener(self):
        """Inicia thread para escutar comandos dos clientes"""
        if self.command_thread is None or not self.command_thread.is_alive():
            self.should_stop = False
            self.command_thread = threading.Thread(
                target=self._command_listener_loop, daemon=True
            )
            self.command_thread.start()
            debug("Thread de escuta iniciada", "NET")

    def _command_listener_loop(self):
        """Loop principal para escutar comandos dos clientes"""
        debug("Iniciando escuta de comandos", "NET")

        while not self.should_stop:
            try:
                # Recebe dados de qualquer cliente
                data, addr = self.receive_socket.recvfrom(self.buffer_size)
                client_ip, client_port = addr
                debug(f"Comando recebido de {client_ip}:{client_port}: {data}", "NET", rate_limit=1.0)

                # Processa o comando recebido
                self._process_client_command(data, client_ip, client_port)

            except socket.timeout:
                # Timeout normal - continua o loop
                continue
            except Exception as e:
                if not self.should_stop:
                    warn(f"Erro ao receber comando: {e}", "NET", rate_limit=5.0)
                    time.sleep(0.1)

        debug("Thread de escuta finalizada", "NET")

    def _process_client_command(self, data: bytes, client_ip: str, client_port: int):
        """
        Processa comando recebido de um cliente

        Args:
            data: Dados recebidos
            client_ip: IP do cliente
            client_port: Porta do cliente
        """
        try:
            # Decodifica comando
            command_str = data.decode("utf-8").strip()
            self.commands_received += 1

            current_time = time.time()

            # Processa diferentes tipos de comando
            if command_str.startswith("CONNECT"):
                # CONNECT ou CONNECT:porta
                if ":" in command_str:
                    _, listen_port = command_str.split(":", 1)
                    self._handle_client_connect(client_ip, int(listen_port))
                else:
                    self._handle_client_connect(
                        client_ip, self.data_port
                    )  # Porta padrão

            elif command_str == "DISCONNECT":
                self._handle_client_disconnect(client_ip)

            elif command_str.startswith("PING"):
                self._handle_client_ping(client_ip, client_port, command_str)

            elif command_str.startswith("CONTROL:"):
                # Comando de controle (motor, freio, direção)
                self._handle_control_command(client_ip, command_str[8:])

            else:
                # Comando personalizado - repassa para callback se existir
                if self.command_callback:
                    self.command_callback(client_ip, command_str)

            # Atualiza última vez que vimos este cliente
            with self.clients_lock:
                if client_ip in self.connected_clients:
                    self.connected_clients[client_ip]["last_seen"] = current_time

        except Exception as e:
            warn(
                f"Erro ao processar comando de {client_ip}: {e}", "NET", rate_limit=5.0
            )

    def _handle_client_connect(self, client_ip: str, listen_port: int):
        """
        Processa conexão de um novo cliente

        Args:
            client_ip: IP do cliente
            listen_port: Porta onde o cliente está escutando dados
        """
        with self.clients_lock:
            if client_ip not in self.connected_clients:
                # Novo cliente
                self.connected_clients[client_ip] = {
                    "port": listen_port,  # Porta onde cliente escuta dados
                    "last_seen": time.time(),
                }
                info(f"Novo cliente conectado: {client_ip}", "NET")
                debug(
                    f"Total clientes conectados: {len(self.connected_clients)}", "NET"
                )
                debug(
                    f"Lista de clientes: {list(self.connected_clients.keys())}", "NET"
                )

                # Envia confirmação de conexão
                self._send_to_client(client_ip, b"CONNECTED")

            else:
                # Cliente reconectando
                self.connected_clients[client_ip]["last_seen"] = time.time()
                debug(f"Cliente reconectado: {client_ip}", "NET")
                self._send_to_client(client_ip, b"RECONNECTED")

    def _handle_client_disconnect(self, client_ip: str):
        """Processa desconexão de um cliente"""
        with self.clients_lock:
            if client_ip in self.connected_clients:
                del self.connected_clients[client_ip]
                info(f"Cliente desconectado: {client_ip}", "NET")

    def _handle_client_ping(self, client_ip: str, client_port: int, ping_data: str):
        """Responde ao ping do cliente"""
        # Extrai timestamp se enviado
        parts = ping_data.split(":")
        if len(parts) > 1:
            timestamp = parts[1]
            pong_response = f"PONG:{timestamp}".encode("utf-8")
        else:
            pong_response = b"PONG"

        self._send_to_client(client_ip, pong_response)

    def _handle_control_command(self, client_ip: str, command: str):
        """Processa comando de controle do veículo"""
        debug(f"Comando de {client_ip}: {command}", "NET", rate_limit=1.0)

        # Aqui você pode processar comandos como:
        # "THROTTLE:50" -> acelerar 50%
        # "BRAKE:30" -> frear 30%
        # "STEERING:-20" -> virar esquerda 20°
        # etc.

        # Por enquanto só loga - implementação específica fica para depois
        if self.command_callback:
            self.command_callback(client_ip, f"CONTROL:{command}")

    def _send_to_client(self, client_ip: str, data: bytes):
        """Envia dados para um cliente específico"""
        with self.clients_lock:
            self._send_to_client_unlocked(client_ip, data)

    def _send_to_client_unlocked(self, client_ip: str, data: bytes):
        """Envia dados para um cliente (caller deve segurar clients_lock)"""
        if client_ip in self.connected_clients:
            client_port = self.connected_clients[client_ip]["port"]
            try:
                self.send_socket.sendto(data, (client_ip, client_port))
            except Exception as e:
                warn(f"Erro ao enviar para {client_ip}: {e}", "NET", rate_limit=5.0)

    def get_connected_clients(self) -> list:
        """Retorna lista de clientes conectados"""
        with self.clients_lock:
            return list(self.connected_clients.keys())

    def has_connected_clients(self) -> bool:
        """Verifica se há clientes conectados"""
        with self.clients_lock:
            return len(self.connected_clients) > 0

    def set_command_callback(self, callback):
        """Define callback para processar comandos personalizados"""
        self.command_callback = callback

    def _resolve_hostname(self, hostname: str) -> str:
        """Resolve hostname para IP numérico (evita mDNS em cada sendto)"""
        try:
            resolved = socket.gethostbyname(hostname)
            info(f"Resolvido: {hostname} -> {resolved}", "NET")
            return resolved
        except socket.gaierror:
            warn(f"Falha ao resolver {hostname}, usando hostname direto", "NET")
            return hostname

    def set_fixed_client(self, client_ip: str, client_port: int):
        """Define cliente fixo para modo direto (sem descoberta)"""
        resolved_ip = self._resolve_hostname(client_ip)
        with self.clients_lock:
            self.connected_clients[resolved_ip] = {
                "port": client_port,
                "last_seen": time.time(),
            }
            info(f"Cliente fixo configurado: {resolved_ip}:{client_port}", "NET")
            debug(f"Total clientes: {len(self.connected_clients)}", "NET")

    def send_connect_to_client(self, client_ip: str, client_port: int = None):
        """
        Envia comando CONNECT ativo para um cliente específico.
        Re-resolve hostname e atualiza IP em connected_clients.

        Args:
            client_ip (str): IP ou hostname do cliente
            client_port (int): Porta do cliente (opcional, usa 9998 se não especificado)
        """
        try:
            if client_port is None:
                client_port = 9998

            # Re-resolve hostname (atualiza IP se DHCP mudou)
            resolved_ip = self._resolve_hostname(client_ip)

            connect_cmd = f"SERVER_CONNECT:{self.data_port}"
            self.send_socket.sendto(
                connect_cmd.encode("utf-8"), (resolved_ip, client_port)
            )

            debug(f"CONNECT enviado para {resolved_ip}:{client_port}", "NET")

            # Atualiza IP resolvido em connected_clients
            with self.clients_lock:
                # Remove hostname antigo se existir
                if client_ip != resolved_ip and client_ip in self.connected_clients:
                    del self.connected_clients[client_ip]

                if resolved_ip not in self.connected_clients:
                    self.connected_clients[resolved_ip] = {
                        "port": self.data_port,
                        "last_seen": time.time(),
                        "auto_connect": True,
                    }
                else:
                    self.connected_clients[resolved_ip]["last_seen"] = time.time()

        except Exception as e:
            warn(f"Erro ao enviar CONNECT para {client_ip}:{client_port}: {e}", "NET")

    def _convert_numpy_types(self, obj):
        """
        Converte tipos numpy para tipos Python nativos recursivamente

        Args:
            obj: Objeto que pode conter tipos numpy

        Returns:
            Objeto com tipos Python nativos
        """
        if isinstance(obj, np.bool_):
            return bool(obj)
        elif isinstance(obj, np.integer):
            return int(obj)
        elif isinstance(obj, np.floating):
            return float(obj)
        elif isinstance(obj, np.ndarray):
            return obj.tolist()
        elif isinstance(obj, dict):
            return {key: self._convert_numpy_types(value) for key, value in obj.items()}
        elif isinstance(obj, list):
            return [self._convert_numpy_types(item) for item in obj]
        elif isinstance(obj, tuple):
            return tuple(self._convert_numpy_types(item) for item in obj)
        else:
            # Para outros tipos (incluindo tipos numpy que não foram capturados)
            if hasattr(obj, "dtype"):
                try:
                    return obj.item()  # Converte scalar numpy para Python nativo
                except Exception:
                    return str(obj)  # Fallback para string
            return obj

    def create_packet(self, frame_data: bytes, sensor_data: Dict[Any, Any]) -> bytes:
        """
        Cria pacote UDP estruturado

        Args:
            frame_data (bytes): Dados do frame de vídeo
            sensor_data (dict): Dados dos sensores

        Returns:
            bytes: Pacote UDP completo
        """
        try:
            # Converte tipos numpy para tipos Python nativos
            cleaned_sensor_data = self._convert_numpy_types(sensor_data)

            # Serializa dados dos sensores para JSON
            sensor_json = json.dumps(cleaned_sensor_data, ensure_ascii=False)
            sensor_bytes = sensor_json.encode("utf-8")

            # Tamanhos
            frame_size = len(frame_data) if frame_data else 0
            sensor_size = len(sensor_bytes)

            # Monta pacote:
            # 4 bytes: tamanho do frame (little-endian unsigned int)
            # 4 bytes: tamanho dos dados do sensor
            # N bytes: dados do frame
            # M bytes: dados do sensor (JSON)
            packet = (
                struct.pack("<I", frame_size)  # Frame size
                + struct.pack("<I", sensor_size)  # Sensor size
                + (frame_data if frame_data else b"")  # Frame data
                + sensor_bytes  # Sensor data
            )

            return packet

        except Exception as e:
            # Log erro detalhado apenas a cada 5 segundos
            current_time = time.time()
            if current_time - self.last_error_log > 5.0:
                warn(f"Erro ao criar pacote: {e}", "NET")

                # Debug adicional para identificar tipos problemáticos
                if sensor_data:
                    debug("Tipos problemáticos nos dados:", "NET")
                    for key, value in sensor_data.items():
                        if hasattr(value, "dtype") or type(value).__module__ == "numpy":
                            debug(f"  {key}: {type(value)} = {value}", "NET")

                self.last_error_log = current_time

            return b""

    def send_packet(self, packet_data: bytes) -> bool:
        """
        Envia pacote UDP para todos os clientes conectados.
        Fragmenta automaticamente se o pacote for maior que MAX_PACKET_SIZE.

        Args:
            packet_data (bytes): Dados do pacote para envio

        Returns:
            bool: True se enviado para pelo menos um cliente
        """
        if not self.is_initialized or not self.send_socket:
            return False

        # Só envia se houver clientes conectados
        if not self.has_connected_clients():
            return False

        # Verifica se precisa fragmentar
        if len(packet_data) > self.MAX_PACKET_SIZE:
            return self._send_fragmented(packet_data)
        else:
            return self._send_single_packet(packet_data)

    def _send_single_packet(self, packet_data: bytes) -> bool:
        """Envia um único pacote (sem fragmentação)"""
        success_count = 0

        with self.clients_lock:
            for client_ip, client_info in self.connected_clients.items():
                try:
                    self.send_socket.sendto(
                        packet_data, (client_ip, client_info["port"])
                    )
                    success_count += 1
                except Exception as e:
                    warn(f"Erro ao enviar para {client_ip}: {e}", "NET", rate_limit=5.0)

        if success_count > 0:
            self.packets_sent += 1
            self.bytes_sent += len(packet_data)
            self.last_send_time = time.time()
            return True
        else:
            self.send_errors += 1
            return False

    def _send_fragmented(self, packet_data: bytes) -> bool:
        """
        Envia pacote fragmentado para todos os clientes.

        Estrutura do fragmento:
        | 4 bytes    | 4 bytes  | 2 bytes     | 2 bytes      | N bytes    |
        | FRAG_MAGIC | frame_id | chunk_index | total_chunks | chunk_data |
        """
        # Incrementa contador de frame
        self.frame_id_counter = (self.frame_id_counter + 1) & 0xFFFFFFFF
        frame_id = self.frame_id_counter

        # Calcula tamanho do chunk (dados úteis por fragmento)
        chunk_size = self.MAX_PACKET_SIZE - self.FRAG_HEADER_SIZE
        total_chunks = (len(packet_data) + chunk_size - 1) // chunk_size

        success_count = 0
        total_bytes = 0

        with self.clients_lock:
            for client_ip, client_info in self.connected_clients.items():
                client_success = True

                for chunk_idx in range(total_chunks):
                    # Extrai chunk de dados
                    start = chunk_idx * chunk_size
                    end = min(start + chunk_size, len(packet_data))
                    chunk_data = packet_data[start:end]

                    # Monta cabeçalho do fragmento
                    # I = unsigned int (4 bytes), H = unsigned short (2 bytes)
                    header = struct.pack(
                        "<IIHH",
                        self.FRAG_MAGIC,
                        frame_id,
                        chunk_idx,
                        total_chunks
                    )

                    fragment = header + chunk_data

                    try:
                        self.send_socket.sendto(
                            fragment, (client_ip, client_info["port"])
                        )
                        total_bytes += len(fragment)
                    except Exception as e:
                        warn(f"Erro ao enviar fragmento {chunk_idx}/{total_chunks} para {client_ip}: {e}", "NET", rate_limit=5.0)
                        client_success = False
                        break

                if client_success:
                    success_count += 1

        if success_count > 0:
            self.packets_sent += total_chunks
            self.bytes_sent += total_bytes
            self.last_send_time = time.time()
            return True
        else:
            self.send_errors += 1
            return False

    def send_video_frame(self, frame_data: Optional[bytes]) -> bool:
        """
        Envia frame de vídeo (porta 9999).

        Args:
            frame_data (bytes): Dados do frame MJPEG

        Returns:
            bool: True se enviado com sucesso
        """
        if not frame_data:
            return False

        # Pacote simples: 4 bytes tamanho + dados do frame
        packet = struct.pack("<I", len(frame_data)) + frame_data

        t0 = time.monotonic()
        if len(packet) > self.MAX_PACKET_SIZE:
            result = self._send_fragmented(packet)
        else:
            result = self._send_single_packet(packet)
        t_send = time.monotonic() - t0

        if t_send > 0.020:
            warn(
                f"[DIAG] VIDEO SEND: {t_send*1000:.0f}ms, size={len(packet)}B",
                "DIAG",
            )

        return result

    def send_sensor_data(self, sensor_data: Dict[Any, Any]) -> bool:
        """
        Envia dados de sensores consolidados (porta 9997).

        Args:
            sensor_data (dict): Dados dos sensores

        Returns:
            bool: True se enviado com sucesso
        """
        if not self.is_initialized or not self.sensor_socket:
            return False
        if not self.has_connected_clients():
            return False

        try:
            t_serial_start = time.monotonic()
            cleaned = self._convert_numpy_types(sensor_data)
            sensor_json = json.dumps(cleaned, ensure_ascii=False)
            sensor_bytes = sensor_json.encode("utf-8")
            t_serial = time.monotonic() - t_serial_start

            success_count = 0
            t_sendto_start = time.monotonic()
            with self.clients_lock:
                for client_ip, client_info in self.connected_clients.items():
                    try:
                        self.sensor_socket.sendto(
                            sensor_bytes, (client_ip, self.sensor_port)
                        )
                        success_count += 1
                    except Exception:
                        pass
            t_sendto = time.monotonic() - t_sendto_start

            if t_serial > 0.050 or t_sendto > 0.050:
                warn(
                    f"[DIAG] SENSOR SEND: serial={t_serial*1000:.0f}ms, "
                    f"sendto={t_sendto*1000:.0f}ms, size={len(sensor_bytes)}B",
                    "DIAG",
                )

            if success_count > 0:
                self.packets_sent += 1
                self.bytes_sent += len(sensor_bytes)
                return True
            return False

        except Exception as e:
            current_time = time.time()
            if current_time - self.last_error_log > 5.0:
                warn(f"Erro ao enviar sensores: {e}", "NET")
                self.last_error_log = current_time
            return False

    def send_frame_with_sensors(
        self, frame_data: Optional[bytes], sensor_data: Dict[Any, Any]
    ) -> bool:
        """Compatibilidade — envia vídeo + sensores separadamente"""
        v = self.send_video_frame(frame_data)
        s = self.send_sensor_data(sensor_data)
        return v or s

    def send_termination_signal(self) -> bool:
        """
        Envia sinal de terminação (tamanhos zero)

        Returns:
            bool: True se enviado com sucesso
        """
        try:
            termination_packet = struct.pack("<I", 0) + struct.pack("<I", 0)
            return self.send_packet(termination_packet)
        except Exception:
            return False

    def get_transmission_stats(self) -> Dict[str, Any]:
        """
        Obtém estatísticas de transmissão

        Returns:
            dict: Estatísticas de rede
        """
        elapsed = time.time() - self.start_time

        # Calcula taxas
        packets_per_second = self.packets_sent / elapsed if elapsed > 0 else 0
        bytes_per_second = self.bytes_sent / elapsed if elapsed > 0 else 0
        mbps = (bytes_per_second * 8) / (1024 * 1024)  # Megabits por segundo

        return {
            "packets_sent": self.packets_sent,
            "bytes_sent": self.bytes_sent,
            "send_errors": self.send_errors,
            "elapsed_time": round(elapsed, 2),
            "packets_per_second": round(packets_per_second, 2),
            "bytes_per_second": round(bytes_per_second, 2),
            "mbps": round(mbps, 3),
            "is_connected": self.has_connected_clients(),
            "target": (
                f"auto-discovery:{self.data_port}"
                if not hasattr(self, "target_ip")
                else f"{self.target_ip}:{self.target_port}"
            ),
            "last_send_time": self.last_send_time,
        }

    def cleanup(self):
        """Libera recursos de rede"""
        try:
            info("Parando comunicação UDP...", "NET")

            # Para thread de escuta de comandos
            self.should_stop = True
            if self.command_thread and self.command_thread.is_alive():
                self.command_thread.join(timeout=2.0)

            # Notifica clientes sobre desconexão
            if self.has_connected_clients():
                debug("Notificando clientes sobre desconexão", "NET")
                with self.clients_lock:
                    for client_ip in list(self.connected_clients.keys()):
                        self._send_to_client_unlocked(client_ip, b"SERVER_DISCONNECT")

            # Envia sinal de terminação
            if self.is_initialized:
                self.send_termination_signal()

            # Fecha sockets
            if self.send_socket:
                self.send_socket.close()

            if self.sensor_socket:
                self.sensor_socket.close()

            if self.receive_socket:
                self.receive_socket.close()

            self.is_initialized = False
            self.connected_clients.clear()
            info("Comunicação UDP finalizada", "NET")

        except Exception as e:
            warn(f"Erro ao finalizar conexão: {e}", "NET")

    def __del__(self):
        """Destrutor - garante limpeza dos recursos"""
        self.cleanup()
