inacio-dev/tcc/scripts/analyze_session.py

#!/usr/bin/env python3
"""
analyze_session.py - Analisador de Sessões F1 Car

Analisa dados salvos pelo auto-save:
- sensors_*.pkl - Dados brutos dos sensores BMI160
- telemetry_*.pkl - Dados dos gráficos de telemetria
- logs_*.txt - Logs do console

Uso:
    python analyze_session.py                     # Analisa arquivos mais recentes
    python analyze_session.py --dir exports/auto  # Especifica diretório
    python analyze_session.py --file telemetry_20241217_143000.pkl  # Arquivo específico
    python analyze_session.py --all               # Analisa todos os arquivos
    python analyze_session.py --export report.html  # Exporta relatório HTML

Autor: F1 Car TCC Project
"""

import argparse
import os
import pickle
import re
import sys
from dataclasses import dataclass
from datetime import datetime
from pathlib import Path
from typing import Dict, Optional, Tuple

# Adiciona diretório pai ao path para imports
sys.path.insert(0, str(Path(__file__).parent.parent))

try:
    import numpy as np

    NUMPY_AVAILABLE = True
except ImportError:
    NUMPY_AVAILABLE = False
    print("[WARN] NumPy não instalado. Estatísticas limitadas.")

try:
    import matplotlib.pyplot as plt
    from matplotlib.gridspec import GridSpec

    MATPLOTLIB_AVAILABLE = True
except ImportError:
    MATPLOTLIB_AVAILABLE = False
    print("[WARN] Matplotlib não instalado. Gráficos desabilitados.")


# Cores estilo F1
COLORS = {
    "speed": "#00D2BE",
    "throttle": "#00FF00",
    "brake": "#FF0000",
    "g_lateral": "#FF8700",
    "g_frontal": "#0090FF",
    "accel_x": "#FF5555",
    "accel_y": "#55FF55",
    "accel_z": "#5555FF",
    "gyro_x": "#FFAA00",
    "gyro_y": "#00FFAA",
    "gyro_z": "#AA00FF",
    "background": "#1E1E1E",
    "grid": "#3C3C3C",
    "text": "#FFFFFF",
}


@dataclass
class SessionStats:
    """Estatísticas de uma sessão"""

    duration_seconds: float = 0.0
    total_points: int = 0

    # Velocidade
    speed_max: float = 0.0
    speed_avg: float = 0.0
    speed_min: float = 0.0

    # Pedais
    throttle_avg: float = 0.0
    brake_avg: float = 0.0
    full_throttle_percent: float = 0.0
    braking_percent: float = 0.0

    # G-Forces
    g_lateral_max: float = 0.0
    g_lateral_min: float = 0.0
    g_frontal_max: float = 0.0
    g_frontal_min: float = 0.0

    # Aceleração
    accel_x_max: float = 0.0
    accel_y_max: float = 0.0
    accel_z_max: float = 0.0

    # Giroscópio
    gyro_z_max: float = 0.0  # Rotação máxima (curvas)

    # Power Monitor
    current_motor_max: float = 0.0
    current_motor_avg: float = 0.0
    power_total_max: float = 0.0
    power_total_avg: float = 0.0
    voltage_rpi_avg: float = 0.0


class SessionAnalyzer:
    """Analisador de sessões do F1 Car"""

    def __init__(self, data_dir: str = "exports/auto"):
        self.data_dir = Path(data_dir)
        self.telemetry_data: Optional[Dict] = None
        self.sensor_data: Optional[Dict] = None
        self.log_content: Optional[str] = None
        self.stats = SessionStats()

    def find_latest_files(
        self,
    ) -> Tuple[Optional[Path], Optional[Path], Optional[Path]]:
        """Encontra os arquivos mais recentes de cada tipo"""
        telemetry_files = sorted(self.data_dir.glob("telemetry_*.pkl"), reverse=True)
        sensor_files = sorted(self.data_dir.glob("sensors_*.pkl"), reverse=True)
        log_files = sorted(self.data_dir.glob("logs_*.txt"), reverse=True)

        return (
            telemetry_files[0] if telemetry_files else None,
            sensor_files[0] if sensor_files else None,
            log_files[0] if log_files else None,
        )

    def find_matching_files(
        self, timestamp: str
    ) -> Tuple[Optional[Path], Optional[Path], Optional[Path]]:
        """Encontra arquivos com o mesmo timestamp"""
        telemetry = self.data_dir / f"telemetry_{timestamp}.pkl"
        sensors = self.data_dir / f"sensors_{timestamp}.pkl"
        logs = self.data_dir / f"logs_{timestamp}.txt"

        return (
            telemetry if telemetry.exists() else None,
            sensors if sensors.exists() else None,
            logs if logs.exists() else None,
        )

    def load_telemetry(self, filepath: Path) -> bool:
        """Carrega dados de telemetria"""
        try:
            with open(filepath, "rb") as f:
                self.telemetry_data = pickle.load(f)
            print(f"[OK] Telemetria carregada: {filepath.name}")
            print(
                f"     Pontos: {self.telemetry_data.get('points_count', len(self.telemetry_data.get('time', [])))}"
            )
            return True
        except Exception as e:
            print(f"[ERRO] Falha ao carregar telemetria: {e}")
            return False

    def load_sensors(self, filepath: Path) -> bool:
        """Carrega dados de sensores"""
        try:
            with open(filepath, "rb") as f:
                self.sensor_data = pickle.load(f)
            print(f"[OK] Sensores carregados: {filepath.name}")

            # Conta pontos
            if "timestamp" in self.sensor_data:
                print(f"     Pontos: {len(self.sensor_data['timestamp'])}")
            return True
        except Exception as e:
            print(f"[ERRO] Falha ao carregar sensores: {e}")
            return False

    def load_logs(self, filepath: Path) -> bool:
        """Carrega arquivo de logs"""
        try:
            with open(filepath, "r", encoding="utf-8") as f:
                self.log_content = f.read()
            lines = self.log_content.count("\n")
            print(f"[OK] Logs carregados: {filepath.name}")
            print(f"     Linhas: {lines}")
            return True
        except Exception as e:
            print(f"[ERRO] Falha ao carregar logs: {e}")
            return False

    def load_all_files(self) -> Tuple[int, int, int]:
        """
        Carrega e combina TODOS os arquivos da pasta exports

        Returns:
            Tuple com contagem de arquivos carregados (telemetry, sensors, logs)
        """
        telemetry_count = self._load_all_telemetry()
        sensor_count = self._load_all_sensors()
        log_count = self._load_all_logs()

        return telemetry_count, sensor_count, log_count

    def _load_all_telemetry(self) -> int:
        """Carrega e combina todos os arquivos de telemetria"""
        telemetry_files = sorted(self.data_dir.glob("telemetry_*.pkl"))

        if not telemetry_files:
            print("[INFO] Nenhum arquivo de telemetria encontrado")
            return 0

        print(f"\n--- Carregando {len(telemetry_files)} arquivos de telemetria ---")

        combined_data = {}
        total_points = 0

        for filepath in telemetry_files:
            try:
                with open(filepath, "rb") as f:
                    data = pickle.load(f)

                # Combina os dados
                for key, values in data.items():
                    if key in [
                        "start_time",
                        "max_points",
                        "export_time",
                        "points_count",
                    ]:
                        continue  # Pula metadados

                    if isinstance(values, list):
                        if key not in combined_data:
                            combined_data[key] = []
                        combined_data[key].extend(values)

                points = data.get("points_count", len(data.get("time", [])))
                total_points += points
                print(f"  [+] {filepath.name}: {points} pontos")

            except Exception as e:
                print(f"  [!] Erro em {filepath.name}: {e}")

        if combined_data:
            self.telemetry_data = combined_data
            self.telemetry_data["points_count"] = total_points
            print(
                f"[OK] Total telemetria: {total_points} pontos de {len(telemetry_files)} arquivos"
            )

        return len(telemetry_files)

    def _load_all_sensors(self) -> int:
        """Carrega e combina todos os arquivos de sensores"""
        sensor_files = sorted(self.data_dir.glob("sensors_*.pkl"))

        if not sensor_files:
            print("[INFO] Nenhum arquivo de sensores encontrado")
            return 0

        print(f"\n--- Carregando {len(sensor_files)} arquivos de sensores ---")

        combined_data = {}
        total_points = 0

        for filepath in sensor_files:
            try:
                with open(filepath, "rb") as f:
                    data = pickle.load(f)

                # Combina os dados
                for key, values in data.items():
                    if isinstance(values, (list, tuple)):
                        if key not in combined_data:
                            combined_data[key] = []
                        combined_data[key].extend(list(values))

                points = len(data.get("timestamp", []))
                total_points += points
                print(f"  [+] {filepath.name}: {points} pontos")

            except Exception as e:
                print(f"  [!] Erro em {filepath.name}: {e}")

        if combined_data:
            self.sensor_data = combined_data
            print(
                f"[OK] Total sensores: {total_points} pontos de {len(sensor_files)} arquivos"
            )

        return len(sensor_files)

    def _load_all_logs(self) -> int:
        """Carrega e concatena todos os arquivos de logs"""
        log_files = sorted(self.data_dir.glob("logs_*.txt"))

        if not log_files:
            print("[INFO] Nenhum arquivo de logs encontrado")
            return 0

        print(f"\n--- Carregando {len(log_files)} arquivos de logs ---")

        combined_logs = []
        total_lines = 0

        for filepath in log_files:
            try:
                with open(filepath, "r", encoding="utf-8") as f:
                    content = f.read()

                lines = content.count("\n")
                total_lines += lines
                combined_logs.append(
                    f"\n{'='*60}\n# Arquivo: {filepath.name}\n{'='*60}\n"
                )
                combined_logs.append(content)
                print(f"  [+] {filepath.name}: {lines} linhas")

            except Exception as e:
                print(f"  [!] Erro em {filepath.name}: {e}")

        if combined_logs:
            self.log_content = "\n".join(combined_logs)
            print(f"[OK] Total logs: {total_lines} linhas de {len(log_files)} arquivos")

        return len(log_files)

    def calculate_stats(self):
        """Calcula estatísticas da sessão"""
        if not NUMPY_AVAILABLE:
            print("[WARN] NumPy necessário para estatísticas completas")
            return

        # Estatísticas de telemetria
        if self.telemetry_data:
            time_data = self.telemetry_data.get("time", [])
            if time_data:
                self.stats.duration_seconds = max(time_data) - min(time_data)
                self.stats.total_points = len(time_data)

            speed = np.array(self.telemetry_data.get("speed", []))
            if len(speed) > 0:
                self.stats.speed_max = float(np.max(speed))
                self.stats.speed_avg = float(np.mean(speed))
                self.stats.speed_min = float(np.min(speed))

            throttle = np.array(self.telemetry_data.get("throttle", []))
            if len(throttle) > 0:
                self.stats.throttle_avg = float(np.mean(throttle))
                self.stats.full_throttle_percent = float(
                    np.sum(throttle >= 95) / len(throttle) * 100
                )

            brake = np.array(self.telemetry_data.get("brake", []))
            if len(brake) > 0:
                self.stats.brake_avg = float(np.mean(brake))
                self.stats.braking_percent = float(
                    np.sum(brake > 10) / len(brake) * 100
                )

            g_lat = np.array(self.telemetry_data.get("g_lateral", []))
            if len(g_lat) > 0:
                self.stats.g_lateral_max = float(np.max(g_lat))
                self.stats.g_lateral_min = float(np.min(g_lat))

            g_front = np.array(self.telemetry_data.get("g_frontal", []))
            if len(g_front) > 0:
                self.stats.g_frontal_max = float(np.max(g_front))
                self.stats.g_frontal_min = float(np.min(g_front))

        # Estatísticas de sensores (suporta prefixo bmi160_ ou sem prefixo)
        if self.sensor_data:
            # Tenta com prefixo bmi160_ primeiro, depois sem
            accel_x = np.array(
                self.sensor_data.get(
                    "bmi160_accel_x", self.sensor_data.get("accel_x", [])
                )
            )
            accel_y = np.array(
                self.sensor_data.get(
                    "bmi160_accel_y", self.sensor_data.get("accel_y", [])
                )
            )
            accel_z = np.array(
                self.sensor_data.get(
                    "bmi160_accel_z", self.sensor_data.get("accel_z", [])
                )
            )

            if len(accel_x) > 0:
                self.stats.accel_x_max = float(np.max(np.abs(accel_x)))
            if len(accel_y) > 0:
                self.stats.accel_y_max = float(np.max(np.abs(accel_y)))
            if len(accel_z) > 0:
                self.stats.accel_z_max = float(np.max(np.abs(accel_z)))

            gyro_z = np.array(
                self.sensor_data.get(
                    "bmi160_gyro_z", self.sensor_data.get("gyro_z", [])
                )
            )
            if len(gyro_z) > 0:
                self.stats.gyro_z_max = float(np.max(np.abs(gyro_z)))

            # Power Monitor data
            current_motor = np.array(self.sensor_data.get("current_motor", []))
            if len(current_motor) > 0:
                self.stats.current_motor_max = float(np.max(np.abs(current_motor)))
                self.stats.current_motor_avg = float(np.mean(np.abs(current_motor)))

            power_total = np.array(self.sensor_data.get("power_total", []))
            if len(power_total) > 0:
                self.stats.power_total_max = float(np.max(power_total))
                self.stats.power_total_avg = float(np.mean(power_total))

            voltage_rpi = np.array(self.sensor_data.get("voltage_rpi", []))
            if len(voltage_rpi) > 0:
                self.stats.voltage_rpi_avg = float(np.mean(voltage_rpi))

    def print_stats(self):
        """Imprime estatísticas formatadas"""
        print("\n" + "=" * 60)
        print("                    ESTATÍSTICAS DA SESSÃO")
        print("=" * 60)

        print(f"\n{'Duração:':<25} {self.stats.duration_seconds:.1f} segundos")
        print(f"{'Total de pontos:':<25} {self.stats.total_points}")

        print("\n--- Velocidade ---")
        print(f"{'  Máxima:':<25} {self.stats.speed_max:.1f} km/h")
        print(f"{'  Média:':<25} {self.stats.speed_avg:.1f} km/h")
        print(f"{'  Mínima:':<25} {self.stats.speed_min:.1f} km/h")

        print("\n--- Pedais ---")
        print(f"{'  Acelerador médio:':<25} {self.stats.throttle_avg:.1f}%")
        print(f"{'  Tempo full throttle:':<25} {self.stats.full_throttle_percent:.1f}%")
        print(f"{'  Freio médio:':<25} {self.stats.brake_avg:.1f}%")
        print(f"{'  Tempo frenando:':<25} {self.stats.braking_percent:.1f}%")

        print("\n--- Forças G ---")
        print(f"{'  G Lateral máx:':<25} {self.stats.g_lateral_max:.2f} G")
        print(f"{'  G Lateral mín:':<25} {self.stats.g_lateral_min:.2f} G")
        print(f"{'  G Frontal máx:':<25} {self.stats.g_frontal_max:.2f} G (aceleração)")
        print(f"{'  G Frontal mín:':<25} {self.stats.g_frontal_min:.2f} G (frenagem)")

        if self.sensor_data:
            print("\n--- Sensores BMI160 ---")
            print(f"{'  Accel X máx:':<25} {self.stats.accel_x_max:.2f} m/s²")
            print(f"{'  Accel Y máx:':<25} {self.stats.accel_y_max:.2f} m/s²")
            print(f"{'  Accel Z máx:':<25} {self.stats.accel_z_max:.2f} m/s²")
            print(f"{'  Gyro Z máx:':<25} {self.stats.gyro_z_max:.1f} °/s")

            # Power Monitor (se disponível)
            if self.stats.power_total_max > 0 or self.stats.current_motor_max > 0:
                print("\n--- Power Monitor ---")
                print(
                    f"{'  Corrente Motor máx:':<25} {self.stats.current_motor_max:.2f} A"
                )
                print(
                    f"{'  Corrente Motor média:':<25} {self.stats.current_motor_avg:.2f} A"
                )
                print(
                    f"{'  Potência Total máx:':<25} {self.stats.power_total_max:.1f} W"
                )
                print(
                    f"{'  Potência Total média:':<25} {self.stats.power_total_avg:.1f} W"
                )
                print(f"{'  Tensão RPi média:':<25} {self.stats.voltage_rpi_avg:.2f} V")

        # Timing diagnostics (se disponível)
        self._print_timing_stats()

        print("\n" + "=" * 60)

    def _print_timing_stats(self):
        """Imprime estatísticas de timing do RPi (se disponíveis nos dados)"""
        if not self.sensor_data or not NUMPY_AVAILABLE:
            return

        rpi_keys = [k for k in self.sensor_data if k.startswith("timing_")]
        client_keys = [k for k in self.sensor_data if k.startswith("client_timing_")]
        timing_keys = rpi_keys + client_keys
        if not timing_keys:
            return

        if rpi_keys:
            print("\n--- Timing RPi (ms) ---")
            self._print_timing_table(sorted(rpi_keys), prefix="timing_")

        if client_keys:
            print("\n--- Timing Client (ms) ---")
            self._print_timing_table(sorted(client_keys), prefix="client_timing_")

        # Resumo de jitter
        total_key = "timing_total_pre_send_ms"
        if total_key in self.sensor_data:
            arr = np.array([v for v in self.sensor_data[total_key] if v is not None and v > 0])
            if len(arr) > 0:
                slow_count = np.sum(arr > 50)
                print(f"\n  RPi pacotes > 50ms: {slow_count}/{len(arr)} ({slow_count/len(arr)*100:.1f}%)")

        client_total = "client_timing_total_ms"
        if client_total in self.sensor_data:
            arr = np.array([v for v in self.sensor_data[client_total] if v is not None and v > 0])
            if len(arr) > 0:
                slow_count = np.sum(arr > 10)
                print(f"  Client loops > 10ms: {slow_count}/{len(arr)} ({slow_count/len(arr)*100:.1f}%)")

    def _print_timing_table(self, keys, prefix=""):
        """Imprime tabela de timing para um conjunto de chaves"""
        print(f"  {'Métrica':<30} {'Média':>8} {'P50':>8} {'P95':>8} {'P99':>8} {'Máx':>8}")
        print("  " + "-" * 72)

        for key in keys:
            values = self.sensor_data[key]
            if not values or not isinstance(values, list):
                continue
            arr = np.array([v for v in values if v is not None and v > 0])
            if len(arr) == 0:
                continue

            label = key.replace(prefix, "").replace("_ms", "").replace("_", " ")
            print(
                f"  {label:<30} "
                f"{np.mean(arr):8.2f} "
                f"{np.percentile(arr, 50):8.2f} "
                f"{np.percentile(arr, 95):8.2f} "
                f"{np.percentile(arr, 99):8.2f} "
                f"{np.max(arr):8.2f}"
            )

    def plot_timing(self, save_path: Optional[str] = None):
        """Gera gráfico de timing do RPi ao longo da sessão"""
        if not MATPLOTLIB_AVAILABLE or not NUMPY_AVAILABLE:
            print("[ERRO] Matplotlib e NumPy necessários")
            return

        if not self.sensor_data:
            print("[ERRO] Dados de sensores não carregados")
            return

        timing_keys = sorted(
            [k for k in self.sensor_data if k.startswith("timing_") or k.startswith("client_timing_")]
        )
        if not timing_keys:
            print("[INFO] Sem dados de timing (sessão anterior aos timings)")
            return

        timestamps = self.sensor_data.get("timestamp", [])
        if not timestamps:
            return

        time_data = np.array(timestamps) - timestamps[0]

        plt.style.use("dark_background")
        fig, axes = plt.subplots(2, 1, figsize=(14, 8), facecolor=COLORS["background"])
        fig.suptitle(
            "Diagnóstico de Timing RPi",
            color=COLORS["text"], fontsize=14, fontweight="bold",
        )

        # 1. Timeline de cada timing
        ax1 = axes[0]
        ax1.set_facecolor(COLORS["background"])
        colors_cycle = ["#00D2BE", "#FF8700", "#0090FF", "#FF5555", "#55FF55", "#AA00FF"]
        for i, key in enumerate(timing_keys):
            values = self.sensor_data[key]
            if not values or not isinstance(values, list):
                continue
            label = key.replace("timing_", "").replace("_ms", "")
            color = colors_cycle[i % len(colors_cycle)]
            ax1.plot(
                time_data[:len(values)], values,
                color=color, linewidth=0.6, alpha=0.8, label=label,
            )

        ax1.axhline(y=50, color="#FF0000", linestyle="--", alpha=0.5, label="Limite 50ms")
        ax1.set_ylabel("Tempo (ms)", color=COLORS["text"])
        ax1.set_title("Timing por Componente", color=COLORS["text"], fontsize=10)
        ax1.legend(loc="upper right", facecolor=COLORS["background"], fontsize=8)
        ax1.grid(True, color=COLORS["grid"], alpha=0.3)

        # 2. Histograma do total
        ax2 = axes[1]
        ax2.set_facecolor(COLORS["background"])
        total_key = "timing_total_pre_send_ms"
        if total_key in self.sensor_data:
            arr = np.array([v for v in self.sensor_data[total_key] if v is not None])
            if len(arr) > 0:
                ax2.hist(arr, bins=50, color="#00D2BE", alpha=0.7, edgecolor="white", linewidth=0.5)
                ax2.axvline(x=np.mean(arr), color="#FFD700", linestyle="--", label=f"Média: {np.mean(arr):.1f}ms")
                ax2.axvline(x=np.percentile(arr, 95), color="#FF5555", linestyle="--", label=f"P95: {np.percentile(arr, 95):.1f}ms")
                ax2.legend(facecolor=COLORS["background"])
        ax2.set_xlabel("Tempo (ms)", color=COLORS["text"])
        ax2.set_ylabel("Frequência", color=COLORS["text"])
        ax2.set_title("Distribuição do Tempo Total (pre-send)", color=COLORS["text"], fontsize=10)
        ax2.grid(True, color=COLORS["grid"], alpha=0.3)

        plt.tight_layout()

        if save_path:
            plt.savefig(save_path, dpi=150, facecolor=COLORS["background"], bbox_inches="tight")
            print(f"[OK] Gráfico de timing salvo: {save_path}")
        else:
            plt.show()

    def plot_telemetry(self, save_path: Optional[str] = None):
        """Gera gráficos de telemetria estilo F1"""
        if not MATPLOTLIB_AVAILABLE:
            print("[ERRO] Matplotlib necessário para gráficos")
            return

        if not self.telemetry_data:
            print("[ERRO] Dados de telemetria não carregados")
            return

        time_data = self.telemetry_data.get("time", [])
        if not time_data:
            print("[ERRO] Sem dados de tempo")
            return

        # Configura estilo escuro
        plt.style.use("dark_background")

        fig = plt.figure(figsize=(14, 10), facecolor=COLORS["background"])
        fig.suptitle(
            "Telemetria F1 Car - Análise de Sessão",
            color=COLORS["text"],
            fontsize=14,
            fontweight="bold",
        )

        gs = GridSpec(4, 2, figure=fig, hspace=0.3, wspace=0.25)

        # 1. Velocidade
        ax1 = fig.add_subplot(gs[0, :])
        ax1.set_facecolor(COLORS["background"])
        speed = self.telemetry_data.get("speed", [])
        ax1.plot(time_data, speed, color=COLORS["speed"], linewidth=1.5)
        ax1.fill_between(time_data, speed, alpha=0.3, color=COLORS["speed"])
        ax1.set_ylabel("Velocidade (km/h)", color=COLORS["text"])
        ax1.set_title("Trace de Velocidade", color=COLORS["text"], fontsize=10)
        ax1.grid(True, color=COLORS["grid"], alpha=0.3)
        ax1.set_xlim(min(time_data), max(time_data))

        # 2. Acelerador e Freio
        ax2 = fig.add_subplot(gs[1, :])
        ax2.set_facecolor(COLORS["background"])
        throttle = self.telemetry_data.get("throttle", [])
        brake = self.telemetry_data.get("brake", [])
        ax2.plot(
            time_data,
            throttle,
            color=COLORS["throttle"],
            linewidth=1.5,
            label="Acelerador",
        )
        ax2.plot(time_data, brake, color=COLORS["brake"], linewidth=1.5, label="Freio")
        ax2.set_ylabel("Pedais (%)", color=COLORS["text"])
        ax2.set_title("Acelerador e Freio", color=COLORS["text"], fontsize=10)
        ax2.legend(loc="upper right", facecolor=COLORS["background"])
        ax2.grid(True, color=COLORS["grid"], alpha=0.3)
        ax2.set_ylim(0, 105)
        ax2.set_xlim(min(time_data), max(time_data))

        # 3. Forças G
        ax3 = fig.add_subplot(gs[2, :])
        ax3.set_facecolor(COLORS["background"])
        g_lat = self.telemetry_data.get("g_lateral", [])
        g_front = self.telemetry_data.get("g_frontal", [])
        ax3.plot(
            time_data,
            g_lat,
            color=COLORS["g_lateral"],
            linewidth=1.5,
            label="G Lateral",
        )
        ax3.plot(
            time_data,
            g_front,
            color=COLORS["g_frontal"],
            linewidth=1.5,
            label="G Frontal",
        )
        ax3.axhline(y=0, color=COLORS["grid"], linestyle="--", alpha=0.5)
        ax3.set_ylabel("Força G", color=COLORS["text"])
        ax3.set_xlabel("Tempo (s)", color=COLORS["text"])
        ax3.set_title("Forças G", color=COLORS["text"], fontsize=10)
        ax3.legend(loc="upper right", facecolor=COLORS["background"])
        ax3.grid(True, color=COLORS["grid"], alpha=0.3)
        ax3.set_xlim(min(time_data), max(time_data))

        # 4. Distribuição de velocidade (histograma)
        ax4 = fig.add_subplot(gs[3, 0])
        ax4.set_facecolor(COLORS["background"])
        if NUMPY_AVAILABLE and speed:
            ax4.hist(
                speed, bins=30, color=COLORS["speed"], alpha=0.7, edgecolor="white"
            )
        ax4.set_xlabel("Velocidade (km/h)", color=COLORS["text"])
        ax4.set_ylabel("Frequência", color=COLORS["text"])
        ax4.set_title("Distribuição de Velocidade", color=COLORS["text"], fontsize=10)
        ax4.grid(True, color=COLORS["grid"], alpha=0.3)

        # 5. G-G Diagram (scatter)
        ax5 = fig.add_subplot(gs[3, 1])
        ax5.set_facecolor(COLORS["background"])
        if g_lat and g_front:
            scatter = ax5.scatter(
                g_lat,
                g_front,
                c=time_data,
                cmap="plasma",
                alpha=0.6,
                s=10,
                edgecolors="none",
            )
            plt.colorbar(scatter, ax=ax5, label="Tempo (s)")
        ax5.axhline(y=0, color=COLORS["grid"], linestyle="--", alpha=0.5)
        ax5.axvline(x=0, color=COLORS["grid"], linestyle="--", alpha=0.5)
        ax5.set_xlabel("G Lateral", color=COLORS["text"])
        ax5.set_ylabel("G Frontal", color=COLORS["text"])
        ax5.set_title("Diagrama G-G", color=COLORS["text"], fontsize=10)
        ax5.grid(True, color=COLORS["grid"], alpha=0.3)
        ax5.set_aspect("equal", adjustable="box")
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
