inacio-dev/tcc/(commit log)

2025-09-08 Implement complete F1 car control system
    Major features:
    - Real-time keyboard controls (arrows/WASD + M/N gear shifting)
    - Brake balance adjustment interface (60%/40% default)
    - Automatic client discovery (no IP configuration needed)
    - Performance optimization (structured logging system)
    - Comprehensive error handling and clean shutdown
    [logger.py, main.py]
2025-09-12 O problema é que o código está tentando usar self.is_connected mas esse atributo não existe.
2025-09-12 ✅ Inicializa todos os componentes ✅ Aguarda conexão de cliente antes de iniciar operação✅ Pausa se cliente desconectar e aguarda reconexão ✅ Não gera 'falhas de transmissão' desnecessárias
2025-09-12 O que estava errado: - Cliente enviava CONNECT sem especificar sua porta de escuta - Raspberry Pi assumia porta 9999 para todos os clientes - Cliente não recebia os dados porque RPi enviava para port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
    O que foi corrigido:
    - Cliente agora envia CONNECT:9999 (incluindo sua porta de escuta)
    - Raspberry Pi registra a porta correta do cliente
    - Dados serão enviados para a porta certa
    [main.py]
2025-09-12 ✅ Double Ctrl+C Protection: Primeiro Ctrl+C para parada limpa, segundo Ctrl+C força saída imediata
    ✅ Timeout de 2s por componente: Evita travamento nos métodos cleanup()
    ✅ Thread isolada para cleanup: Cada componente para em thread separada
2025-09-29 fix: motor
2025-10-13 Esp32 added
2025-10-14 Calibration added
2025-10-14 Calibration added v2
2025-12-17 Testando nova formato de video
2025-12-17 Testando nova formato de video - 2
2025-12-17 Testando Multi-Thread RPi
2025-12-17 Separação de Envio entre frames e sensores
2025-12-17 Ultimo modelo do raspberry antes de montar o carro
2025-12-19 Autalização de docs
2025-12-27 Autalização de datasheets
2025-12-27 Autalização de monografia latex
2025-12-27 Autalização de monografia
    [TCC - Artigos.xlsx]
2025-12-31 refactor(video): migra de H.264 para MJPEG e padroniza nomenclatura
    Monografia:
    - Reorganiza seção 3.1 em três tabelas: veículo (RPi), simulador (ESP32) e cliente (PC)
    - Adiciona especificações do notebook cliente (Nitro V15, i5-13420H, RTX 3050, 32GB DDR5)
    - Adiciona diagrama de arquitetura do sistema com nitidez melhorada
    - Padroniza nomenclatura: carrinho→veículo teleoperado, cockpit→simulador
    - Move rolamento CSK8PP para tabela do veículo (proteção do motor de propulsão)
    - Documenta migração de H.264 para MJPEG com justificativa técnica
    Cliente:
    - Remove classe H264Decoder e dependência PyAV do video_display.py
    - Simplifica decodificação para MJP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
2026-01-08 fix(metodologia): corrige algoritmos de force feedback e adiciona gráficos
    - Corrige equação força G lateral: usa accel_y/9.81 (não gyro_z×velocidade)
    - Corrige constantes de velocidade: LIMIAR_ACCEL=0.3, DECAY=0.98
    - Remove algoritmos não implementados: vibrações, calibração automática
    - Adiciona script generate_ff_charts.py para gerar visualizações
    - Adiciona 6 figuras ilustrativas: componentes FF, cenários, parâmetros,
    direção, forças G e integração de velocidade
    - Adiciona seções: parâmetros ajustáveis, direção FF, mapeamento PWM
    [generate_ff_charts.py]
2026-02-02 feat: adiciona calibração de sensores de corrente com persistência
    - Move encoder_calibration.json para pasta client/
    - Adiciona --calibrate-power ao main.py do RPi para calibrar ACS758
    - Adiciona save/load de offsets em power_calibration.json
    - Carrega calibração automaticamente na inicialização
2026-02-02 fix: corrige conflito de endereços I2C entre INA219 e PCA9685
    - PCA9685: 0x40 → 0x41 (A0 soldado para evitar conflito)
    - INA219: 0x41 → 0x40 (endereço padrão fixo do módulo)
    [main.py]
2026-02-02 fix: corrige saturação do ADC na leitura de tensão da bateria
    - PGA do ADS1115: ±4.096V → ±6.144V (0x8583 → 0x8183)
    - Scale: 4.096/32768 → 6.144/32768
    - Bateria 12.6V ÷ 2 = 6.3V agora dentro da faixa do ADC
2026-02-02 debug: adiciona log de todos os canais ADS1115 para diagnóstico
2026-02-14 feat: substitui ADS1115 por Arduino Pro Micro para monitoramento de energia
    Arquitetura nova:
    - Pro Micro A0: tensão bateria 3S LiPo (divisor R1=20kΩ, R2=10kΩ)
    - Pro Micro A1: ACS758 50A (corrente servos/UBEC)
    - Pro Micro A2: ACS758 100A (corrente motor DC 775)
    - INA219 (I2C): tensão/corrente/potência do RPi
    Protocolo serial: PWR:<v_bat>,<i_servos>,<i_motor> @ 115200 baud
    Alterações:
    - Cria pro_micro/pro_micro.ino (firmware completo com EEPROM, filtros, calibração)
    - Reescreve power_monitor_manager.py (remove ADS1115, adiciona serial USB)
    - Cria energy_panel.py (painel dedicado com bateria, motor, servos, RPi)
    - Remove seção de energia do instrument_panel.py
    - Atualiza MODULOS.m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
2026-02-18 feat: substitui ESP32 por Logitech G923 no client e remove pasta esp32
    - Cria g923_manager.py com detecção via evdev, leitura de eixos/botões
    e force feedback FF_CONSTANT
    - Adapta main.py, console/main.py e force_feedback_calc.py para usar
    G923Manager em vez de SerialReceiverManager
    - Substitui calibração de encoders ESP32 por calibração de eixos G923
    com persistência em JSON e aplicação automática dos ranges
    - Cria g923_status.py com indicador visual de conexão
    - Corrige scroll do mouse no Linux (Button-4/5 vs MouseWheel)
    - Atualiza CLAUDE.md, docs e pro_micro.ino com high-side ACS758
    - Corrige endereço PCA9685 nos testes (0x40 → 0x41)
    - Remove pasta esp32/ (não mais u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
    [g923_status.py, main.py, pro_micro.ino]
2026-02-18 docs: atualiza monografia para nova arquitetura (G923 + Pro Micro)
    - Metodologia: substitui ESP32 por Logitech G923 na seção do simulador,
    substitui ADS1115 por Arduino Pro Micro no monitoramento de energia,
    atualiza tabelas de componentes, bibliotecas e repositório
    - Apêndice RPi: consolida de 5 partes para 2 diagramas atualizados,
    remove entrada do ADS1115 das tabelas I2C
    - Remove apêndice do ESP32 (obsoleto) e diagramas antigos (rpi-3/4/5)
    - Adiciona imagem e referência do Logitech G923 TRUEFORCE
    - Adiciona acrônimo HID na lista de abreviaturas
    - Atualiza CLAUDE.md, README.md e figuras da arquitetura
2026-02-25 feat: integra G923 com proteção de rede, FF local e documentação
    - Corrige bloqueio mDNS: envio de rede só ocorre com RPi confirmado
    - Slider controller vira visual quando G923 conectado (sem envio duplo)
    - Adiciona FF local (centering spring + friction) sem depender do RPi
    - Adiciona slider Max Force para limitar força do motor G923
    - Corrige nomes ctypes (ff_constant_effect) e upload_effect retorno
    - Corrige mapeamento de eixos/botões para G923 versão Xbox
    - Adiciona logging throttled dos eixos G923 (1x/seg)
    - Documenta toda arquitetura do client em docs/G923_SETUP.md
    - Adiciona script de teste e calibração do G923
    [force_feedback.py, main.py]
2026-02-26 feat: FF 7 efeitos, endstop virtual, calibração persistente e export pickle
    - G923: expande de 4 para 8 efeitos FF simultâneos (spring, damper, friction,
    inertia, constant, rumble, periodic, endstop)
    - Adiciona FF_RUMBLE (impactos), FF_PERIODIC (RPM motor), FF_INERTIA (peso)
    - Endstop virtual: trava progressiva nos limites calibrados da direção
    - Calibração: desativa endstop automaticamente durante calibração de steering
    - Calibração: reaplicada após find_device() no startup (fix sobrescrita)
    - Mínimos sempre ativos: spring 5%, friction 3%, inertia 5%, periodic idle
    - Max Force: threshold 25% com indicador vermelho na UI
    - Export pickle: adiciona campos FF dinâmicos e inputs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
    [force_feedback.py, main.py]
2026-02-26 fix: corrige canais PCA9685 hardcoded no main.py do RPi
    [main.py]
2026-02-26 fix: reduz limites PWM por marcha e suaviza aceleração do motor
    - Limitadores: 1ª=8%, 2ª=15%, 3ª=30%, 4ª=50%, 5ª=70%
    - Tempo de aceleração: 5s → 8s (mais suave)
    - Remove min_motor_pwm=15% que inflava qualquer input
    - PWM < 1% corta para 0 (evita motor ligado sem girar)
2026-02-26 fix: aumenta tempo de aceleração do motor para 12s
2026-02-26 fix: remove corte PWM < 1% que bloqueava throttle baixo na 1ª marcha
2026-02-26 fix: aumenta tempo base de aceleração para 50s (1ª marcha ~8s)
    Motor RC 775 a 16000RPM precisa de ramp-up lento. Com base_acceleration_time=50s,
    a 1ª marcha (teto 8% PWM) leva ~8s para atingir máximo.
2026-02-26 feat: unifica comandos G923 em pacote STATE a 100Hz
    - G923 envia CONTROL:STATE:steering,throttle,brake em pacote único
    - Rate limited a 100Hz (10ms) — robusto contra perda de pacotes
    - RPi parseia STATE e aplica os 3 controles de uma vez
    - Prints do RPi rate limited a 1s (steering, throttle, brake)
    - Comandos individuais mantidos para teclado/sliders
2026-02-26 fix: remove prints sem rate limit do brake e steering no RPi
2026-02-26 fix: remove prints repetitivos de 'não inicializado' nos managers
2026-02-26 feat: freio multiplica desaceleração do motor (0%=1x, 100%=10x)
2026-02-27 fix: corrige BMI160 zerando e pickle export incompleto
    - Dedup escritas I2C PCA9685: só escreve no servo quando ângulo muda >=0.1°
    (evita 300 escritas/s no bus I2C quando valores não mudam)
    - Fix G923 zero no pickle: remove guard is_connected() da injeção
    - Fix client sistema zero no pickle: escreve em display_data ao invés de
    current_data (que era órfão e nunca chegava ao update_history)
    [main.py]
2026-02-27 feat: lock I2C com prioridade (steering/brake > BMI160 > INA219)
    Lock compartilhado no bus I2C 1 elimina colisões entre threads.
    Prioridade 0 (alta) para steering/brake (segurança), 1 (média) para
    BMI160 (sensores), 2 (baixa) para INA219 (monitoramento). Mantém
    dedup de escritas nos servos. Documenta arquitetura em I2C_BUS_LOCK.md.
2026-02-27 feat: padroniza comunicação a 60Hz e remove porta 9997 redundante
    RPi: sensor thread 100→60Hz, TX rede 120→60Hz, remove send_fast_sensors
    Client: G923 60Hz, keyboard 60Hz, slider 60Hz, remove fast_sensor thread
    Sensores BMI160 agora vão apenas no pacote consolidado (porta 9999).
    Porta 9997 removida — era redundante com o pacote consolidado.
2026-02-27 fix: watchdog BMI160 brown-out, dedup FF ioctls e auto-save async
    BMI160: detecta zeros consecutivos (brown-out por motor) e re-ativa PMU.
    G923 FF: cache de coeficientes evita upload_effect redundante (5 ioctls/100ms → 0).
    Auto-save: snapshot rápido + pickle.dump em thread background.
2026-02-27 feat: separa vídeo (9999/30Hz) e sensores (9997/60Hz) em portas distintas
    RPi: 2 threads TX independentes — vídeo não compete com sensores.
    Client: 2 threads RX — vídeo e sensores processados em paralelo.
    G923: STATE enviado apenas quando eixo muda (dirty flag).
2026-02-27 fix: corrige parâmetro data_port → video_port/sensor_port no RPi main.py
    [main.py]
2026-02-27 diag: adiciona logs de timing em threads TX, câmera, sensores e rede
2026-02-27 fix: alinha zonas de eficiência F1 com limitadores de marcha
    Zonas IDEAL/SUBOPTIMAL/POOR estavam desalinhadas com os limitadores
    (1ª=8%, 2ª=15%, 3ª=30%, 4ª=50%, 5ª=70%). Ao trocar de 1ª para 2ª,
    o PWM de 8% caía em SUBOPTIMAL (0.10x), impedindo aceleração.
    Na 1ª, zona IDEAL ia até 10% mas limiter era 8%, conta-giros travava em 80%.
    Agora cada marcha tem zona IDEAL cobrindo o ponto de entrada da anterior:
    1ª→2ª: 8% cai em IDEAL (7-13%), 2ª→3ª: 15% cai em IDEAL (13-25%), etc.
    Também inclui doc de diagnóstico WiFi latency (mDNS + power save).
2026-02-27 feat: corrige force feedback multi-efeito e adiciona monitor na UI
    - Fix crítico: driver hid-lg4ff do G923 não aplica mudanças via
    upload_effect() em efeitos existentes. Efeitos dinâmicos (constant,
    rumble, periodic, endstop) agora são destruídos e recriados do zero
    a cada atualização via _recreate_effect().
    - Fix: Replay(0xFFFF, 0) expirava em 65s → Replay(0, 0) = infinito.
    - Magnitudes de vibração aumentadas ~4x para compensar FF_GAIN 15%:
    periodic idle 3%→15%, full throttle 30%→90%, rumble com engine_vibration.
    - FF_PERIODIC: frequência 20-40ms (50Hz)→80-200ms (5-12Hz) perceptível.
    - Novo componente engine_vibration no rumble (proporcional ao throttle).
    -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
    [force_feedback.py, main.py]
2026-03-06 refactor: substitui todos os print() pelo sistema de logger centralizado
    - client/: substitui print() por simple_logger (debug/info/warn/error)
    nos arquivos: main.py, network_client.py, sensor_display.py,
    video_display.py, image_filters.py, g923_manager.py,
    console/frames/video.py, console/frames/camera_controls.py,
    console/logic/auto_save.py
    - raspberry/: substitui print() por logger (debug/info/warn/error)
    nos arquivos: main.py, network_manager.py, bmi160_manager.py,
    brake_manager.py, steering_manager.py, camera_manager.py,
    motor_manager.py, power_monitor_manager.py
    - Remove import não utilizado 'categorize' do g923_manager.py
    Blocos except ImportError mantidos com print(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
    [camera_controls.py, main.py]
2026-03-08 fix: expande range da direção para 0°-180° com centro em 90°
    Ajusta os limites do servo MG996R para usar o range físico completo:
    - Centro: 56.7° → 90° (1.5ms)
    - Máximo direita: 113.4° → 180° (2.0ms)
    - Range de esterçamento: ±56.7° → ±90°
2026-03-09 perf: desacopla processamento de sensores da GUI — 10Hz → 100Hz
    Problema anterior: process_queues() rodava na GUI thread via root.after(100ms),
    limitando cálculos, force feedback e exports a apenas 10Hz, mesmo com o RPi
    enviando dados a 100Hz.
    Solução: thread separada sensor-proc-100hz desacoplada do Tkinter.
    Mudanças:
    client/console/main.py
    - Adiciona import threading e import time
    - Adiciona _latest_sensor_data (dict), _sensor_data_lock (Lock) e _sensor_thread
    ao __init__ para comunicação thread-safe entre sensor thread e GUI thread
    - Novo método _sensor_processing_loop(): roda a 100Hz em daemon thread;
    executa process_queue(), velocity_calculator, ff_calculator, send_ff_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
    [main.py, telemetry_plotter.py]
2026-03-09 refactor: remove SteeringMode enum e argumento --steering-mode
    O enum SteeringMode (NORMAL/SPORT/COMFORT/PARKING) era definido e
    armazenado em self.steering_mode, mas nunca lido em nenhuma lógica
    condicional no steering_manager.py. O modo não alterava nenhum
    comportamento do servo — apenas era logado na inicialização e incluído
    nos dados de telemetria. Remove o enum, o parâmetro steering_mode de
    SteeringManager.__init__() e F1CarController.__init__(), o argumento
    --steering-mode do CLI e todos os usos relacionados.
2026-03-09 tune: reduz base_acceleration_time de 50s para 25s (2x mais responsivo no acelerador)
2026-03-09 tune: reduz base_acceleration_time para 5s (10x mais responsivo no acelerador)
2026-03-09 tune: ajusta base_acceleration_time para 20s (2.5%/s PWM na zona IDEAL)
2026-03-10 feat: FF silencia com veículo parado + fila tempo real + novos limitadores de marcha
    Force feedback:
    - Adiciona detecção de veículo parado (throttle, brake, G-forces, gyro)
    - Zera FF_CONSTANT, RUMBLE, PERIODIC quando parado (decai EMA rápido)
    - Limpa histórico BMI160 quando parado para evitar dados obsoletos
    Fila de sensores:
    - process_queue() agora drena toda a fila e processa apenas o pacote
    mais recente, descartando intermediários (tempo real)
    Limitadores de marcha (RPi):
    - 1ª: 8% → 14%, 2ª: 15% → 22%, 3ª: 30% → 35%, 4ª: 50% → 55%, 5ª: 70%
    - Zonas de eficiência recalculadas para os novos limitadores
2026-03-10 fix: resolve mDNS (f1client.local) uma vez no startup e reutiliza IP numérico
    Antes, send_connect_to_client() re-resolvia f1client.local via mDNS a
    cada 10s no ping periódico, causando travamentos no loop de sensores.
    Agora o hostname é resolvido uma vez no start() e o IP numérico é
    reutilizado em todas as chamadas subsequentes.
    [main.py]
2026-03-10 teste: base_acceleration_time = 50s (1%/s PWM na zona IDEAL)
2026-03-10 feat: zona morta 0-6% na 1ª marcha com rampa rápida
    Motor fica em 0% PWM quando parado. Ao acelerar, atravessa a zona
    morta (0-6%) com rampa 20x mais rápida que o normal (~0.3s), pois
    abaixo de 6% o motor RC 775 não gira. Após 6%, aceleração normal
    por zonas F1 assume. Na desaceleração, comportamento inverso:
    desacelera normalmente até 6%, depois queda rápida para 0%.
2026-03-10 fix: resolve starvation do BMI160 no barramento I2C + otimiza delays
    PriorityI2CLock reescrito com weighted fair queuing — prioridade alta
    (servo) executa até 3x seguidas, depois cede vez para BMI160 (2x) e
    INA219 (1x). Antes, o servo bloqueava totalmente o BMI160 ao acelerar.
    BMI160 otimizado conforme datasheet BST-BMI160-DS000-09:
    - Delay de escrita: 5ms → 1ms (spec: 2µs em normal mode)
    - Delay de leitura: 5ms → 0ms (sem necessidade pelo datasheet)
    - _rewake_sensor: ~183ms → ~100ms (removidos delays excessivos)
    - Threshold de zeros: 5 → 3 (detecção mais rápida de brown-out)
    [main.py]
2026-03-10 feat: limitadores de marcha com intervalos crescentes e teto 100%
    Redistribui limites PWM por marcha simulando transmissão real:
    - 1ª: 12% (intervalo 6% — arranque curto, alto torque)
    - 2ª: 25% (intervalo 13% — aceleração inicial)
    - 3ª: 45% (intervalo 20% — velocidade média)
    - 4ª: 70% (intervalo 25% — velocidade alta)
    - 5ª: 100% (intervalo 30% — velocidade máxima, sem limite)
    Zonas de eficiência e conta-giros recalculados para novos limites.
2026-03-10 perf: otimiza latência do force feedback + abs() na energia + docs I2C
    - FF_CONSTANT/RUMBLE/PERIODIC: upload in-place (1 ioctl) ao invés de
    recreate (4 ioctls), com fallback automático
    - Cache no apply_constant_force() evita ioctl quando valor não mudou
    - Quantização EMA (round()) para que cache funcione com inputs estáveis
    - abs() nos valores de corrente/tensão/potência na interface (fio invertido)
    - Nova doc I2C_CONFIG.md: como verificar baudrate 400kHz no RPi4
    - Atualiza docs: BMI160_WATCHDOG, I2C_BUS_LOCK, FORCE_FEEDBACK, G923_SETUP
2026-03-16 docs: atualiza metodologia e gráficos conforme código-fonte
    - Corrige mapeamento G923 (ABS_Y throttle, BTN_TOP2/BTN_PINKIE paddles)
    - Zona morta 0-6% PWM aplicada a todas as marchas (código + docs)
    - Regenera gráficos de zonas de eficiência e taxas de aceleração
    - Regenera gráficos de force feedback com 8 efeitos simultâneos
    - Corrige endereços I2C no apêndice (INA219=0x40, PCA9685=0x41)
    - Unifica diagrama RPi em figura única
    - Adiciona sigla EMA à lista de abreviaturas
    [generate_ff_charts.py]
2026-03-17 refactor: reorganiza raspberry/managers + modelo G(s)=K/(τs+1) + gitignore
    - Reorganiza managers do RPi em subpacote raspberry/managers/
    - Reescreve motor.py com ODE de 1ª ordem: G(s) = K/(τs+1)
    - Adiciona efficiency_zone ao status do motor (enviado via UDP)
    - Client: conta-giros muda cor por zona (verde/amarelo/vermelho)
    - Monografia: reescreve seção Motor com 4 equações + 4 figuras novas
    - Fundamentação teórica: subseção sistemas de 1ª ordem (Franklin 2013)
    - Adiciona referência Franklin et al. "Sistemas de Controle" 6ª ed.
    - Pipeline ff_pipeline.png movido para seção arquitetura G923
    - Remove script antigo generate_gear_zones_chart.py
    - Novo generate_motor_charts.py com 9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
2026-03-20 fix: sliders enviam STATE unificado igual ao G923
    - Sliders agora atualizam _control_state via callback (state_callback)
    - Loop 100Hz envia STATE:steering,throttle,brake ao RPi uniformemente
    - Remove thread de envio individual do slider_controller
    - Adiciona debug logs [CMD-RX] no RPi e [SLIDER] no client
    [main.py]
2026-03-20 fix: ponte H BTS7960 precisa ambos enables (R_EN + L_EN) em HIGH
    - Adiciona L_EN_PIN (GPIO23) ao motor.py — faltava habilitar
    - Sem L_EN em HIGH a ponte H não ativa e motor não gira
    - Remove spam de has_connected_clients() debug log
    - Remove logs temporários de debug ([CMD-RX], [SLIDER])
    [main.py, motor.py, network.py]
2026-03-20 feat: adiciona timings de diagnóstico ao pacote de sensores
    - timing_bmi160_read_ms: tempo de leitura I2C do BMI160
    - timing_power_ms: tempo de leitura do monitor de energia
    - timing_lock_ms: tempo de lock para copiar dados
    - timing_status_ms: tempo para coletar status dos atuadores
    - timing_state_cmd_ms: tempo do último STATE command (steering+motor+brake)
    - timing_total_pre_send_ms: tempo total antes do send UDP
    - Dados enviados no pacote consolidado → salvos no auto-save do client
    - Remove spam de has_connected_clients() debug
2026-03-20 feat: instrumentação de timing no client + auto-save dinâmico
    - Client sensor loop (100Hz): timing de queue, cálculos, FF, writeback
    - Client GUI (10Hz): timing do update_sensor_data
    - Network: timing do JSON decode de sensores
    - sensor_display: salva TUDO dinamicamente (sem lista fixa de campos)
    - Corrige deadlock no update_history (data_lock já segurado pelo caller)
    - analyze_session.py: tabelas separadas RPi/Client + plot_timing atualizado
    [analyze_session.py, main.py]
2026-03-20 fix: timings do client sensor loop salvos no display_data para pickle
    Os timings (queue, calc, ff, writeback, total) são injetados no
    display_data do sensor_display para que o próximo update_history
    os capture e salve no pickle automaticamente.
    [main.py]
2026-03-20 feat: mede latência de rede RPi→Client por pacote (NTP sincronizado)
    - net_latency_ms: tempo real one-way (client_time - rpi_timestamp)
    - client_recv_timestamp: momento de recepção para análise offline
    - Salvo no pickle automaticamente
2026-03-20 docs: documentação completa de diagnóstico de performance
    - PERFORMANCE_DIAGNOSTICS.md com pipeline end-to-end e evolução
    - Tabelas de referência (WiFi 2.4GHz) com todos os timings
    - Instruções de coleta, análise e sincronização NTP
    - raw_buffer salva todos os pacotes sem drain para pickle
    - Auto-save exporta raw_buffer (dados completos 100Hz)
2026-03-20 fix: timings do client injetados no raw_buffer via inject_client_timings
    - inject_client_timings() sobrescreve último registro do raw_buffer
    - Timings calc, ff, queue, writeback, total aparecem no pickle
    - Mantém display_data atualizado para GUI
    [main.py]
2026-03-20 docs: atualiza PERFORMANCE_DIAGNOSTICS com dados finais (raw buffer 84Hz)
    - Tabelas atualizadas com 1779 amostras raw (sem perda)
    - Resumo end-to-end: RPi 0.26ms + Rede 45ms + Client 0.20ms = ~46ms
    - Seção Raw Buffer vs Drain explicando as duas estratégias
    - Latência de rede WiFi 2.4GHz com NTP sync
2026-03-20 fix: abs() nas correntes do power monitor (polaridade dos cabos)
    [power_monitor.py]
2026-03-22 refactor: reorganiza client/managers + RPi utils + corrige docs
    - Client: move 7 managers para client/managers/ (g923, network, video,
    sensor, keyboard, slider, image_filters)
    - Client: cria managers/constants.py com portas, buffers, rates
    - Client: substitui magic numbers por constants nos managers
    - Client: imports movidos para topo em 6 arquivos
    - Client: timing de filtros PDI (decode + filtros individuais) no pickle
    - RPi: extrai PriorityI2CLock para raspberry/utils/i2c_lock.py
    - RPi: alinha defaults construtor com CLI (camera 60Hz, sensor 100Hz)
    - RPi: TX vídeo/sensores usam self.camera_fps/sensor_rate (não fixo)
    - Docs: corrige H.264→MJPEG, 30Hz→60Hz, I2C addresses, file paths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
    [force_feedback.py, main.py]
2026-03-22 fix: corrige issues críticos, altos e médios no RPi e Client
    RPi (6 críticos + 4 altos):
    - bmi160: inicializa _last_accel/gyro_data no __init__ (race condition)
    - bmi160: remove SMBus recreation durante retry, reseta error counter
    - network: fecha socket se bind falha (resource leak)
    - power_monitor: fecha I2C bus se _init_ina219() falha
    - steering: null check explícito no servo antes de acessar .angle
    - i2c_lock: timeout de 1s no _cond.wait() (previne deadlock)
    - logger: protege dicts last_log_times/log_counts com lock
    - rpi_system: is_initialized=False no except de initialize()
    Client (4 críticos + 4 altos + 5 médios):
    - sensor/video: queue.empty() race condition → except queue.Em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
    [bmi160.py, logger.py, main.py, network.py, power_monitor.py]
2026-03-22 fix: corrige issues médios restantes (os.system, cores, overlay)
    - temperature.py: os.system() → subprocess.run() para modprobe
    - slider.py: extrai 8 cores hardcoded para class constants
    - video.py: extrai posições do overlay para constants
    [temperature.py, video.py]
2026-03-22 fix: corrige 42 issues de qualidade (race conditions, deadlocks, memory leaks)
    Raspberry Pi:
    - motor.py: state_lock em _acceleration_loop, _shift_gear, emergency_stop
    - network.py: deadlock no cleanup (clients_lock reentrante), remove dead code
    - power_monitor.py: EMA invertido (alpha*new + (1-alpha)*old)
    - brake.py: lock ordering corrigido (I2C fora do state_lock)
    - steering.py: cleanup não faz deinit PCA9685 (brake faz)
    - camera.py: total_frames_ever para stats cumulativas
    - temperature.py: deque(maxlen) ao invés de list+pop(0)
    - logger.py: last_log_times bounded a 500 entries
    - main.py: _client_ip inicializado no __init__
    Client:
    - sensor.py: raw_buffer bounded (12k rows), deque em upd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
    [brake.py, camera.py, logger.py, main.py]
2026-03-22 fix: corrige timing drift nos loops TX e remove dead thread do teclado
    - Client/RPi TX loops usam timing compensado (next_tick) em vez de sleep fixo
    - Remove _command_loop dead thread do keyboard (active_commands sempre vazio)
    - Adiciona check de conexão RPi no keyboard antes de enviar GEAR
    - Protege brake_input com state_lock no RPi
    [main.py]
2026-03-22 refactor: remove dead code e reorganiza client/managers
    - Move simple_logger.py e client_system_monitor.py para client/managers/
    - Atualiza todos os imports (15 arquivos) para nova localização
    - Remove 20 itens de dead code no client (métodos, atributos, constantes)
    - Remove dead code no RPi: get_statistics() (6x), _gpio_to_pin, manual_shift,
    get_tachometer_data, get_wheel_angles, emergency_brake, set_resolution,
    get_current_settings, get_system_status, funções do logger não usadas
    - Remove queues não usadas, atributos mortos e safety limiters simulados
    - Total: -1094 linhas em 36 arquivos
2026-04-03 docs: atualiza seção UDP da metodologia, adiciona artigos 55-57 e corrige specs
    - Reescreve seção 3.1 (Protocolo de Comunicação UDP) com dados reais
    de latência, referências à literatura e correções de código
    - Adiciona artigos 55 (Machado 2021), 56 (AL-Dhief 2018), 57 (Bekele 2024)
    com entradas JSON e referências BibTeX
    - Move tabela comparativa de latência UDP para fundamentação teórica
    - Adiciona gráfico de latência por configuração de hardware testada
    - Adiciona algoritmo de resolução mDNS com cache de IP
    - Corrige buffers de socket (8KB→32KB sensores, 128KB comandos)
    - Corrige taxa de comandos (on-demand→100Hz STATE + on-demand marcha)
    - Corrige roteador (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
2026-04-07 docs: reescreve seções da metodologia e adiciona método de Euler (monografia)
    simplifica e melhora a clareza do texto em múltiplas seções da metodologia
    (arquitetura do veículo, multi-thread, I2C, direção/freios, sensoriamento),
    adiciona formalização do método de Euler na fundamentação teórica com
    referência a Ruggiero (1996), corrige tabela de bibliotecas do RPi,
    inclui apêndice com exemplo numérico completo da transmissão e
    atualiza gráficos do sistema de marchas
2026-04-07 docs: revisa metodologia, remove seções desnecessárias e melhora legibilidade (monografia)
    remove padrões de escrita AI (enumerações numeradas, linguagem promocional,
    gerúndios decorativos), enxuga seções infladas (impressora 3D, back-EMF,
    análise de sessões, configurações ambientais), adiciona dedução do método
    de Euler com equações intermediárias, corrige label duplicado, melhora
    figura do pipeline FF com fontes maiores, reformula dados armazenados
    em tabela para evitar overfull hbox, e adiciona arquivos auxiliares do
    LaTeX ao gitignore
    [generate_ff_charts.py]
2026-04-09 docs: reescreve seções do cliente e force feedback, atualiza dados experimentais (monografia)
    Sessão experimental atualizada de 15 para 25 minutos (150k pontos de telemetria).
    Reescreve arquitetura do cliente, interface gráfica e multi-threading com foco
    em clareza e eliminação de redundância. Detalha algoritmos de FF_RUMBLE com
    tabela de componentes/pesos, adiciona derivação matemática da estimativa de
    velocidade por integração de Euler, e reestrutura seções de logs/reprodutibilidade.
    Atualiza screenshot da interface e corrige abstract/resumo.
2026-04-09 docs: reestrutura metodologia com protocolo experimental e move dados para resultados (monografia)
    A metodologia estava misturando descrição do sistema com dados experimentais,
    dificultando a leitura e quebrando a separação entre método e resultado.
    Adiciona seção de protocolo experimental com variáveis, critérios de aceitação
    e procedimento de coleta. Move tabelas de specs e algoritmos auxiliares para
    apêndices, e dados de latência UDP para o capítulo de resultados.
    Habilita capítulos de resultados e conclusão no documento principal.
2026-04-13 fix: corrigir nome do método em set_brake_balance (brake)
    método _calculate_brake_distribution não existe na classe;
    o nome correto é _calculate_brake_angles, causando AttributeError
    durante o teste de inicialização dos servos
    [brake.py]
2026-04-14 feat: adicionar análise de sessões e correções do primeiro teste
    scripts de análise (session_report, session_plots) processam os
    exports automáticos da sessão, gerando relatório textual, tabela
    por blocos temporais e conjunto de gráficos PNG. foram criados a
    partir das necessidades reais identificadas ao analisar a primeira
    sessão experimental indoor.
    correções aplicadas após análise da sessão 01:
    - power_monitor: calibração empírica da tensão da bateria 3S LiPo
    para 11.0-13.6V, refletindo os valores reais medidos em bancada
    (a fórmula anterior 9.0-12.6V mantinha battery_percentage em 100%
    durante toda a sessão)
    - motor: remoção dos campos fabricados motor_tempe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
2026-04-14 feat: persistir force feedback e métricas de vídeo/filtros (client)
    as sessões experimentais precisavam de dados completos do force
    feedback e dos filtros PDI para análise pós-sessão. antes, apenas
    dados do rpi eram persistidos nos pickles.
    principais mudanças:
    - ForceFeedbackCalculator agora tem buffer de exportação próprio
    protegido por lock, alinhado perfeitamente ao timestamp (~100 Hz),
    evitando o problema de dessincronização da tentativa anterior que
    usava o raw_buffer do SensorManager
    - AutoSaveManager passa a exportar ff_*.pkl junto com sensors_*.pkl,
    telemetry_*.pkl e logs_*.txt, mantendo cada subsistema exportando
    o que ele conhece
    - 35 campos persistidos: fo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
    [camera_controls.py, main.py, network.py, session_plots.py]
2026-04-14 chore: remover tools e docs do versionamento
    pastas tools/ e docs/ contêm apenas utilitários e documentação
    interna que não precisam ficar no GitHub. arquivos continuam
    presentes localmente — apenas o tracking foi removido via
    git rm --cached. o .gitignore já estava atualizado.
2026-04-14 refactor: remover dead zone do motor e redistribuir marchas (transmissão)
    a zona morta de 0-6% do PWM com rampa linear de 40%/s era um
    artefato do modelo antigo que complicava a resposta ao degrau e
    não refletia o comportamento real do motor DC 775 montado. com a
    sua remoção, toda a faixa operacional é coberta pela ODE de 1ª
    ordem de forma contínua desde 0%.
    mudanças:
    - raspberry/managers/motor.py: removida a constante DEAD_ZONE_PWM
    e os 4 blocos de rampa linear em _apply_f1_acceleration. as
    marchas foram redistribuídas para cobrir 0-100% sem lacunas,
    mantendo sobreposição entre marchas adjacentes
    - novos limites: 1a (0-15%, K=20%), 2a (12-30%, K=40%),
    3a (25-50%, K=60%)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
2026-04-14 chore: mover servos de freio para canais 3 e 7 (brake)
    rearranjo do cabeamento físico no PCA9685 exigiu trocar os canais
    dos servos de freio. os canais 4 e 8 anteriores ficaram reservados
    e os freios passaram para 3 (frontal) e 7 (traseiro).
    atualização nas constantes FRONT_BRAKE_CHANNEL e REAR_BRAKE_CHANNEL
    em brake.py, além dos comentários, diagrama ASCII, script de teste
    direto, README do diretório test/, log de inicialização no main.py
    e menção na seção de metodologia da monografia.
2026-04-14 refactor: usar defaults dos managers para canais do PCA9685 (main)
    main.py estava passando canais e endereço I2C hardcoded para
    BrakeManager e SteeringManager, duplicando os valores que já
    existem como constantes de classe em brake.py e steering.py. isso
    criou um bug silencioso: quando os canais de freio foram movidos
    de 4/8 para 3/7 no brake.py, o main.py continuou injetando 4/8 e
    os servos físicos não respondiam ao pedal.
    removida a duplicação: main.py agora só passa parâmetros
    específicos do projeto (brake_balance, sensitivity, etc.) e
    deixa os canais caírem nos defaults das classes. fonte única
    da verdade fica em brake.py e steering.py.
    [main.py]
2026-04-14 refactor: limitar pwm do motor a 50% (transmissão)
    teto absoluto reduzido para proteger o diferencial do veículo;
    marchas, zonas de eficiência, gráficos e apêndice da monografia
    foram recalibrados para a nova faixa
2026-04-16 docs: reescrever frase do limitador de 50% do PWM (monografia)
    texto anterior estava verboso e repetitivo, simplificado
    para ficar mais direto e claro sobre a razão do limite
